santan444/MS-002P/03-设计开发输出阶段/02电子/05物料证书/12.交换机TEG1008M/TEG1008M.png

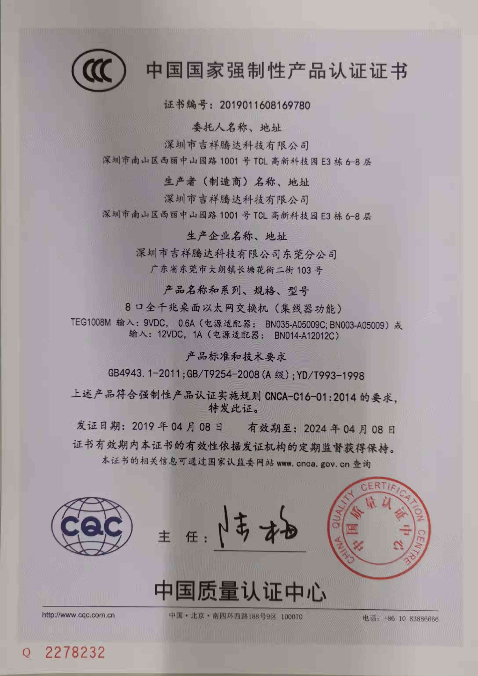
03-设计开发输出阶段/02电子/05物料证书/12.交换机TEG1008M/TEG1008M.png
