santan444/MS-002P/02-设计开发输入阶段/MS-002重要事项时间表.docx

文件号： | MS-002.10W012

重要事项时间表

骨科手术导航定位系统

MS-002

编制：

审核：

批准：

杭州三坛医疗科技有限公司

文档更改履历

版本号 | 发布/实施日期 | 更改内容概述 | 更改者
V1.0 | 2022.05.17 | 文件新编 | 洪洁

重要事项时间表

项目编号 MS-002

重要事项 | 状态 | 计划时间 | 调整后时间 | 实际时间
DCP0 | 已完成 | 2022.02 | / | 2022.02.08
TR1 | 已完成 | 2022.03 | / | 2022.03.29
DCP1 | 已完成 | 2022.03 | / | 2022.03.30
TR2 | 已完成 | 2022.04 | 2022.05 | 2022.05.17
DCP2 | 待完成 | 2022.04 | 2022.06 | /
TR3 | 待完成 | 2022.05 | 2022.06 | /
TR4 | 待完成 | 2022.08 | / | /
TR5 | 待完成 | 2022.11 | / | /
TR6 | 待完成 | 2023.01 | / | /
DCP3 | 待完成 | 2024.01~06 | / | /

MS-002 重要事项时间表 杭州三坛医疗科技有限公司
