santan444/MS-002P/02-设计开发输入阶段/评审类/MS-002TR2会议记录_20220517.docx

TR2评审纪要：@徐琦 @程焕 @严凌霄

系统方案设计，

1，部分器械，使用有效期50次，待确定；

2，加入反馈功能；

3，6.3，程序文件号+文件名，修改；

4，反光球，是否为一次性使用？以及何种无菌方式提供；

技术需求规格书，

1，6.2.4 爬电距离，绝缘路径，需要确定，是否修改？

2，6.9网络安全，进行补充；

3，非功能需求，6.1章节，加入UDI需求；

其他，

1，可用性任务分析，有更新H，请相应更新RAC；

记录编号：ST-ZD-52FM1 版本号：A/0 页码： 1 / 20
