santan444/MS-002P/03-设计开发输出阶段/04结构/03结构测试验证/MS-002台车外力失衡验证报告.docx

| 文件号： | | | | | MS-002.40W011

MS-002

台车外力失衡验证报告
编制人： | | | | 日期：
审核人： | | | | 日期：
批准人： | | | | 日期：

文档修订履历

版本号 | 发布日期 | 更改内容概述 | 更改者
V1.0 | 2022.xx.xx | 文件新编 | 钱华芳

保密条款

文档仅限产品（项目）组内流转，违者负相应法律责任。

目录

# 第1章 概述

## 1.1 验证目的

验证MS-002三台车在正常使用中，不应由于推拉、倚靠、搭放等外力原因造成失衡。

## 1.2 验证范围

验证范围为MS-002的三个台车：导航台车、操作台车和执行台车。

## 1.3 术语

无

## 1.4 法规标准

GB 9706.1-2020 《医用电气设备 第1部分：基本安全和基本性能的通用要求》

《MS-002技术需求规格书》

# 第2章 验证条件

## 2.1 验证对象

设备编号 | 设备名称 | 型号规格 | 备注
报告里写型检机编号 | MS-002导航台车 | MS-002-A
| MS-002执行台车 | MS-002-B
| MS-002操作台车 | MS-002-C

## 2.2 验证设备/工装/工具

设备编号 | 设备名称 | 型号规格 | 备注
/ | 推拉力计 | / | 量程200N以上
/ | 障碍物 | / | 最高不超过20mm
/ | 卷尺 | / | /
/ | 秒表 | / | /

## 2.3 验证地点

验证地点：车间。

## 2.4 验证时间

验证时间：2023年4月

## 2.5 验证环境

环境温度：10℃～30℃；

相对湿度：≤70%

## 2.6 验证小组

序号 | 岗位 | 验证人员 | 职责
1 | 机械工程师 | | 验证中的设备操作，进行相关过程数据记录，数据统计，编制报告
2 | 机械组主管 | | 审核报告

# 第3章 验证可接受准则

验证结果应符合GB/T 9706.1-2020 9.4.2.3章节指标要求，具体如下：

1) 在验证过程中，三台车均不发生失衡或者非预期的运动；

# 第4章 验证方法与步骤

## 4.1 验证方法

将三个台车放置在水平地面，并从除向上以外的任意方向对其施加等于其重量15%的外力，最大不超过150N。外力施加在台车的任意位置，但不超过距地面1.5m。使用一个水平方向的障碍物防止台车在地面上滑动，障碍物高度不超过20mm且紧固在地面上。施加外力包括前后左右周向力和向下的压力。

## 4.2 验证步骤

具体验证过程如下：

1. 将导航台车、执行台车和操作台车推到试验场地；
2. 将导航台车、执行台车和操作台车的脚轮刹车踩下；
3. 按照验证方案要求在台车不同位置施加周向力和向下的力，持续5s以上；施加周向力时，障碍物放置在脚轮前方并始终保持与周向力相对方向，防止台车受力过程中侧向移动；
4. 记录验证过程中台车的状况；

照片

# 第5章 验证结果与结论

验证结果记录如下表所示：

MS-002台车外力失衡验证记录表

结果记录
No. | 台车名称 | 施力方向 | 施力位置 | 施力大小 | 持续时间 | 结果
1 | 导航台车 | 前 | 外壳距离地面约1m四周 | 150N | 5s
| | 后 | | 150N | 5s
| | 左 | | 150N | 5s
| | 右 | | 150N | 5s
| | 上 | 把手上方 | 150N | 5s
2 | 执行台车 | 前 | 外壳距离地面约1m四周 | 150N | 5s
| | 后 | | 150N | 5s
| | 左 | | 150N | 5s
| | 右 | | 150N | 5s
| | 上 | 把手上方 | 150N | 5s
3 | 操作台车 | 前 | 工作台四周 | 130N | 5s
| | 后 | | 130N | 5s
| | 左 | | 130N | 5s
| | 右 | | 130N | 5s
| | 上 | 工作台上方 | 130N | 5s
4
5

根据以上结果可以得出结论：MS-002三台车设计满足法规要求，即在台车正常使用过程中，不会由于推拉、倚靠、搭放等外力原因造成失衡。

# 第6章 附件

N/A
