santan444/MS-002P/03-设计开发输出阶段/04结构/03结构测试验证/MS-002台车外壳推力验证报告.docx

| 文件号： | | | | | MS-002.40W017

MS-002

台车外壳推力验证报告
编制人： | | | | 日期：
审核人： | | | | 日期：
批准人： | | | | 日期：

文档修订履历

版本号 | 发布日期 | 更改内容概述 | 更改者
V1.0 | 2022.xx.xx | 文件新编

保密条款

文档仅限产品（项目）组内流转，违者负相应法律责任。

目录

# 第1章 概述

## 1.1 验证目的

验证MS-002三台车外壳是否有足够的刚度以避免不可接受的风险。

## 1.2 验证范围

MS-002的三台车（执行台车、导航台车、操作台车）外壳。

## 1.3 术语

无

## 1.4 法规标准

GB 9706.1-2020 《医用电气设备 第1部分：基本安全和基本性能的通用要求》

《MS-002技术需求规格书》

# 第2章 验证条件

## 2.1 验证对象

设备编号 | 设备名称 | 型号规格 | 备注
| MS-002导航台车 | MS-002-A
| MS-002执行台车 | MS-002-B
| MS-002操作台车 | MS-002-C

## 2.2 验证设备/工装/工具

设备编号 | 设备名称 | 型号规格 | 备注
/ | 推拉力计
| 秒表

## 2.3 验证地点

验证地点：公司实验室。

## 2.4 验证时间

验证时间：

## 2.5 验证环境

环境温度：10℃～30℃；

相对湿度：≤70%

；

## 2.6 验证小组

序号 | 岗位 | 验证人员 | 职责
1 | 机械工程师 | | 验证中的设备操作，进行相关过程数据记录，数据统计，编制报告
2 | 机械组主管 | | 审核报告

# 第3章 验证可接受准则

验证结果应符合GB/T 9706.1-2020 15.3.2章节指标要求，具体如下：

经过验证试验，外壳完好无损。

# 第4章 验证方法与步骤

## 4.1 验证方法

用直径为30mm的圆形平面试验工具，在外壳外部施加250N±10N的恒定作用力持续5s。

## 4.2 验证步骤

三台车的外壳上分别进行推力试验：

1) 将三台车推到开阔合适区域，脚轮刹住；
2) 在导航台车两侧面中间各选取一处相对薄弱区域，通过推拉力计施加250N±10N的恒定作用力持续5s，观察外壳变化；
3) 在执行台车两侧面中间各选取一处相对薄弱区域，通过推拉力计施加250N±10N的恒定作用力持续5s，观察外壳变化；
4) 在操作台车两侧面中间各选取一处相对薄弱区域，通过推拉力计施加250N±10N的恒定作用力持续5s，观察外壳变化；

# 第5章 验证结果与结论

经过上述推力测试后，台车外壳完好无损，表明外壳有足够的刚度以避免不可接受的风险。

补充照片
