santan444/MS-002P/03-设计开发输出阶段/04结构/03结构测试验证/MS-002台车越过门槛验证报告.docx

| 文件号： | | | | | MS-002.40W016

MS-002

台车越过门槛验证报告
编制人： | | | | 日期：
审核人： | | | | 日期：
批准人： | | | | 日期：

文档修订履历

版本号 | 发布日期 | 更改内容概述 | 更改者
V1.0 | 2023.xx.xx | 文件新编 | 陈侠

保密条款

文档仅限产品（项目）组内流转，违者负相应法律责任。

目录

# 第1章 概述

## 1.1 验证目的

验证MS-002三台车（超过45kg）是否可以越过10mm门槛且不导致失衡。

## 1.2 验证范围

MS-002的三个台车：导航台车、操作台车和执行台车。

## 1.3 术语

无

## 1.4 法规标准

GB 9706.1-2020 《医用电气设备 第1部分：基本安全和基本性能的通用要求》

《MS-002技术需求规格书》

# 第2章 验证条件

## 2.1 验证对象

设备编号 | 设备名称 | 型号规格 | 备注
| MS-002导航台车 | MS-002-A
| MS-002执行台车 | MS-002-B
| MS-002操作台车 | MS-002-C

## 2.2 验证设备/工装/工具

设备编号 | 设备名称 | 型号规格 | 备注
/ | 10x80x1000mm木板

## 2.3 验证地点

公司实验室。

## 2.4 验证时间

2022.xx~2023.xx

## 2.5 验证环境

环境温度：10℃～30℃；

相对湿度：≤70%

；

## 2.6 验证小组

序号 | 岗位 | 验证人员 | 职责
1 | 机械工程师 | | 验证中的设备操作，进行相关过程数据记录，数据统计，编制报告
2 | 机械组主管 | | 审核报告

# 第3章 验证可接受准则

验证结果应符合GB/T 9706.1-2020 9.4.2.4章节指标要求，具体如下：

正常推行MS-002三台车可以平稳越过10mm门槛且不发生失衡现象。

# 第4章 验证方法与步骤

## 4.1 验证方法

MS-002三台车重量都超过45kg，因此都需要进行过门槛试验。

MS-002三台车以正常使用的速度推行，向前越过一个紧固与地面的垂直固定障碍物10次（上去和下来），确认台车是否可以平稳通过并不发生失衡现象。障碍物横断面应是高10mm±0.5mm、宽至少80mm的矩形，且棱边倒圆角2mm±0.1mm；

## 4.2 验证步骤

MS-002三台车推到试验场地分别进行过门槛试验：

1) 将障碍物放置在试样场地开阔区域，两人分别踩住障碍物两端，确保试验过程中障碍物不轻易发生移动；
2) 将导航台车推到障碍物前一段距离静止，向前推动导航台车到一定速度越过障碍物；
3) 台车越过障碍物后停止并向后移动退出障碍物；
4) 重复上述步骤10次，目视台车是否可以完整越过障碍物以及过程中是否出现失衡现象；
5) 将执行台车、操作台车推到障碍物前，重复上述步骤并目视确认台车是否可以完整越过障碍物以及过程中是否出现失衡现象；

# 第5章 验证结果与结论

三台车分别都可以完整平稳越过障碍物，且过程中没有出现失衡等现象。

补充照片
