santan444/MS-002P/03-设计开发输出阶段/04结构/03结构测试验证/MS-002操作台车热仿真分析报告.docx

| 文件号： | | | | | MS-002.43W002

MS-002

操作台车热仿真分析报告
编制人： | | | | 日期：
审核人： | | | | 日期：
批准人： | | | | 日期：

文档修订履历

版本号 | 发布日期 | 更改内容概述 | 更改者
V1.0 | 2022.00.00 | 文件新编 | 陈侠

保密条款

文档仅限产品（项目）组内流转，违者负相应法律责任。

目录

# 1. 概述

操作台车主要电气件包括显示器、电源适配器、键盘、鼠标等，其中电源适配器对台车内温度影响较大。显示器、键盘、鼠标都是标准件且外露，不存在散热风险。

本次热仿真分析对实际模型进行一定程度的简化，忽略对空气流动、散热影响较小的结构，方便计算。

# 2. 模型优化

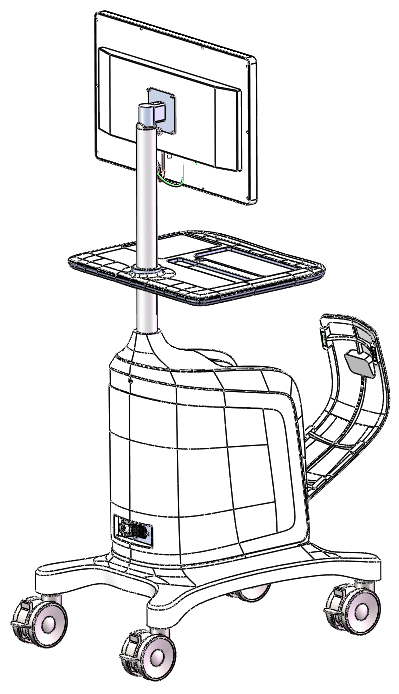
[picture p151: figure]
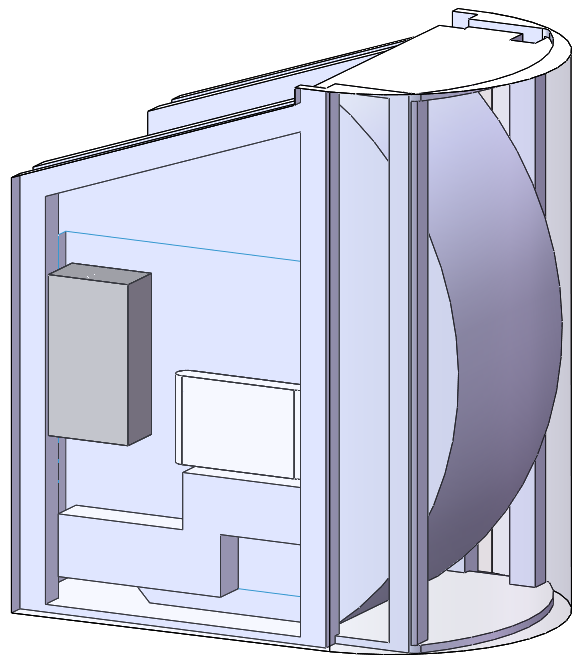
[picture p152: figure]

原始模型 简化模型

# 3. 边界条件

环境温度：操作台车通常在手术室内工作，环境温度一般恒温，本次分析定义为26℃。

热源：电源适配器对台车内温度影响较大，电气件的工作效率一般在80%~95%之间，本次分析定义其散热功率为其正常工作功率的10%，具体数值如下：

序号 | 名称 | 工作功率（W） | 发热率（W/m3）
1 | 显示器适配器 | 36 | 22857.1

整机电气件发热量少，通过自然热交换散热即可满足要求。

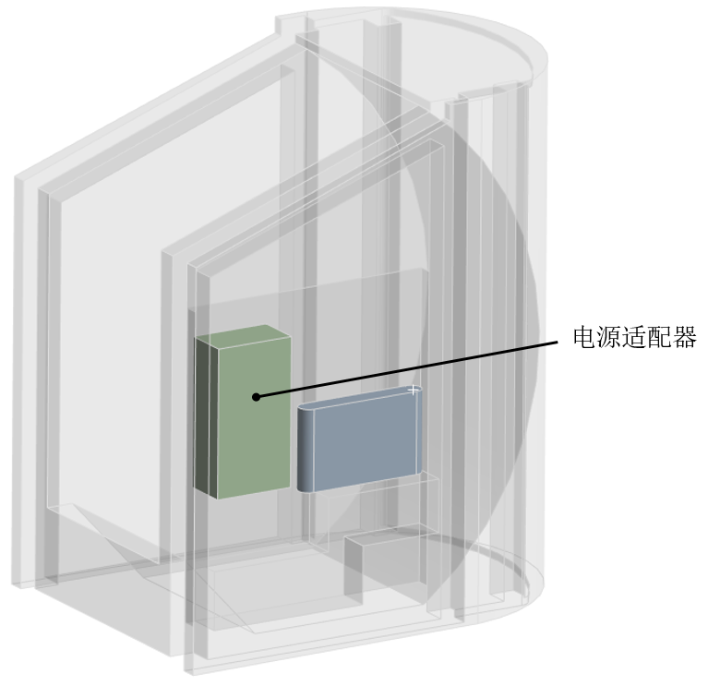
[picture p153: figure]

# 4. 仿真分析结果

台车内部最高温为30℃，位于电源适配器表面，同时腔内大部分温度为26.5℃左右。

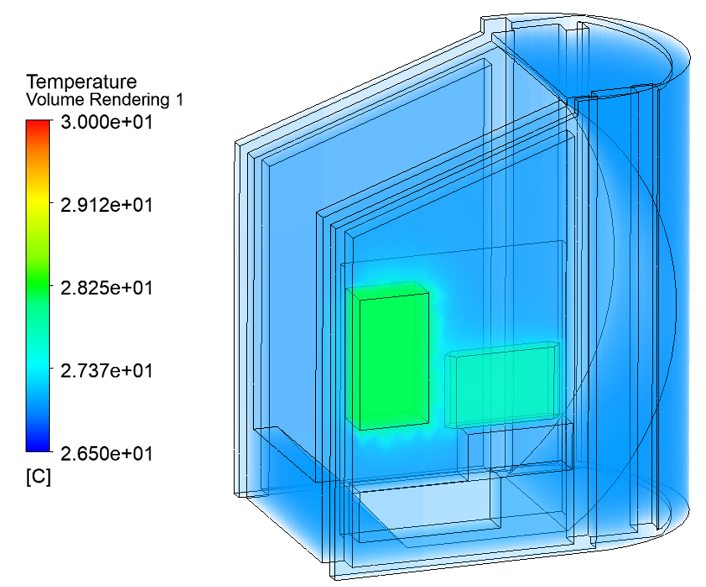
[picture p154: figure]

温度体积云图

# 5. 结论

操作台车内部空气温度仅上升0.5℃，基本可以忽略不计，符合工作温度要求。

MS-002.43W002 操作台车热仿真分析报告 杭州三坛医疗科技有限公司
