santan444/MS-002P/03-设计开发输出阶段/04结构/02包装及标签/MS-002 标签、标识粘贴说明.docx

| 文件号： | | | | | MS-002.40W007

MS-002

标签、标识粘贴说明
编制人： | | | | 日期：
审核人： | | | | 日期：
批准人： | | | | 日期：

文档修订履历

版本号 | 发布日期 | 更改内容概述 | 更改者
V1.0 | 2022.xx.xx | 文件新编 | 陈侠

保密条款

文档仅限产品（项目）组内流转，违者负相应法律责任。

目录

# 1. 标签粘贴位置

## 1.1. 导航台车

### 1.1.1. 标签粘贴位置

序号 | 标签 | 位置

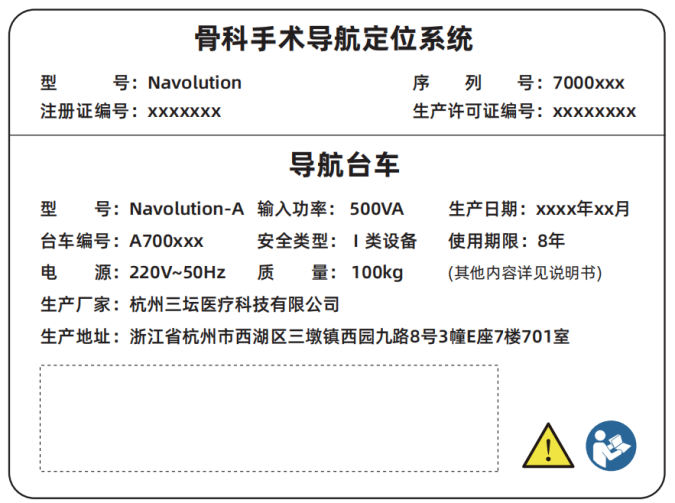
[picture p176: figure]

1

### 1.1.2. 标识粘贴位置

序号 | 标识 | 说明 | 位置
1 | | 显示器左右旋30°
3 | | 双目相机左右旋
4 | | 保护接地
5 | | 火线
6 | | 零线

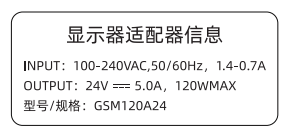
[picture p177: figure]

7 | | 显示器适配器信息 | 显示器适配器安装支架上
8 | | 导航台车-显示器 | 备注：标签需盖住所有按键（不能盖住指示灯）

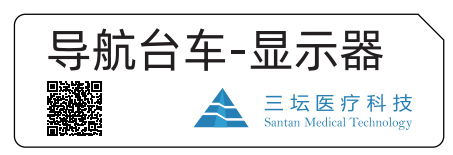
[picture p178: figure]

9 | | 导航台车-显示器 | 备注：贴标签时，需将原有全部标签撕下，并对撕下处进行处理，保证粘贴新标签时完好无损。
10 | | 鼠标收纳壳最大悬挂重量440g
11 | | 显示器支架最大悬挂重量29.2kg

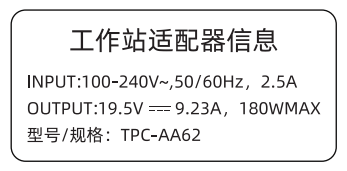
[picture p179: figure]

| | 工作站适配器信息

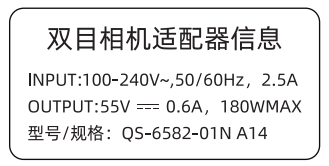
[picture p180: figure]

| | 双目相机适配器信息
| | 双目相机

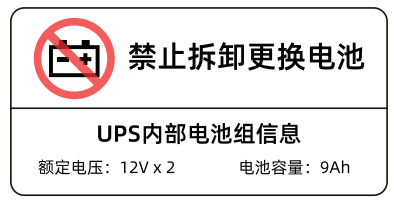
[picture p181: figure]

| | UPS

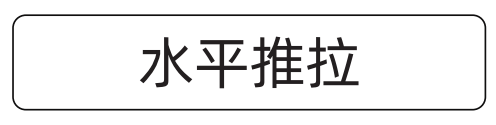
[picture p182: figure]

## 1.2. 执行台车

### 1.2.1. 标签粘贴位置

序号 | 标签 | 位置

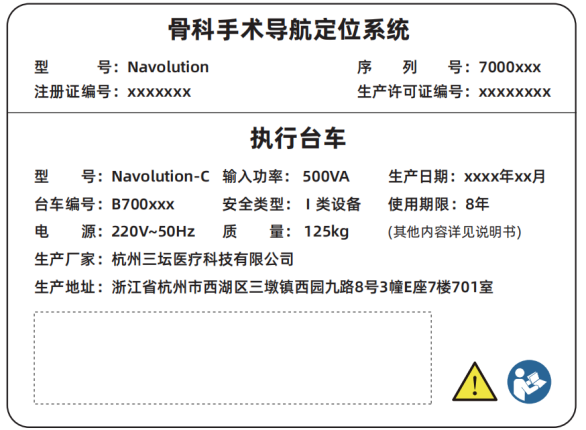
[picture p183: figure]

1

### 1.2.2. 标识粘贴位置

序号 | 标识信息 | 说明 | 位置
3 | | 保护接地
4 | | 功能接地
5 | | 火线
6 | | 零线
7 | | 机械臂最大负荷5kg

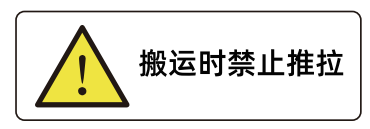
[picture p184: figure]

8 | | 移动台车时禁止推拉机械臂

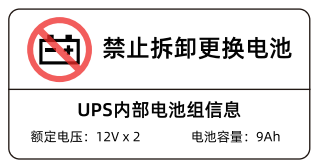
[picture p185: figure]

9 | | 禁止用户拆卸电池

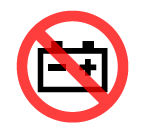
[picture p186: figure]

10 | | 注意电池极性，查看维护手册 | 备注：UPS改装时直接粘贴
11

## 1.3. 操作台车

### 1.3.1. 标签粘贴位置

序号 | 标签 | 位置

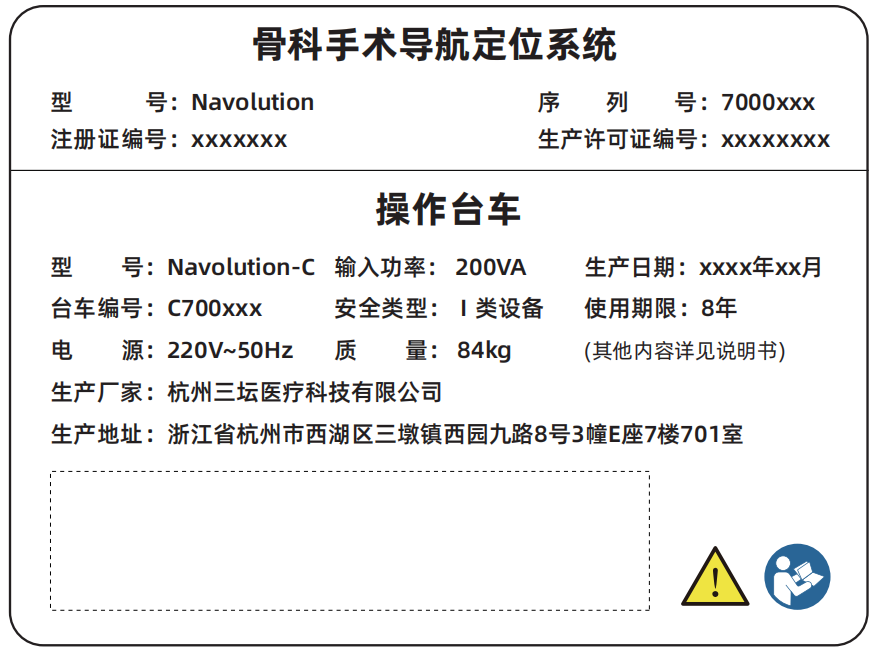
[picture p187: figure]

1

### 1.3.2. 标识粘贴位置

序号 | 标识信息 | 说明 | 位置
1
| | 保护接地
| | 功能接地
| | 火线
| | 零线
| | 显示器适配器信息 | 显示器适配器安装支架上

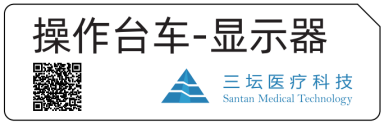
[picture p188: figure]

# 2. 标签、标识粘贴要求

1) 各标签粘贴在其相应位置；
2) 粘贴应平整、不歪斜、不翘起、标贴表面无损伤、无污染；
3) 不得多贴或少贴；

# 3. 标签、标识材质要求

1) 肖银龙不干胶
2) 背景哑银
3) 表面哑膜
