santan444/MS-002P/03-设计开发输出阶段/01系统/MS-002物理拓扑图.png

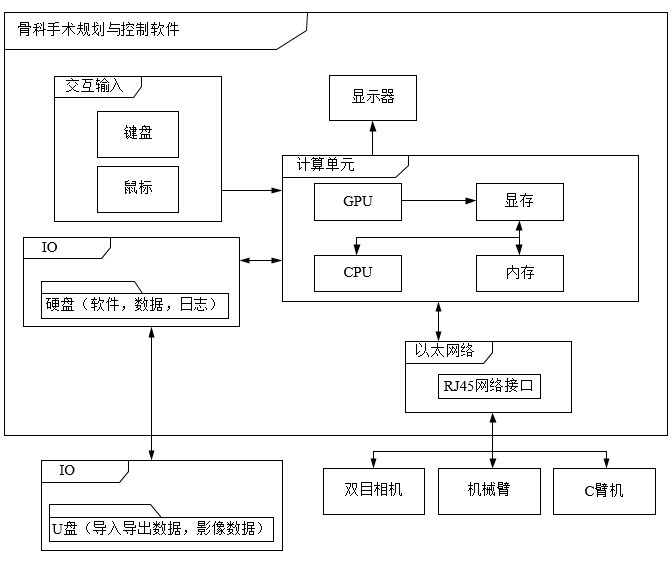
03-设计开发输出阶段/01系统/MS-002物理拓扑图.png
