santan444/MS-002P/03-设计开发输出阶段/02电子/05物料证书/7.脚踏/无线脚踏/TRE18090108  IEC60601-1-2 SUNS WIRELESS FOOT SWITCH.pdf

## TES

## ST REPO

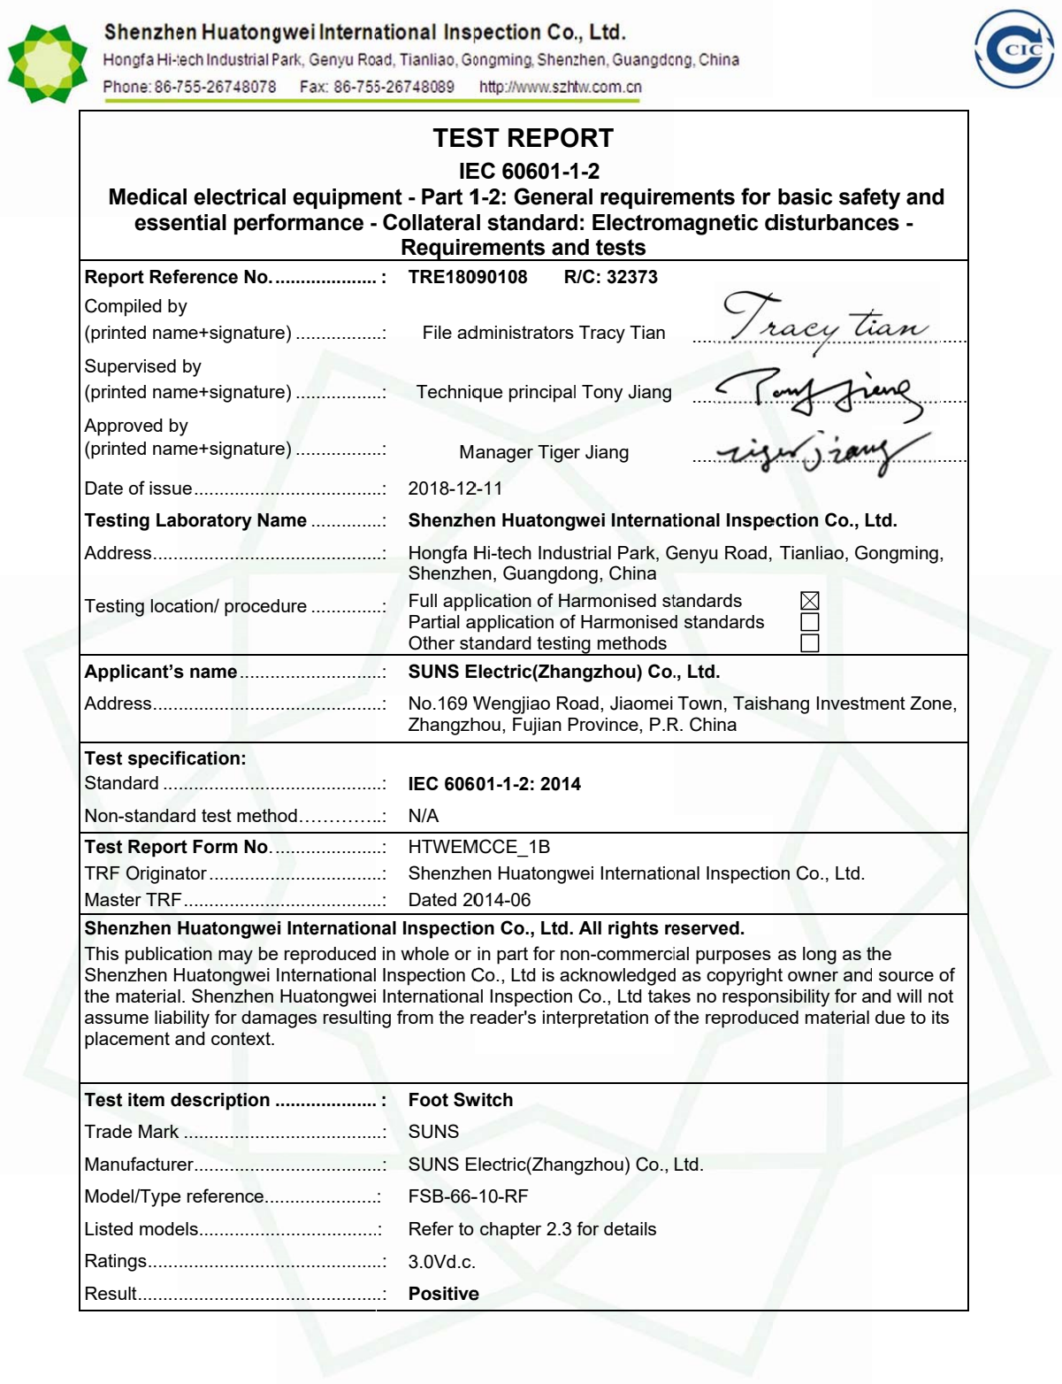
[picture p304: page 1]

### Medica esse

Report Ref
Compiled b
(printed nam
Supervised
(printed nam
Approved b
(printed nam

Date of issu
Testing La
Address .....

Testing loca

Applicant’s
Address .....

Test specif
Standard ...
Non-standa
Test Repor
TRF Origina
Master TRF
Shenzhen
This publica
Shenzhen H
the materia
assume liab
placement a

Test item d
Trade Mark
Manufacture
Model/Type
Listed mode
Ratings ......
Result ........

### al electrica ential perfo

ference No. .
y
me+signature
by
me+signature
y
me+signature
ue |
boratory Na

ation/ proced

s name ........

fication:
ard test meth
rt Form No. .
ator |
Huatongwe
ation may be
Huatongwei
l. Shenzhen
bility for dam
and context.

description .
er |
e reference...
els |

### al equipme ormance -

e) |
e) |
e) |
ame |
dure |
od |
i Internation
e reproduced
International
Huatongwei
ages resultin

IE

### ent - Part 1 Collatera Require

: TRE180

. : | File ad
. : | Techniq
. : | Ma

. : 2018-12
. : Shenzhe
. : Hongfa H
| Shenzhe
. : Full appl
| Partial a Other sta

. : SUNS E
. : No.169 W
| Zhangzh

. : IEC 606
.: N/A
. : HTWEM
. : Shenzhe
. : Dated 20
nal Inspectio
in whole or
Inspection C
Internationa
ng from the r

: Foot Sw
. : SUNS
. : SUNS E
: | FSB-66-
: | Refer to
. : 3.0Vd.c.
. : Positive

EC 60601-1

### -2: Gener l standard ements an

090108 R

dministrators

que principal

anager Tige

-11
en Huatong
Hi-tech Indus
en, Guangdo
lication of Ha
application of
andard testin
Electric(Zhan
Wengjiao Ro
hou, Fujian P

01-1-2: 2014

MCCE_1B
en Huatongw
014-06
on Co., Ltd.
in part for no
Co., Ltd is ac
al Inspection
reader's inter

witch

Electric(Zhang
10-RF
chapter 2.3

## ORT

-2

### ral require d: Electrom nd tests

R/C: 32373

Tracy Tian

l Tony Jiang

r Jiang

gwei Internat
strial Park, G
ong, China
armonised st
f Harmonised
ng methods
ngzhou) Co.
oad, Jiaomei
Province, P.R

wei Internatio

All rights re
on-commerci
cknowledged
Co., Ltd take
rpretation of

gzhou) Co.,

for details

### ments for magnetic d

tional Inspe
Genyu Road,

tandards
d standards

., Ltd.
Town, Taish
. China

onal Inspectio

eserved.
ial purposes
d as copyrigh
es no respon
the reproduc

Ltd.

### basic safe disturbanc

ection Co., L
Tianliao, Go

hang Investm

on Co., Ltd.

as long as t
ht owner and
nsibility for a
ced material

### ety and ces -

Ltd.
ongming,

ment Zone,

he
source of
nd will not
due to its

Report No.: TRE18090108 | Page 2 of 30 | Issued: 2018-12-11

## EMC -- T E S T R E P O R T

Test Report No. : | TRE18090108 | 2018-12-11 ______________________________________________________________________________________________ Date of issue
Equipment under Test | : | Foot Switch
Model /Type | : | FSB-66-10-RF
Listed Models | : | Refer to chapter 2.3 for details
Applicant | : | SUNS Electric(Zhangzhou) Co., Ltd.
Address | : | No.169 Wengjiao Road, Jiaomei Town, Taishang Investment Zone, Zhangzhou, Fujian Province, P.R. China
Manufacturer | : | SUNS Electric(Zhangzhou) Co., Ltd.
Address | : | No.169 Wengjiao Road, Jiaomei Town, Taishang Investment Zone, Zhangzhou, Fujian Province, P.R. China

Test Result according to the
standards on page 4: | Positive

The test report merely corresponds to the test sample.
It is not permitted to copy extracts of these test result without the written permission of the test laboratory.

Report No.: TRE18090108 | Page 3 of 30 | Issued: 2018-12-11

## Contents

1. ! T E S T S T A N D A R D S | 4 !
2. ! SUMMARY | 5 !
2.1.! | General Remarks | 5!
2.2.! | Equipment Under Test | 5!
2.3.! | Short description of the Equipment under Test (EUT) | 5!
2.4.! | EUT operation mode | 5!
2.5.! | EUT configuration | 6!
2.6.! | IMMUNITY pass/fail criteria: | 6!
3. ! T E S T E N V I R O N M E N T | 7 !
3.1.! | Address of the test laboratory | 7!
3.2.! | Test Facility | 7!
3.3.! | Environmental conditions | 8!
3.4.! | Test Description | 8!
3.5.! | Statement of the measurement uncertainty | 12!
3.6.! | Equipments used during the Test | 13!
4. ! TEST CONDITION S AND RESU L T S | 1 5 !
4.1.! | Radiated Emission | 15!
4.2.! | Conducted disturbance | 19!
4.3.! | Harmonic current | 19!
4.4.! | Voltage Fluctuation and Flicker | 19!
4.5.! | Electrostatic discharge | 20!
4.6.! | Radiated, radio-frequency, electromagnetic field | 22!
4.7.! | Electrical fast transients / Burst | 24!
4.8.! | Surge | 24!
4.9.! | Conducted disturbances induced by radio-frequency fields | 24!
4.10.! Magnetic Field Immunity | 25!
4.11.! Voltage Dips and Interruptions | 26!
5. ! EXTERNAL AND INTERNAL PH O T O S O F T H E E U T | 2 7 !
5.1.! | External Photos of the EUT | 27!
5.2.! | Internal photos of the EUT | 29!

Report No.: TRE18090108 | Page 4 of 30 | Issued: 2018-12-11

## 1 . T E S T S T A N D A R D S

The tests were performed according to following standards:

IEC 60601-1-2: 2014 Medical electrical equipment - Part 1-2: General requirements for basic safety and essential performance - Collateral standard: Electromagnetic disturbances - Requirements and tests

Remark: This EUT is ranged to the Group 1 Class B apparatus according to the standard of CISPR 11: 2015+A1: 2016 clause 5.2.

Report No.: TRE18090108 | Page 5 of 30 | Issued: 2018-12-11

## 2 . S U M M A R Y

### 2.1. General Remarks

Date of receipt of test sample | : | 2018-12-04
Testing commenced on | : | 2018-12-04
Testing concluded on | : | 2018-12-11

### 2.2. Equipment Under Test

### Power supply system utilised

Power supply voltage | : o 230V / 50 Hz | o 120V / 60Hz
o 12 V DC | o 24 V DC
■ Other (specified in blank below)

3.0Vd.c.(internal battery)

### 2.3. Short description of the Equipment under Test (EUT)

The EUT is a foot switch.

It’s applicable for use with medical equipment.

Tests were carried out on model FSB-66-10-RF to represent all other foot switches series: FS-2, FS-6, FS-7, FS-8, FS-9, FCP, FSB, FSR, FWC series. All these foot switch models use exactly the same PCB circuit and RF receiver.

LOT No.: 2018-10-22

### 2.4. EUT operation mode

The equipment under test was operated during the measurement under the following conditions:

Test with frequency wireless supplied by 12V battery.

The EUT is measuring during the test.

Test program (customer specific)

Emissions tests | : According to IEC 60601-1-2 searching for the highest disturbance.
Immunity tests | : According to IEC 60601-1-2 searching for the highest susceptivity.
Harmonics current | : Not performed according to IEC 61000-3-2.
Voltage fluctuation………: Not performed according to IEC 61000-3-3.

Report No.: TRE18090108 | Page 6 of 30 | Issued: 2018-12-11

### 2.5. EUT configuration

The following peripheral devices and interface cables were connected during the measurement:

■ - supplied by the manufacturer

o - supplied by the lab

### 2.6. IMMUNITY pass/fail criteria:

Examples of test failures:
– malfunction;
– non-operation when operation is required;
– unwanted operation when no operation is required;
– deviation from normal operation that poses an unacceptable RISK to the PATIENT or OPERATOR; – component failures;
– change in programmable parameters;
– reset to factory defaults (MANUFACTURER’s presets);
– change of operating mode;
– a FALSE POSITIVE ALARM CONDITION;
– a FALSE NEGATIVE ALARM CONDITION (failure to alarm);
– cessation or interruption of any intended operation, even if accompanied by an ALARM SIGNAL; – initiation of any unintended operation, including unintended or uncontrolled motion, even if accompanied by an ALARM SIGNAL;
– error of a displayed numerical value sufficiently large to affect diagnosis or treatment;
– noise on a waveform in which the noise would interfere with diagnosis, treatment or monitoring; – artefact or distortion in an image in which the artefact would interfere with diagnosis, treatment or monitoring;
– failure of automatic diagnosis or treatment ME EQUIPMENT or ME SYSTEM to diagnose or treat, even if accompanied by an ALARM SIGNAL.

During the test, frequency wireless is abnormal response.

■ Frequency wireless | Manufacture : SUNS Electric(Zhangzhou) Co., Ltd. M/N : RCV-RF-10A-6

## 3 . T E S T E N V I R O N M E N T

### 3.1. Address of the test laboratory

Shenzhen Huatongwei International Inspection Co., Ltd.
Hongfa Hi-tech Industrial Park, Genyu Road, Tianliao, Gongming, Shenzhen, Guangdong, China Tel: 86-755-26748019 Fax: 86-755-26748089

### 3.2. Test Facility

The test facility is recognized, certified, or accredited by the following organizations:

### CNAS-Lab Code: L1225

Shenzhen Huatongwei International Inspection Co., Ltd. has been assessed and proved to be in compliance with CNAS-CL01 Accreditation Criteria for Testing and Calibration Laboratories (identical to ISO/IEC 17025: 2005 General Requirements) for the Competence of Testing and Calibration Laboratories,

### A2LA-Lab Cert. No. 3902.01

Shenzhen Huatongwei International Inspection Co., Ltd. EMC Laboratory has been accredited by A2LA for technical competence in the field of electrical testing, and proved to be in compliance with ISO/IEC 17025: 2005 General Requirements for the Competence of Testing and Calibration Laboratories and any additional program requirements in the identified field of testing.

### FCC-Registration No.: 762235

Shenzhen Huatongwei International Inspection Co., Ltd. EMC Laboratory has been registered and fully described in a report filed with the FCC (Federal Communications Commission). The acceptance letter from the FCC is maintained in our files. Registration No: 762235.

### IC-Registration No.: 5377B-1, 5377B-2

Two 3m Alternate Test Site of Shenzhen Huatongwei International Inspection Co., Ltd. has been registered by Certification and Engineering Bureau of Industry Canada for the performance of radiated measurements with Registration No. 5377B.

### ACA

Shenzhen Huatongwei International Inspection Co., Ltd. EMC Laboratory can also perform testing for the Australian C-Tick mark as a result of our A2LA accreditation.

### VCCI

Radiated disturbance above 1GHz measurement of Shenzhen Huatongwei International Inspection Co., Ltd. has been registered in accordance with the Regulations for Voluntary Control Measures with Registration No.: G-20007.

Main Ports Conducted Interference Measurement of Shenzhen Huatongwei International Inspection Co., Ltd. Has been registered in accordance with the Regulations for Voluntary Control Measures with Registration No.: C-20001.

Telecommunication Ports Conducted Interference Measurement of Shenzhen Huatongwei International Inspection Co., Ltd. has been registered in accordance with the Regulations for Voluntary Control Measures with Registration No.: T-20001.

The 3m Semi-anechoic chamber (9.1m×6.4m×6.0m) of Shenzhen Huatongwei International Inspection Co., Ltd. has been registered in accordance with the Regulations for Voluntary Control Measures with Registration No.:R-4398.

Report No.: TRE18090108 | Page 8 of 30 | Issued: 2018-12-11

### 3.3. Environmental conditions

During the measurement the environmental conditions were within the listed ranges:

Temperature: | 22-25°C
Humidity: | 40-58 %
Atmospheric pressure: | 950-1050mbar

### 3.4. Test Description

Emission Measurement
Radiated Emission | IEC 60601-1-2: 2014 CISPR 11: 2015+A1: 2016 | PASS
Conducted Disturbance (0.15-30MHz) | IEC 60601-1-2: 2014 CISPR 11: 2015+A1: 2016 | N/A
Harmonic Current | IEC 60601-1-2: 2014 IEC 61000-3-2: 2014 | N/A
Voltage Fluctuation and Flicker | IEC 60601-1-2: 2014 IEC 61000-3-3: 2013 | N/A

Immunity Measurement
Electrostatic Discharge | IEC 60601-1-2: 2014 IEC 61000-4-2: 2008 | PASS
RF Field Strength Susceptibility (80~2700MHz) | IEC 60601-1-2: 2014 IEC61000-4-3: 2006+A1: 2007+A2: 2010 | PASS
Electrical Fast Transient/Burst Test | IEC 60601-1-2: 2014 IEC 61000-4-4: 2012 | N/A
Surge Test | IEC 60601-1-2: 2014 IEC 61000-4-5: 2014 | N/A
Conducted Susceptibility Test | IEC 60601-1-2: 2014 IEC 61000-4-6: 2013 | N/A
Power Frequency Magnetic Field Susceptibility Test | IEC 60601-1-2: 2014 IEC 61000-4-8: 2009 | PASS
Voltage Dips and Interruptions Test | IEC 60601-1-2: 2014 IEC 61000-4-11: 2004 | N/A

Note: “N/A” means “not applicable”.
The measurement uncertainty is not included in the test result.

Report No.: TRE18090108 | Page 9 of 30 | Issued: 2018-12-11
| IEC 60601-1-2: 2014
Clause | Requirement + Test | Result - Remark | Verdict
5 ME EQUIPMENT and ME SYSTEMS identification, marking and | documents | | PASS
5.1 Additional requirements for marking on the outside of ME EQUIPMENT | and ME SYSTEMS that are specified for use only in a shielded location SPECIAL ENVIRONMENT | | N/A
| In addition to the requirements of 7.2 of the general standard, ME EQUIPMENT and ME SYSTEMS specified for use only in a shielded location SPECIAL ENVIRONMENT shall be labelled with a CLEARLY LEGIBLE warning that they should be used only in the specified type of shielded location. | | N/A
5.2 | ACCOMPANYING DOCUMENTS | | PASS
5.2.1 | Instructions for use | | PASS
5.2.1.1 | General | | PASS
a) a statement of the environments for which the | ME EQUIPMENT or ME SYSTEM is suitable. Relevant exclusions, as determined by RISK ANALYSIS, shall also be listed, e.g. hospitals except for near active HF SURGICAL EQUIPMENT and the RF shielded room of an ME SYSTEM for magnetic resonance imaging, where the intensity of EM DISTURBANCES is high. | Please refer to User manual | PASS
b) the performance of the ME EQUIPMENT or | ME SYSTEM that was determined to be ESSENTIAL PERFORMANCE and a description of what the OPERATOR can expect if the ESSENTIAL PERFORMANCE is lost or degraded due to EM DISTURBANCES (the defined term “ESSENTIAL PERFORMANCE” need not be used). | Please refer to User manual | PASS
c) a warning statement to the effect that | “WARNING: Use of this equipment adjacent to or stacked with other equipment should be avoided because it could result in improper operation. If such use is necessary, this equipment and the other equipment should be observed to verify that they are operating normally.” The MANUFACTURER of the ME EQUIPMENT or ME SYSTEM may provide a description or list of equipment with which the ME EQUIPMENT or ME SYSTEM has been tested in a stacked or adjacent configuration and with which stacked or adjacent use resulted in normal operation. | Please refer to User manual | PASS

Report No.: TRE18090108 | Page 10 of 30 | Issued: 2018-12-11
d) a list of all cables and maximum lengths of | cables (if applicable), transducers and other ACCESSORIES that are replaceable by the RESPONSIBLE ORGANIZATION and that are likely to affect compliance of the ME EQUIPMENT or ME SYSTEM with the requirements of Clause 7 (EMISSIONS) and Clause 8 (IMMUNITY). ACCESSORIES may be specified either generically (e.g. shielded cable, load impedance) or specifically (e.g. by MANUFACTURER and MODEL OR TYPE REFERENCE). Transducers and cables specified by the MANUFACTURER of the ME EQUIPMENT or ME SYSTEM as replacement parts for internal components need not be listed. | Please refer to User manual | PASS
e) a warning statement to the effect that | “WARNING: Use of accessories, transducers and cables other than those specified or provided by the manufacturer of this equipment could result in increased electromagnetic emissions or decreased electromagnetic immunity of this equipment and result in improper operation.” | Please refer to User manual | PASS
f) a warning statement to the effect that: | “WARNING: Portable RF communications equipment (including peripherals such as antenna cables and external antennas) should be used no closer than 30 cm (12 inches) to any part of the [ME EQUIPMENT or ME SYSTEM], including cables specified by the manufacturer. Otherwise, degradation of the performance of this equipment could result.” In the above warning, “[ME EQUIPMENT or ME SYSTEM]” shall be replaced with the MODEL OR TYPE REFERENCE of the ME EQUIPMENT or ME SYSTEM. | Please refer to User manual | PASS
| If higher IMMUNITY TEST LEVELS than those specified in Table 9 are used, the minimum separation distance may be lowered. Lower minimum separation distances shall be calculated using the equation specified in 8.10. | | N/A
5.2.1.2 | Requirements applicable to ME EQUIPMENT and ME SYSTEMS classified class A according to CISPR 11 | | N/A

In addition to the requirements of 7.9.2 of the general standard, for ME EQUIPMENT and ME SYSTEMS that are classified class A according to CISPR 11, the instructions for use shall include the following note:
The EMISSIONS characteristics of this equipment make it suitable for use in industrial areas and hospitals (CISPR 11 class A). If it is used in a residential environment (for which CISPR 11 class B is normally required) this equipment might not offer adequate protection to radio-frequency communication services. The user might need to take mitigation measures, such as relocating or re-orienting the equipment.

N/A

5.2.2 | Technical description | PASS
5.2.2.1 | Requirements applicable to all ME EQUIPMENT and ME SYSTEMS | PASS

Report No.: TRE18090108 | Page 11 of 30 | Issued: 2018-12-11
| In addition to the requirements of 7.9.3 of the general standard, the technical description shall describe precautions to be taken to prevent adverse events to the PATIENT and OPERATOR due to ELECTROMAGNETIC DISTURBANCES. For all ME EQUIPMENT and ME SYSTEMS, the technical description shall include the following information:
a) the compliance for each EMISSIONS and | IMMUNITY standard or test specified by this collateral standard, e.g. EMISSIONS class and group and IMMUNITY TEST LEVEL. | Please refer to User manual | PASS
b) any deviations from this collateral standard | and allowances used. | | N/A
c) all necessary instructions for maintaining | BASIC SAFETY and ESSENTIAL PERFORMANCE with regard to ELECTROMAGNETIC DISTURBANCES for the EXPECTED SERVICE LIFE. | Please refer to User manual | PASS
5.2.2.2 | Requirements applicable to ME EQUIPMENT and ME SYSTEMS specified for use only in a shielded location SPECIAL ENVIRONMENT | | N/A
| In addition to the requirements of 7.9.3 of the general standard, for ME EQUIPMENT and ME SYSTEMS specified for use only in a shielded location (see 7.1.5), the technical description shall include the following information: | | N/A
a) a warning to the effect that: “WARNING: | Failure to use this equipment in the specified type of shielded location could result in degradation of the performance of this equipment, interference with other equipment or interference with radio services”; | | N/A
b) specifications for the shielded location, | including: – minimum RF shielding effectiveness; – for each cable that enters or exits the shielded location, the minimum RF filter attenuation; and – the frequency range(s) over which the specifications apply; | | N/A
c) recommended test methods for measurement | of RF shielding effectiveness and RF filter attenuation; | | N/A
d) one or more of the following and a | recommendation that a notice containing this information be posted at the entrance(s) to the shielded location: – a specification of the EMISSIONS characteristics of other equipment allowed inside the shielded location with the ME EQUIPMENT or ME SYSTEM; – a list of specific equipment allowed; – a list of types of equipment prohibited. | | N/A
5.2.2.3 | Requirements applicable to ME EQUIPMENT that intentionally receives RF electromagnetic energy for the purpose of its operation | | N/A
| In addition to the requirements of 7.9.3 of the general standard, for ME EQUIPMENT that intentionally receives RF electromagnetic energy for the purpose of its operation (RF receivers), the technical description shall include the following information: | | N/A

Report No.: TRE18090108 | Page 12 of 30 | Issued: 2018-12-11
| – each frequency or frequency band of reception; – the preferred frequency or frequency band, if applicable; – the bandwidth of the receiving section of the ME EQUIPMENT in those bands.
5.2.2.4 | Requirements applicable to ME EQUIPMENT that includes RF transmitters | N/A
| In addition to the requirements of 7.9.3 of the general standard, for ME EQUIPMENT that includes RF transmitters, the technical description shall include each frequency or frequency band of transmission, the type and frequency characteristics of the modulation and the EFFECTIVE RADIATED POWER | N/A
5.2.2.5 | Requirements applicable to PERMANENTLY INSTALLED LARGE ME EQUIPMENT and LARGE ME SYSTEMS | N/A
| In addition to the requirements of 7.9.3 of the general standard, for PERMANENTLY INSTALLED LARGE ME EQUIPMENT and LARGE ME SYSTEMS for which the exemption specified in 8.6 from the testing requirements of IEC 61000-4-3 is used, the technical description shall include the following information: | N/A
a) a statement that an exemption has been used | and that the equipment has not been tested for radiated RF IMMUNITY over the entire frequency range 80 MHz to 6 000 MHz; | N/A
b) a warning to the effect that “WARNING: This | equipment has been tested for radiated RF immunity only at selected frequencies, and use nearby of emitters at other frequencies could result in improper operation”; | N/A
c) a list of the frequencies and modulations used | to test the IMMUNITY of the ME EQUIPMENT or ME SYSTEM. | N/A
5.2.2.6 | Requirements applicable to ME EQUIPMENT and ME SYSTEMS that claim compatibility with HF SURGICAL EQUIPMENT | N/A
| In addition to the requirements of 7.9.3 of the general standard, for ME EQUIPMENT and ME SYSTEMS that claim compatibility with HF SURGICAL EQUIPMENT, the technical description shall include a statement of HF SURGICAL EQUIPMENT compatibility and the conditions of INTENDED USE during HF surgery. | N/A

### 3.5. Statement of the measurement uncertainty

The data and results referenced in this document are true and accurate. The reader is cautioned that there may be errors within the calibration limits of the equipment and facilities. The measurement uncertainty was calculated for all measurements listed in this test report acc. to CISPR 16 - 4 „Specification for radio disturbance and immunity measuring apparatus and methods – Part 4: Uncertainty in EMC Measurements“ and is documented in the Shenzhen Huatongwei International Inspection Co., Ltd quality system acc. to DIN EN ISO/IEC 17025. Furthermore, component and process variability of devices similar to that tested may result in additional deviation. The manufacturer has the sole responsibility of continued compliance of the device.

Hereafter the best measurement capability for Shenzhen Huatongwei laboratory is reported:

Test | Range | Measurement Uncertainty | Notes
Radiated Emission | 30~1000MHz | 4.28 dB | (1)

Report No.: TRE18090108 | Page 13 of 30 | Issued: 2018-12-11
(1) This uncertainty represents an expanded uncertainty expressed at approximately the 95% confidence level using a coverage factor of k=2.

### 3.6. Equipments used during the Test

Radiated Emission/ Radiated power
Item | Test Equipment | Manufacturer | Model No. | Serial No. | Last Cal. | Next Cal.
1 | Ultra-Broadband Antenna | SCHWARZB ECK | VULB9163 | 538 | 4/5/2017 | 4/4/2020
2 | Emi Test Receiver | R&S | ESCI | 100900 | 2018/10/28 | 2019/10/28
3 | Pre-amplifer | SCHWARZB ECK | BBV 9742 | N/A | 11/14/2018 | 11/14/2019
4 | Turntable | Maturo Germany | TT2.0-1T | / | N/A | N/A
5 | Antenna Mast | Maturo Germany | CAM-4.0-P-12 | / | N/A | N/A
6 | Test Software | R&S | ES-K1 | / | N/A | N/A

Electrostatic Discharge
Item | Test Equipment | Manufacturer | Model No. | Serial No. | Last Cal. | Next Cal.
1 | ESD Simulator | DITO | 0301-04 | P1251107888 | 2018/8/17 | 2019/8/17

Report No.: TRE18090108 | Page 14 of 30 | Issued: 2018-12-11

RF Field Strength Susceptibility
Item | Test Equipment | Manufacturer | Model No. | Serial No. | Last Cal. | Next Cal.
1 | Signal Generator | R&S | SMB100A | 114360 | 8/21/2018 | 8/21/2019
2 | Amplifier | R&S | BBA150-BC500 | 102664 | 8/21/2018 | 8/21/2019
3 | Amplifier | R&S | BBA150 D200 | 102728 | 1/31/2018 | 1/31/2019
4 | Amplifier | R&S | BBA150 E200 | 102729 | 1/31/2018 | 1/31/2019
5 | Power Head | R&S | NRP18A | 101010 | 8/21/2018 | 8/21/2019
6 | Power Head | R&S | NRP18A | 101011 | 8/21/2018 | 8/21/2019
7 | Transmit Antenna | Schwarzbeck | STLP9129 | 00044 | 7/12/2017 | 7/12/2020
8 | Field Probe | ETS-LINDGREN | HI-6153 | 00130812 | 2018/1/17 | 2019/1/16
9 | Test Software | R&S | EMC32 | 100916 | NA | NA

Power Frequency Magnetic Field Susceptibility
Item | Test Equipment | Manufacturer | Model No. | Serial No. | Last Cal. | NextCal.
1 | Ultra Compact Simulator | EM TEST | UCS500M6 | 202304/060 | 2018/10/27 | 2019/10/27
2 | Motor Driven Voltage Transformer | EM TEST | MV2616 | 302205 | 2018/10/27 | 2019/10/27
3 | Current Transformer | EM TEST | MC2630 | D5101 | 2018/11/2 | 2019/11/2
4 | Magnetic Coil | EM TEST | MS100 | 0010230A | 2018/11/2 | 2019/11/2
5 | Test Software | EM TEST | ISM IEC | N/A | N/A | N/A

Report
4 . T E

### 4.1. Ra

For test in

### 4.1.1. D

Test locat

### 4.1.2. Li

No

### 4.1.3. D

4.1.3.1.

The EU
recorde

4.1.3.2.
EUT is t
turntabl
level. EU
down fro
polariza
4.1.3.3.

No.: TRE18

## ST C O

### adiated Em

nstruments a
Description o

tion: Shield

imits of dist

Frequency (MHz) | Distance ( (Meters) | Field Stre engths Limi its (dBµV/m )
30 ~ 23 30 | 3 | 40
230 ~ 10 000 | 3 | 47

te: (1) The t
(2) Distan
closest p
Description o
Operating C

UT is turned
ed.

Test Configu
tested in Sem
e. The turnta
UT is set 3 m
om 1 to 4 me
ations of the a
Photos of th

090108

## O NDIT I

### mission

and accessor
of the test lo

ded room No

turbance (C

tighter limit s
nce refers to
point of any p
of the test se
Condition

on and meas

uration and P
mi-Anechoic
able can rota
meters away
eter to find o
antenna are
e test set-up

## I ONS A

ries used see
ocation

. 6

lass B)

hall apply at
o the distance
part of the E.U
et-up

suring during

Procedure
Chamber. E
ate 360 degre
from the cen
ut the maxim
set on the te

Page 1

## A ND R

e section 3.6

t the edge be
e in meters b
U.T.

g the test and

EUT is placed
ees to determ
nter of receiv
mum emissio
est.

### 5 of 30

## ESUL T

etween two fr
between the

d the maxim

d on a nonm
mine the azim
ving antenna
on level. Both

T S

requency ba
test instrume

um emanatin

etal table ab
muth of the m
. The antenn
h horizontal a

Issued: 2

nds.
ent antenna

ng results are

bove a groun
maximum em
na can move
and vertical

018-12-11

and the

e

ded
mission
e up and

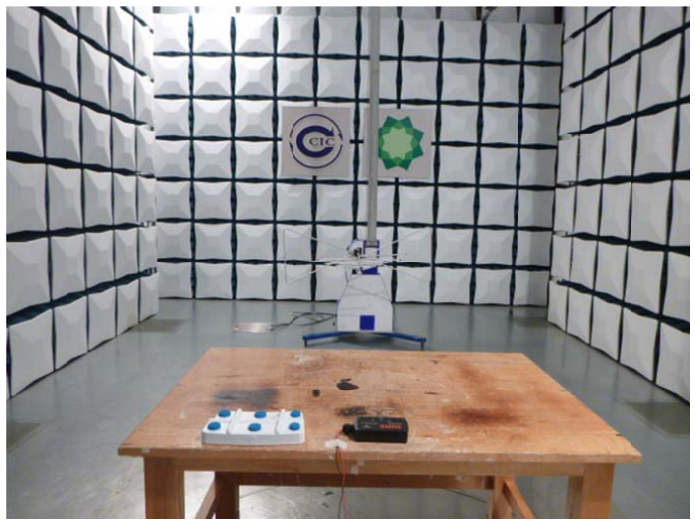
[picture p305: figure]

Report No.: TRE18090108 | Page 16 of 30 | Issued: 2018-12-11

### 4.1.4. Test result

The requirements are Fulfilled

Band Width: 120kHz

Frequency Range: 30MHz to 1000MHz

Remarks: The limits are kept. For detailed results, please see the following page(s).

Margin=limit-level

Level=read values+transducer

Transducer=antenna factor+pre-amplifier factor+cable loss

Report No.: TRE18090108 | Page 17 of 30 | Issued: 2018-12-11

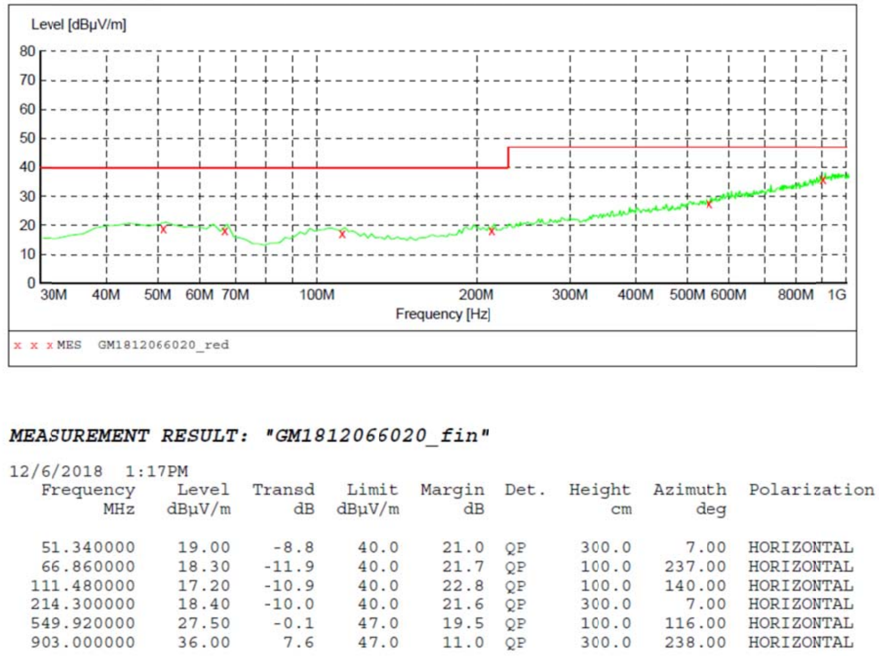
[picture p306: figure]

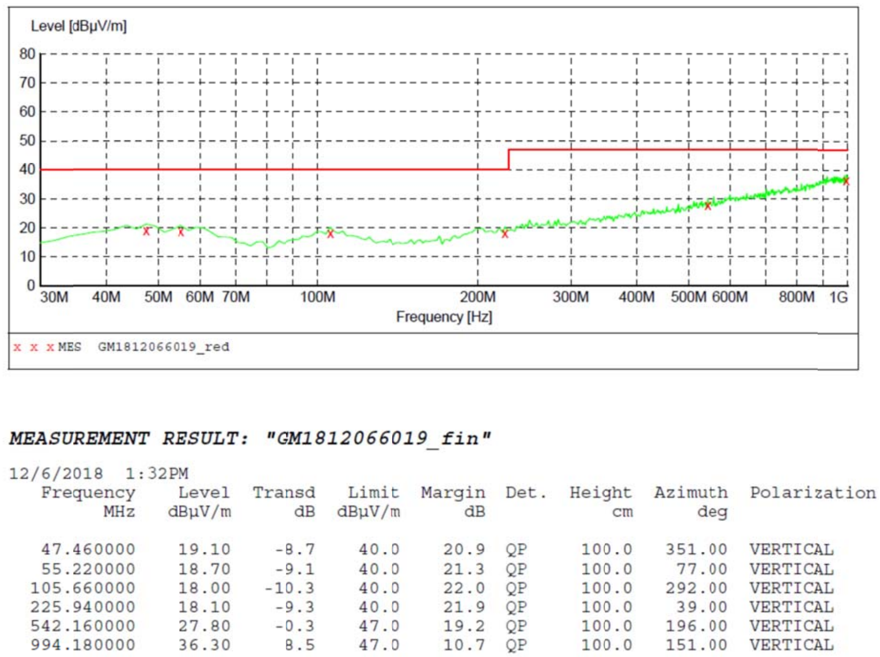
[picture p307: figure]

Report No.: TRE18090108 | Page 19 of 30 | Issued: 2018-12-11

### 4.2. Conducted disturbance

The test is not applicable to the EUT.

### 4.3. Harmonic current

The test is not applicable to the EUT.

### 4.4. Voltage Fluctuation and Flicker

The test is not applicable to the EUT.

Report No.: TRE18090108 | Page 20 of 30 | Issued: 2018-12-11

### 4.5. Electrostatic discharge

For test instruments and accessories used see section 3.6.

### 4.5.1. Description of the test location and date

Test location: Shielded room No. 4

Date of test: | 2018-12-07
Operator: | QUANHAOI DENG

### 4.5.2. Severity levels of electrostatic discharge

Level | Test Voltage Contact Discharge (kV) | Test Voltage Air Discharge (kV)
1 | 2 | 2
2 | 4 | 4
3 | 6 | 8
4 | 8 | 15
X | Special | Special
Note: equipment and systems shall comply with the requirements of 8.9 of IEC 60601-1-2: 2014 at immunity test levels of ± 2kV, ± 4kV, ±8kV and ±15kV for air discharge and ± 8kV for contact discharge.

### 4.5.3. Description of the test set-up

4.5.3.1. Operating Condition

The EUT is turned on and measuring during the test and the results of the maximum susceptive results are recorded.

4.5.3.2. Test Configuration and Procedure:

Air Discharge:
－This test is done on a non-conductive surfaces. The round discharge tip of the Electrostatic Discharge simulator shall be approached as fast as possible then to touch the EUT. After each discharge, the simulator shall be removed from the EUT. The simulator is then re-triggered for a new single discharge and repeated 10 times for each pre-selected test point. This procedure shall be repeated until all the air discharge completed.
Contact Discharge:
－All the procedure shall be same as air discharge, except using the acute discharge tip. The top end of the Electrostatic Discharge simulator is touch the EUT all the time when the simulator is re-triggered for a new single discharge and repeated 10 times for each pre-selected test point. Indirect Discharge:
－The vertical coupling plane(VCP) is placed 0.1m away from EUT. The top end of Electrostatic Discharge simulator should aim at the center of one border of the VCP for at least 10 times discharge.
－The top end of Electrostatic Discharge simulator should place at the point 0.1m away from EUT on the horizontal coupling plane(HCP). At least 10 times discharge should be done for every pre-selected point around EUT.
Record any performance degradation of the EUT during the test and judge the test result according to performance criterion.

Report

4.5.3.3.

### 4.5.4. Te

Contact d

Number o

Air discha

Number o

Type of d

Polarity:

Discharge

### 4.5.5. Te

No chang
function. C

No.: TRE18

Photo of the

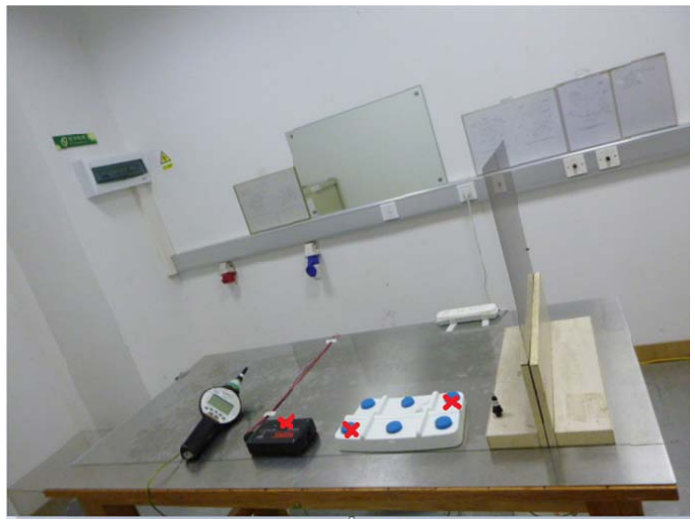
[picture p308: figure]

est specific

ischarge vol

of discharges

arge voltage:

of discharges

ischarge:

e location:

est result

e of the mod
Comply with

090108

e test set-up

ation:

tage:

:

:

de. The temp
IEC 60601-1

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
perature mea
1-2: 2014.

Page 2

■ 8 kV

■ 10

■ 2 kV

■ 10

Direct discha

Indirect disch
■ Positive

■ see photo

■ all extern

■ horizonta

■ vertical co

asurement is

### 1 of 30

□ 25

■ 4 kV

□ 25

arge

harge

o documenta

al locations a

l coupling pla

oupling plane

in of the acc

■ 8 k

■ Air disch
■ Contact
■ Contact
■ Negative

ation of the te

accessible by

ane (HCP)

e (VCP)

curacy range

Issued: 2

kV | ■

harge
discharge
discharge

est set-up

y hand

. No degrad

018-12-11

■ 15 kV

ation of

Report

### 4.6. Ra

For test in

### 4.6.1. D

Test locat

Date of te

Operator:

### 4.6.2. S

Note: equ
immunity

### 4.6.3. D

4.6.3.1.

The EU
results

4.6.3.2.

EUT an
mounte
sides of
polariza
In order
Record
perform
4.6.3.3.

No.: TRE18

### adiated, ra

nstruments a
Description o

tion: Shield

est: | 2018-
| BAOJI
everity leve
Level | Fiel d Strength ( (V/m)
1 | 1
2 | 3
3 | 10
X | Special
uipment and
test levels of
Description o
Operating C

UT is turned
are recorded

Test Proced

d its auxiliary
d on an ante
f EUT will fac
ation of the a
r to judge the
any perform
mance criterio
Photo of the

090108

### adio-freque

and accessor
of the test lo

ded room No

12-06

N LING
els of radiate

systems sha
f 10V/m.
of the test se
Condition

on and meas
d.

ure

y instrument
enna mast is
ce the transm
ntenna are s
e performanc
mance degrad
on.
e test set-up

### ency, elec

ries used see
ocation and
o. 7

ed, radio-fre

all comply wit

et-up

suring during

are placed o
set 3 meter
mitting anten
set on test an
ce of the EUT
dation of the

Page 22

### ctromagne

e section 3.6
date

equency, ele

th the require

g the test and

on a turntabl
away from th
na with the t
nd measured
T, a set of m
EUT during

### 2 of 30

### etic field

ectromagnet

ements of 8.

d the results

e above gro
he EUT. Dur
urntable cyc
d individually
monitor system
the test and

tic field

9 of IEC 606

of the maxim

und. Transm
ring the test,
led. Both hor
m is used.
judge the te

Issued: 2

601-1-2: 2014

mum suscep

mitting antenn
each of the
rizontal and

est result acc

018-12-11

4 at

ptive

na
four
vertical

cording to

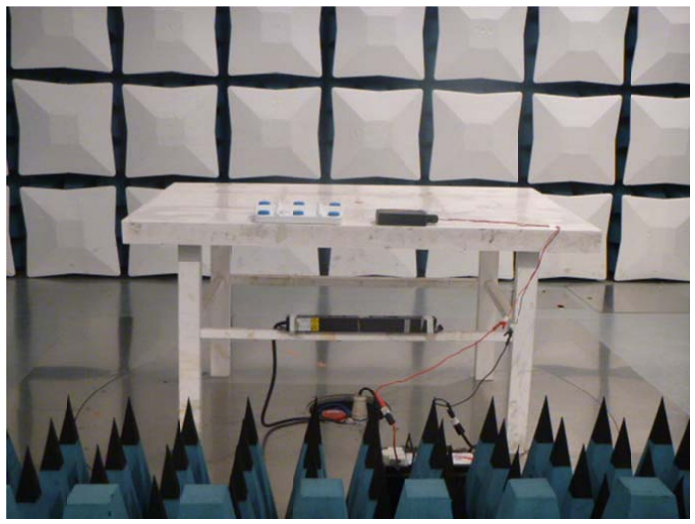
[picture p309: figure]

Report No.: TRE18090108 | Page 23 of 30 | Issued: 2018-12-11

### 4.6.4. Test specification:

Frequency range: | ■ 80 MHz to 2700 MHz
Field strength: | ■ 10 V/m
EUT - antenna separation: | ■ 3 m
Modulation: | ■ AM: 80 % ■ sinusoidal 1KHz
Frequency step: | ■ 1 % with 3s dwell time
Antenna polarisation: | ■ horizontal | ■ vertical

Test specifications for ENCLOSURE PORT IMMUNITY to RF wireless communications
equipment:
Test frequency (MHz) | Band (MHz) | Service | Modulation | Maximum power (W) | Distance (m) | IMMUNITY TEST LEVEL (V/m)
385 | 380 –390 | TETRA 400 | Pulse modulation 18 Hz | 1.8 | 0.3 | 27
450 | 430 – 470 | GMRS 460, FRS 460 | FM ± 5 kHz deviation 1 kHz sine | 2 | 0.3 | 28

710
704 – 787 LTE Band 13, 17

Pulse
modulation
217 Hz
745 | 0.2 | 0.3 | 9
780
810

800 – 960

GSM
800/900,
TETRA 800,
iDEN 820,
CDMA 850,
LTE Band 5

Pulse
modulation
18 Hz
| 2 | 0.3 | 28

870

930

1720

1 700 –
1 990

GSM 1800;
CDMA 1900;
GSM 1900;
DECT; LTE
Band 1, 3, 4,
25; UMTS

Pulse
modulation
217 Hz
2 | 0.3 | 28

1845

1970

2450 | 2 400 –
2 570

Bluetooth,
WLAN,
802.11 b/g/n,
RFID 2450,
LTE Band 7

Pulse
modulation
217 Hz
2 | 0.3 | 28
5240 | 5 100 –
5 800

WLAN
802.11 a/n

Pulse
modulation
217 Hz
5500 | 0.2 | 0.3 | 9
5785

### 4.6.5. Test result

No change of the mode. The temperature measurement is in of the accuracy range. No degradation of function. Comply with IEC 60601-1-2: 2014.

Report No.: TRE18090108 | Page 24 of 30 | Issued: 2018-12-11

### 4.7. Electrical fast transients / Burst

The test is not applicable to the EUT.

### 4.8. Surge

The test is not applicable to the EUT.

### 4.9. Conducted disturbances induced by radio-frequency fields

The test is not applicable to the EUT.

Report No.: TRE18090108 | Page 25 of 30 | Issued: 2018-12-11

### 4.10. Magnetic Field Immunity

For test instruments and accessories used see section 3.6.

### 4.10.1. Description of the test location and date

Test location: Shielded room No. 8

Date of test: | 2018-12-06
Operator: | QUANHAOI DENG

### 4.10.2. Severity levels of magnetic field immunity

Level | Magnetic Field Strength (A/m)
1 | 1
2 | 3
3 | 10
4 | 30
5 | 100
X | Special
Note: equipment and systems shall comply with the requirements of 8.9 of IEC 60601-1-2: 2014 at immunity test levels of 30A /m.

### 4.10.3. Description of the test set-up

4.10.3.1. Operating Condition

The EUT is turned on and measuring during the test and the results of the maximum susceptive results are recorded.

4.10.3.2. Test Configuration and Procedure:
EUT is placed on an insulating support of 0.1m high above a table of 0.8m high. There is a minimum 1m*1m ground metallic plane put on this table. EUT is put in the center of the magnetic coil then three orientations of the magnetic coil, X, Y and Z, shall be rotated in order to expose the EUT to the difference polarization magnetic field.
Record any performance degradation of the EUT during the test and judge the test result according to performance criterion.

Report

4.10.3.3.

### 4.10.4. Te

Test frequ

Continuou

Test dura

Antenna f

Axis:

### 4.10.5. Te

No chang
function. C

### 4.11. Vo

The test is

No.: TRE18

Photo of the

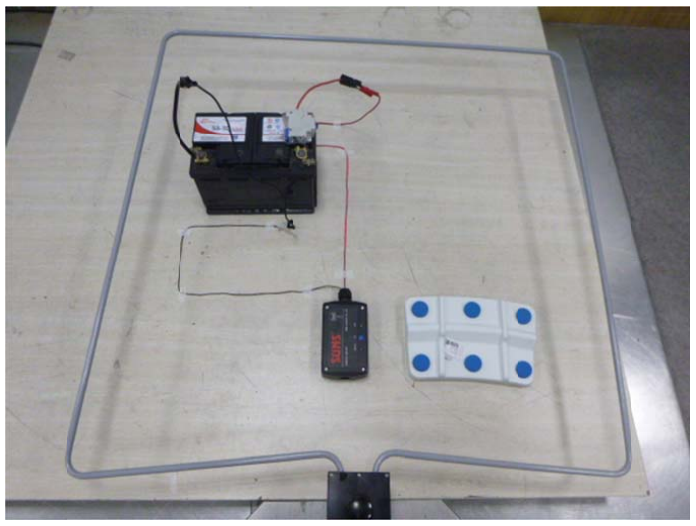
[picture p310: figure]

est specific

uency:

us field:

tion:

factor:

est result

e of the mod
Comply with

### oltage Dips

s not applica

090108

e test set-up

ation:

de. The temp
IEC 60601-1

### s and Inte

able to the EU

■

■

■

0

■

perature mea
1-2: 2014.

### rruptions

UT.

Page 2

■ 50 Hz

■ 30 A/m

■ 5 mins

0.917 A/m

■ x-axis

asurement is

### 6 of 30

■ 60

■

in of the acc

Hz

y-axis

curacy range

Issued: 2

■

. No degrad

018-12-11

z-axis

ation of

5 . E x

## 5.1. Ex

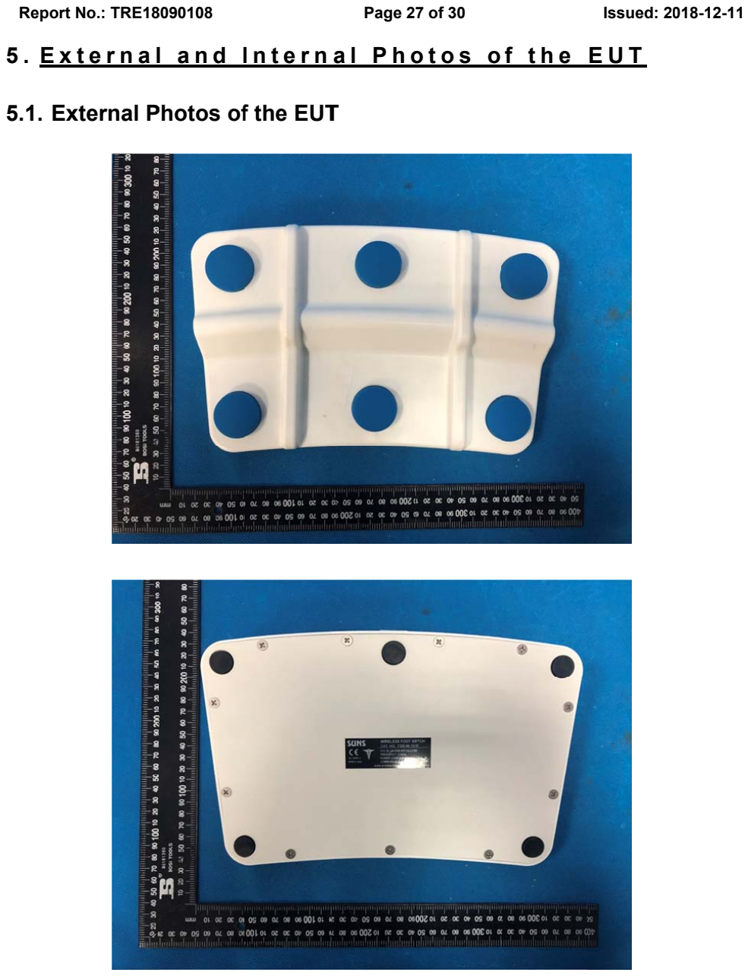
[picture p311: page 27]

Report

No.: TRE18

## terna l

## xternal P

090108

## l and I

## Photos of

## ntern

## the EUT

Page 2

## al Ph o

### 7 of 30

## o tos o

## f the

Issued: 2

## EUT

018-12-11

Report No.: TRE18090108 | Page 28 of 30 | Issued: 2018-12-11

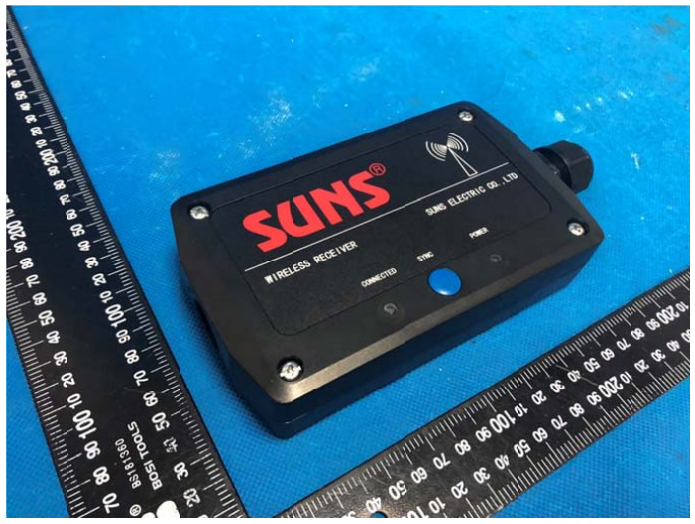
[picture p312: figure]

## 5.2. Int

## ernal ph

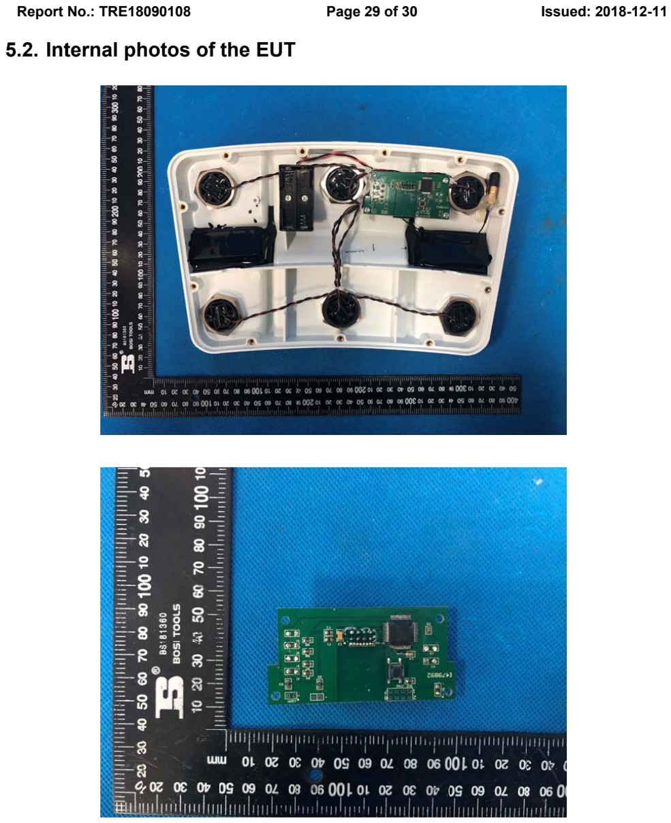
[picture p313: page 29]

Report

No.: TRE18

090108

## otos of

## the EUT

Page 29 of 30 | Issued: 2018-12-11

Report No.: TRE18

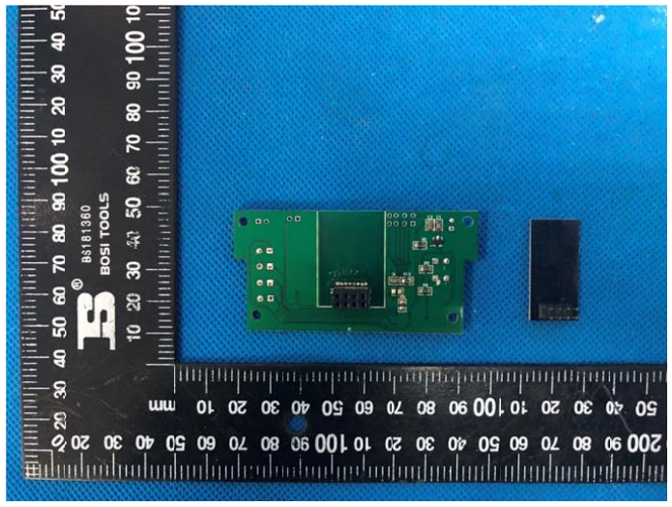
[picture p314: figure]

090108

| E

Page 3

## nd of Re

### 0 of 30

port.....

Issued: 2

018-12-11
