santan444/MS-002P/03-设计开发输出阶段/02电子/MS-002.21T001-台车控制板/07_PCB加工要求/MS-002.21W008 PCB加工工艺 V1.0.xls

 |  |  | 杭州三坛医疗科技有限公司
PCB加工工艺要求
PCB板信息：
PCB文件名 | MS-002.21T005 台车控制板Gerber文件.rar | 版本 | V1.0
拼板数量 | 1 | 尺寸 | 200.0mm x 100.0mm
工艺要求：
项目 |  | 要求
层数 |  | 2层
成品板厚 |  | 1.6mm
材 料 |  | FR-4 介电常数4.6
成品铜铂厚度 |  | 1oz
表面涂层 |  | 无铅喷锡
阻焊 |  | 绿色
字符丝印 |  | 白色
过孔处理 |  | 覆油
其它 |  | IC引脚焊盘间需要增加阻焊接桥
