santan444/MS-002P/03-设计开发输出阶段/02电子/05物料证书/9.主机/产品证书/双防雷证书+检测报告/HP Elite Mini 600 G9 Desktop PC双防雷证书.pdf

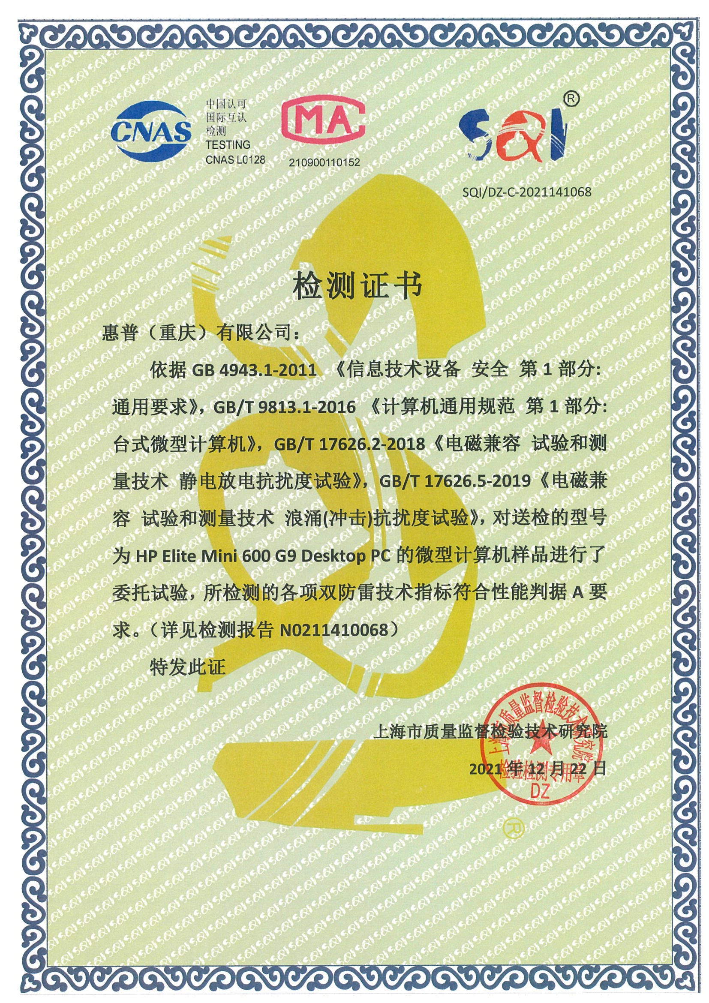
[picture p315: page 1]
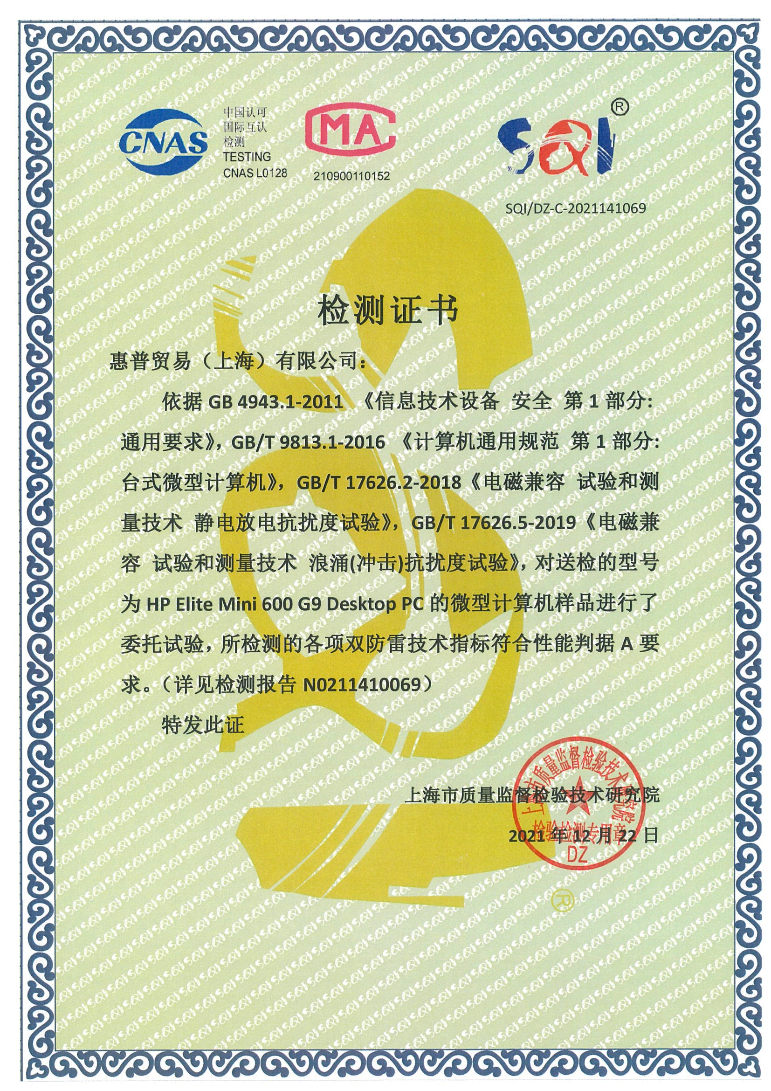
[picture p316: page 2]
