santan444/MS-002P/03-设计开发输出阶段/02电子/MS-002.21T001-台车控制板/03_物料清单/MS-002.21W004 台车控制板物料清单 V1.0.xlsx

三坛医疗 |  |  | 组件名称 | 台车控制板 |  | 电路板组件 物料明细表 | 编制/日期 |  | 审核/日期 | 批准/日期
产品型号 |  | MS-002 | 文件号 | MS-002.21W004 V1.0 |  |  | 2022.11.17
电路板组件
组件编码 |  | 610130026 | 台车控制板
物料明细
序号 | 物料类型 | 物料编码 | 名称/规格 | 厂家 | 封装 | 位号 | 数量 | 替代编码 | 替代名称/规格 | 替代厂家
1 | 贴片电容 | 610026001 | CC0603JRNPO9BN220 | 国巨 | C0603 | C21, C30 | 2 | 610027001 | GRM1885C1H220JA01D | 村田
2 | 贴片电容 | 610026008 | CC0603KRX7R9BB102 | 国巨 | C0603 | C36, C37, C38, C39 | 4 | 610027008 | GRM1885C1H102JA01D | 村田
3 | 贴片电容 | 610026014 | CC0603KRX7R9BB104 | 国巨 | C0603 | C1, C4, C7, C8, C9, C10, C11, C12, C13, C15, C17, C19, C20, C23 | 14 | 610027014 | GRM188R71H104KA93D | 村田
4 | 贴片电容 | 610026017 | CL10A105KA8NNNC | 三星 | C0603 | C24, C25, C26, C27, C28, C29 | 6 | 610027017 | GRM188R71E105KA12D | 村田
5 | 贴片钽电容 | 610027034 | TAJA106K016RNJ | Kyocera AVX | CASE-A_3216 | C3, C6, C14, C16, C18, C22 | 6
6 | 贴片电解电容 | 610026049 | VES101M1VTR-0607 | lelon(台湾立隆) | SMD-6.3*7.7mm | C2 | 1
7 | 贴片LED | 610040060 | 19-217/G7C-AN1P2/3T | EVERLIGHT(台湾亿光) | 0603 | D3, D4, D5 | 3
8 | TVS管 | 610120014 | SMBJ26CA | Brightking(君耀电子) | SMB(DO-214AA) | D1 | 1
9 | 贴片电感 | 610030020 | SWPA4030S100MT | Sunlord(深圳顺络) | SMD-4.0*4.0*4.0mm | L1, L2 | 2
10 | 贴片磁珠 | 610030009 | BLM18KG121TN1D | muRuata(村田) | R0603 | L4, L5, L6, L7 | 4
11 | 连接器 | 610060057 | PJ-3210-4A | 韩国韩荣 | AUDIO_TH_PJ-3210-4A | P11, P12, P13 | 3
12 | 插拔式接线端子 | 610060058 | HT396R-3.96-04P-15 | KEFA(科发电子) | 2EDG4P-3R96-TH-W-L | P4, P5 | 2
13 | 插拔式接线端子 | 610060059 | HT396R-3.96-02P-15 | KEFA(科发电子) | 2EDG2P-3R96-TH-W-L | P1, P6, P7, P8, P10 | 5
14 | 连接器 | 610060012 | U-USBAR04P-F002 | Ckmtw(灿科盟) | USB-A | P9, P14 | 2
15 | 贴片三极管 | 610040003 | S8050 | CJ（江苏长电） | SOT-23-3 | Q2, Q3, Q4, Q5 | 4
16 | 贴片MOS管 | 610040015 | CJ2301 | CJ（江苏长电） | SOT-23-3 | Q1 | 1
17 | 贴片电阻 | 610016070 | RC0603JR-071KL | 国巨 | R0603 | R13, R16, R17, R28, R31, R32, R33, R38, R39, R40, R41, R43 | 12 | 610017070 | 0603WAJ0102T5E | 厚声
18 | 贴片电阻 | 610016093 | RC0603JR-0710KL | 国巨 | R0603 | R5, R9, R11, R12, R14, R18, R19, R23, R25, R26, R42 | 11 | 610017093 | 0603WAJ0103T5E | 厚声
19 | 贴片电阻 | 610016116 | RC0603JR-07100KL | 国巨 | R0603 | R15 | 1 | 610017116 | 0603WAJ0104T5E | 厚声
20 | 贴片电阻 | 610016024 | RC0603JR-0710RL | 国巨 | R0603 | R10, R44 | 2 | 610017024 | 0603WAJ0100T5E | 厚声
21 | 贴片电阻 | 610016109 | RC0603JR-0751KL | 国巨 | R0603 | R1, R2, R3, R4 | 4 | 610017109 | 0603WAJ0513T5E | 厚声
22 | 贴片电阻 | 610016101 | RC0603JR-0724KL | 国巨 | R0603 | R29, R30 | 2 | 610017101 | 0603WAJ0243T5E | 厚声
23 | 贴片电阻 | 610016089 | RC0603JR-076K8L | 国巨 | R0603 | R6 | 1 | 610017089 | 0603WAJ0682T5E | 厚声
24 | 贴片电阻 | 610016077 | RC0603JR-072KL | 国巨 | R0603 | R20, R22 | 2 | 610017077 | 0603WAJ0202T5E | 厚声
25 | 可调电阻/电位器 | 610017155 | RK10J12R0A0B | ALPSALPINE(阿尔卑斯阿尔派) | RES-SMD_RK10J11R0A0H | R27 | 1
26 | MCU芯片 | 610050029 | STM32F103RCT6 | ST(意法半导体) | LQFP-64 | U4 | 1
27 | 电源芯片 | 610050066 | ME6211A33M3G-N | MICRONE(南京微盟) | SOT-23-3 | U3 | 1
28 | 集成电路 | 610050032 | TPS54202DDCR | TI(德州仪器) | SOT-23-6 | U1 | 1
29 | 集成电路 | 610050067 | LTK5206 | LTKCHIP(联辉科) | SOP-16 | U10 | 1
30 | 集成电路 | 610050065 | CH375B | WCH(南京沁恒) | SOIC-28 | U5 | 1
31 | 集成电路 | 610050035 | USBLC6-2SC6 | ST(意法半导体) | SOT-23-6 | U11 | 1
32 | 贴片光耦 | 610040065 | EL817 | EVERLIGHT(台湾亿光) | SMD-4 | U6, U7, U8, U9 | 4
33 | 贴片晶振 | 610100006 | X503212MSB2GI | YXC(扬兴科技) | SMD-5032_2P | Y1 | 1
34 | 贴片电阻 | 610016000 | RC0603JR-070RL | 国巨 | R0603 | R21, R24 | 2 | 610017000 | 0603WAJ0000T5E | 厚声
35
36 | PCB板 |  | MS-002.21T003.1.0 | 睿索科技
37
38
39
40
41
42 |  |  |  |  |  |  | 1
43
44
