santan444/MS-002P/03-设计开发输出阶段/02电子/MS-002.22T001-末端控制板/03_物料清单/MS-002.22W004 末端控制板物料清单 V1.0.xlsx

三坛医疗 |  |  | 组件名称 | 末端控制板 |  | 电路板组件 物料明细表 | 编制/日期 |  | 审核/日期 | 批准/日期
产品型号 |  | MS-002 | 文件号 | MS-002.22W004 V1.0
电路板组件
组件编码 |  | 610130027 | 末端控制板
物料明细
序号 | 物料类型 | 物料编码 | 名称/规格 | 厂家 | 封装 | 位号 | 数量 | 替代编码 | 替代名称/规格 | 替代厂家
1 | 贴片电容 | 610027035 | CC0805MKY5V9BB105 | YAGEO(国巨) | C0805 | C1 | 1
2 | 贴片电容 | 610027036 | CC0805KRX5R8BB225 | YAGEO(国巨) | C0805 | C2 | 1
3 | 贴片电容 | 610026035 | CC1206KKX5R9BB106 | YAGEO(国巨) | C1206 | C3 | 1
4 | 贴片电容 | 610026014 | CC0603KRX7R9BB104 | YAGEO(国巨) | C0603 | C4, C5, C6 | 3
5 | 接插件 | 610060061 | 2.0MM间距 H=4.3 1*4P | 清锋电子 | CONN-SMD_2243-104 | J3 | 1
6 | 接插件 | 610060062 | 1.25T-5P-WT | 韩国韩荣 | 1.25T-5P-WT | J2 | 1
7 | 贴片三极管 | 610040003 | S8050 | CJ（江苏长电） | SOT-23_3 | Q1, Q2, Q3, Q4, Q5, Q6, Q7 | 7
8 | 贴片电阻 | 610016054 | RC0603JR-07200RL | YAGEO(国巨) | R0603 | R9 | 1
9 | 贴片电阻 | 610016058 | RC0603JR-07330RL | YAGEO(国巨) | R0603 | R10 | 1
10 | 贴片电阻 | 610016063 | RC0603JR-07510RL | YAGEO(国巨) | R0603 | R11 | 1
11 | 贴片电阻 | 610016070 | RC0603JR-071KL | YAGEO(国巨) | R0603 | R13 | 1
12 | 贴片电阻 | 610016074 | RC0603JR-071K5L | YAGEO(国巨) | R0603 | R12 | 1
13 | 贴片电阻 | 610016077 | RC0603JR-072KL | YAGEO(国巨) | R0603 | R14, R15, R16, R17, R22, R23, R24 | 7
14 | 贴片电阻 | 610016093 | RC0603JR-0710KL | YAGEO(国巨) | R0603 | R1, R2, R3, R4, R18, R19, R20, R21 | 8
15 | 贴片电阻 | 610016116 | RC0603JR-07100KL | YAGEO(国巨) | R0603 | R5, R6, R7, R8 | 4
16 | 贴片电阻 | 610016145 | RC1206JR-070RL | YAGEO(国巨) | R1206 | R26 | 1
17 | 贴片电阻 | 610017156 | RC1206FR-07200RL | YAGEO(国巨) | R1206 | R25, R27 | 2
18 | 开关 | 610110013 | TC-1102N-C-D-B | XKB Connectivity(中国星坤) | TC-1102N-C-D-B | SW1, SW2, SW3, SW4 | 4
19 | MCU芯片 | 610050037 | STM8L101F3P6 | ST(意法半导体) | TSSOP-20 | U1 | 1
20 | 电源芯片 | 610050072 | TPS70933DBVR | TI(德州仪器) | SOT-23_5 | U2 | 1
21 | 二极管 | 610040067 | B5819W | CJ（江苏长电） | SOD-123 | D1, D2 | 2
22 | PCB板 |  | MS-002.22T003.1.0 | 睿索科技
