santan444/MS-002P/03-设计开发输出阶段/02电子/MS-002.23T001-升降控制板/03_物料清单/MS-002.23W004 升降控制板物料清单 V1.0.xlsx

三坛医疗 |  |  | 组件名称 | 升降控制板 |  | 电路板组件 物料明细表 | 编制/日期 |  | 审核/日期 | 批准/日期
产品型号 |  | MS-002 | 文件号 | MS-002.23W004 V1.0
电路板组件
组件编码 |  | 610130028 | 升降控制板
物料明细
序号 | 物料类型 | 物料编码 | 名称/规格 | 厂家 | 封装 | 位号 | 数量 | 替代编码 | 替代名称/规格 | 替代厂家
1 | 贴片电容 | 610026001 | CC0603JRNPO9BN220 | 国巨 | C0603 | C50, C51 | 2 | 610027001 | GRM1885C1H220JA01D | 村田
2 | 贴片电容 | 610027004 | GRM1885C1H101JA01D | 国巨 | C0603 | C27, C28, C37, C38 | 4
3 | 贴片电容 | 610026014 | CC0603KRX7R9BB104 | 国巨 | C0603 | C1, C2, C3, C4, C5, C6, C8, C9, C10, C11, C12, C13, C14, C18, C20, C21, C23, C24, C25, C26, C29, C30, C31, C32, C35, C36, C39, C40, C42, C45, C46, C48, C49, C56, C57, C63, C64 | 37 | 610027014 | GRM188R71H104KA93D | 村田
4 | 贴片电容 | 610026047 | CC1206KRX7R9BB104 | 国巨 | C1206 | C52, C53, C54, C55 | 4
5 | 贴片钽电容 | 610027034 | TAJA106K016RNJ | Kyocera AVX | CASE-A_3216 | C7, C17, C19, C41, C47 | 5 |  | TAJA106K016RNJ | AVX
6 | 贴片电解电容 | 610026049 | VES101M1VTR-0607 | lelon(台湾立隆) | SMD-6.3*7.7mm | C15, C16, C22, C33, C34 | 5
7 | 贴片LED | 610040060 | 19-217/G7C-AN1P2/3T | EVERLIGHT(台湾亿光) | 0603 | D2, D3 | 2
8 | 插拔式接线端子 | 610060058 | HT396R-3.96-04P-15 | KEFA(科发电子) | 2EDG4P-3R96-TH-W-L | P1, P6 | 2
9 | 插拔式接线端子 | 610060059 | HT396R-3.96-02P-15 | KEFA(科发电子) | 2EDG2P-3R96-TH-W-L | P2, P7, P8 | 3
10 | 插拔式接线端子 | 610060060 | HT396R-3.96-06P-15 | KEFA(科发电子) | 2EDG6P-3R96-TH-W-L | P3, P5, P9, P10 | 4
11 | 连接器 | 610060012 | U-USBAR04P-F002 | Ckmtw(灿科盟) | USB-A | P12 | 1
12 | 贴片电感 | 610030020 | SWPA4030S100MT | Sunlord(深圳顺络) | SMD-4.0*4.0*4.0mm | L1, L11 | 2
13 | 贴片电感 | 610030010 | SLF7055T-100M2R5-3PF | TDK | SMD-7*7*5.5mm | L2, L3, L4, L5, L6, L7, L8, L9 | 8
14 | 贴片三极管 | 610040003 | S8050 | CJ（江苏长电） | SOT-23-3 | Q1, Q4 | 2
15 | 贴片MOS管 | 610040064 | AOD413A | AOS | TO-252-2 | Q2 | 1
16 | 贴片电阻 | 610016070 | RC0603JR-071KL | 国巨 | R0603 | R3, R8, R15, R17, R18, R34 | 6 | 610017070 | 0603WAJ0102T5E | 厚声
17 | 贴片电阻 | 610016093 | RC0603JR-0710KL | 国巨 | R0603 | R1, R2, R4, R6, R9, R10, R11, R12, R13, R14, R19, R25, R31, R32, R33, R35, R41, R42, R52 | 19 | 610017093 | 0603WAJ0103T5E | 厚声
18 | 贴片电阻 | 610016116 | RC0603JR-07100KL | 国巨 | R0603 | R5, R16 | 2 | 610017116 | 0603WAJ0104T5E | 厚声
19 | 贴片电阻 | 610016024 | RC0603JR-0710RL | 国巨 | R0603 | R7, R40 | 2 | 610017024 | 0603WAJ0100T5E | 厚声
20 | 贴片电阻 | 610016109 | RC0603JR-0751KL | 国巨 | R0603 | R20, R21, R22, R28 | 4 | 610017109 | 0603WAJ0513T5E | 厚声
21 | 贴片电阻 | 610016089 | RC0603JR-076K8L | 国巨 | R0603 | R26 | 1 | 610017089 | 0603WAJ0682T5E | 厚声
22 | 贴片电阻 | 610016024 | RC0603JR-07100RL | 国巨 | R0603 | R29, R30, R38, R39 | 4 | 610017047 | 0603WAJ0101T5E | 厚声
23 | MCU芯片 | 610050029 | STM32F103RCT6 | ST(意法半导体) | LQFP-64 | U1 | 1
24 | 电机驱动 | 610050054 | RZ7899 | RZ 睿智微 | SOP-8 | U2, U3, U4, U5, U10, U11, U12, U13 | 8
25 | 电源芯片 | 610050066 | ME6211A33M3G-N | MICRONE(南京微盟) | SOT-23-3 | U6 | 1
26 | 集成电路 | 610050032 | TPS54202DDCR | TI(德州仪器) | SOT-23-6 | U7 | 1
27 | 集成电路 | 610050064 | NSI8121N1 | 纳芯微(NOVOSENSE) | SOIC-8 | U17 | 1
28 | 集成电路 | 610050034 | CH340G | WCH(南京沁恒) | SOP-16 | U18 | 1
29 | 集成电路 | 610050035 | USBLC6-2SC6 | ST(意法半导体) | SOT-23-6 | U19 | 1
30 | 集成电路 | 610050073 | RS0108YQ20 | RUNIC(润石) | TSSOP-20 | U21 | 1
31 | 贴片光耦 | 610040065 | EL817 | EVERLIGHT(台湾亿光) | SMD-4 | U22, U23 | 2
32 | 贴片晶振 | 610100006 | X503212MSB2GI | YXC(扬兴科技) | SMD-5032_2P | Y2 | 1
33 | 电流传感器 | 610050068 | CC6920BSO-10A | CrossChip(成都芯进) | SOP-8 | U8, U9, U14, U15 | 4
34 | 加速度传感器 | 610050069 | ADXL345BCCZ-RL7 | ADI(亚德诺)/LINEAR | LGA-14_L5.0-W3.0-P0.80-BL | U16 | 1
35 | TVS管 | 610120014 | SMBJ26CA | Brightking(君耀电子) | SMB(DO-214AA) | D1 | 1
36 | PCB板 | 617010041 | MS-002.23T003.1.0 | 睿索科技
37
38
39
40
41
42
