santan444/MS-002P/03-设计开发输出阶段/02电子/MS-002.24T001-末端灯板/03_物料清单/MS-002.24W004 末端灯板物料清单 V1.0.xlsx

三坛医疗 |  |  | 组件名称 | 末端灯板 |  | 电路板组件 物料明细表 | 编制/日期 |  | 审核/日期 | 批准/日期
产品型号 |  | MS-002 | 文件号 | MS-002.24W004 V1.0
电路板组件
组件编码 |  | 610130029 | 末端灯板
物料明细
序号 | 物料类型 | 物料编码 | 名称/规格 | 厂家 | 封装 | 位号 | 数量 | 替代编码 | 替代名称/规格 | 替代厂家
1 | 贴片LED | 610040086 | 19-237A/BHR6GHC-A01/2T | EVERLIGHT(亿光) | 0606 | D1, D2, D3, D4, D5, D6, D7, D8, D9, D10, D11, D12, D13, D14, D15 | 15
2 | 直插排针 | 610060063 | 2.0MM间距 L=8.5mm 1*4P | 清锋电子 | SIP4_2.0 | J1 | 1
3 | 贴片电阻 | 610016070 | RC0603JR-071KL | 国巨 | R0603 | R1, R2, R3, R4, R5, R6, R7, R8, R9, R10, R11, R12, R13, R14, R15, R16, R17, R18, R19, R20, R21, R22, R23, R24, R25, R26, R27, R28, R29, R30, R31, R32, R33, R34, R35, R36, R37, R38, R39, R40, R41, R42, R43, R44, R45 | 45 | 610017070 | 0603WAJ0102T5E | 厚声
4 | PCB板 | 617010042 | MS-002.24T003 | 睿索科技
5
6
7
8
9
10
11
12
13
14
15
16
17
18
19
20
21
22
23
24
25
26
27
28
29
30
31
32
33
34
35
36
