santan444/MS-002P/03-设计开发输出阶段/02电子/MS-002.25T001-末端连接板/03_物料清单/MS-002.25T004 末端连接板物料清单 V1.0.xlsx

三坛医疗 |  |  | 组件名称 | 末端连接板 |  | 电路板组件 物料明细表 | 编制/日期 |  | 审核/日期 | 批准/日期
产品型号 |  | MS-002 | 文件号 | MS-002.25W004 V1.0
电路板组件
组件编码 |  | 610130030 | 末端连接板
物料明细
序号 | 物料类型 | 物料编码 | 名称/规格 | 厂家 | 封装 | 位号 | 数量 | 替代编码 | 替代名称/规格 | 替代厂家
1 | 接插件 | 610060064 | EB-400-1233 | 深圳市仁昊伟业科技有限公司 | M8_8-coreRP | J1 | 1
2 | 接插件 | 610060062 | 1.25T-5P-WT | 韩国韩荣 | 1.25T-5P-WT | J2 | 1
3 | PCB板 | 617010043 | MS-002.25T003 | 睿索科技
4
5
6
7
8
9
10
11
12
13
14
15
16
17
18
19
20
21
22
23
24
25
26
27
28
29
30
31
32
33
34
35
36
