santan444/MS-002P/03-设计开发输出阶段/02电子/MS-002.27T001-导航台车LED灯环/03_物料清单/MS-002.27W004 导航台车LED灯环物料清单 V1.0.xlsx

三坛医疗 |  |  | 组件名称 | 导航台车LED灯环 |  | 电路板组件 物料明细表 | 编制/日期 |  | 审核/日期 | 批准/日期
产品型号 |  | MS-002 | 文件号 | MS-002.27W004 V1.0
电路板组件
组件编码 |  | 610130032 | 导航台车LED灯环
物料明细
序号 | 物料类型 | 物料编码 | 名称/规格 | 厂家 | 封装 | 位号 | 数量 | 替代编码 | 替代名称/规格 | 替代厂家
1 | 贴片电阻 | 610017154 | RC0805JR-07470RL | YAGEO(国巨) | R0805 | R1, R2, R3, R4, R5, R6, R7, R8, R9, R10, R11, R12, R13, R14, R15, R16 | 16
2 | 贴片LED （黄色） | 610040083 | HL-A-3528S31YC-S1-13HL | HONGLITRONIC(鸿利光电) | 3528 | D1, D2, D3, D4, D5, D6, D7, D8 | 8
3 | 贴片LED （蓝色） | 610040084 | HL-A-3528H203BC-S1-13HL | HONGLITRONIC(鸿利光电) | 3528 | D9, D10, D11, D12, D13, D14, D15, D16 | 8
4 | 连接器 | 610060039 | PHB-4AWB | LHE（浙江联合） | PHB-4AWB | P1 | 1
5 | PCB板 |  | MS-002.27T003.1.0 | 睿索科技 |  |  | 1
6
7
8
9
10
11
12
