santan444/MS-002P/03-设计开发输出阶段/02电子/MS-002.28T001-条形灯板/03_物料清单/MS-002.28W004 条形灯板物料清单 V1.0.xlsx

三坛医疗 |  |  | 组件名称 | 执行台车条形灯板 |  | 电路板组件 物料明细表 | 编制/日期 |  | 审核/日期 | 批准/日期
产品型号 |  | MS-002 | 文件号 | MS-002.28W004 V1.0
电路板组件
组件编码 |  | 610130033 | 执行台车条形灯板
物料明细
序号 | 物料类型 | 物料编码 | 名称/规格 | 厂家 | 封装 | 位号 | 数量 | 替代编码 | 替代名称/规格 | 替代厂家
1 | 贴片电阻 | 610017154 | RC0805JR-07470RL | YAGEO(国巨) | R0805 | R1, R2, R3, R4, R5, R6, R7, R8, R9, R10, R11, R12, R13, R14, R15, R16, R17, R18, R19, R20, R21, R22, R23, R24, R25, R26, R27, R28, R29, R30 | 30
2 | 贴片LED | 610040083 | HL-A-3528S31YC-S1-13HL | HONGLITRONIC(鸿利光电) | 3528 | D1, D2, D3, D4, D5, D6, D7, D8, D9, D10, D11, D12, D13, D14, D15 | 15
3 | 贴片LED | 610040084 | HL-A-3528H203BC-S1-13HL | HONGLITRONIC(鸿利光电) | 3528 | D16, D17, D18, D19, D20, D21, D22, D23, D24, D25, D26, D27, D28, D29, D30 | 15
4 | 连接器 | 610060039 | PHB-4AWB | LHE（浙江联合） | PHB-4AWB | P1，P2 | 2
5 | PCB板 |  | MS-002.28T003.1.0 | 睿索科技 |  |  | 1
6
7
8
9
10
11
12
