santan444/MS-002P/02-设计开发输入阶段/配置管理/MS-002配置管理计划及配置项列表（内部）.xls

Sheet: 封面
 |  | MS-002.10W014
MS-002
配置管理计划及配置项列表 |  |  | 内部实际使用
 | 编制/日期：
 | 审核/日期：
 | 批准/日期：
杭州三坛医疗科技有限公司

Sheet: 文档修订页
文档更改履历
日期 | 版本号 | 修订章节 | 描述 | 作者
2022-04-11 | V0.1 | 全文 | 根据模板制定本项目配置计划 | 吴辉
2022-05-09 |  | 3.配置库说明 | 公盘迁移，IP修改 | 吴辉
2022-06-20 |  | 封面页 | 右上角添加了文件号； | 吴辉
 |  | 4.基线计划 | 需求基线建立时间；
 |  | 5.配置项计划 | 识别了新的配置项。
2023-02-21 |  | 1.组织和职责 | 产品经理由严凌霄变更为方华磊 | 吴辉

Sheet: 1.组织和职责
组织和职责
角色 | 承担者 | 职责 | 工作频度
配置管理员 | 吴辉 | 1.根据项目特点制定项目配置管理计划； 2.配合项目经理识别项目生命周期过程各个阶段的配置项； 3.根据项目生命周期确定项目基线计划； 4.配置服务器日常管理； 5.创建配置基线,跟踪和管理变更过程； 6.向项目经理报告当前配置状态； 7.程序发布执行； 8.跟踪并解决相关的配置问题。 | 每阶段/事件触发
产品经理 | 方华磊 | 1.批准配置项的标志，以及软件基线的建立； 2.制定访问控制策略； 3.建立、更改基线的设置，审核变更申请； 4.根据配置管理员的报告决定相应的对策； 5.审核项目配置管理计划； 6.审核配置项的发布； 7.接受配置状态报告； 8.跟踪并解决相关的配置问题。 | 每阶段/事件触发 | 一二阶严凌霄，三阶方华磊
项目经理 | 洪洁 | 1.审批项目配置管理计划,发布配置计划； 2.审批配置项的发布； 3.接受配置状态报告； 4.解决配置管理问题； 5.批准产品版本发布。 | 每阶段/事件触发

Sheet: 2.配置项标识规定
配置项标识规定
技术文档
标识规定 | 项目名称(简称) + 文档类型名称
说明 | 项目名称：项目启动阶段，依据项目计划书定义
 | 技术类文档包括：技术需求说明书/设计文档/测试类文档
举例 | MS-002技术需求说明书
技术讨论记录
标识规定 | 项目名称(简称) +记录日期
说明 | 项目名称：项目启动阶段，依据项目计划书定义
 | 技术讨论记录:表示管理文档的类别为技术讨论记录
 | 讨论日期:为讨论的时间(格式为4位的年2位的月2为的日如20050718)
举例 | MS-002技术讨论记录_20050914
项目管理文档
项目计划
标识规定 | 项目名称(简称) + 项目计划+（版本号）
说明 | 文档类型名称：如概要设计说明书,详细设计说明书
 | 项目名称：项目启动阶段，依据项目计划书定义
 | 括号内版本号为可选项 如：进度计划选用（无法添加历史修改页）
举例 | MS-002开发计划书.doc，MS-002开发计划V1.0.mpp
会议纪要
标识规定 | 项目名称(简称) + 会议纪要 +开会日期
说明 | 项目名称：项目启动阶段，依据项目计划书定义
 | 文档类型名称：会议纪要
举例 | MS-002会议记要_20051010
软件发布标识
文档版本号命名规则(适用修改历史页版本命名)
标识规定 | VX.Y.
说明 | 内部版本号：
 | X – 与发布版本对应
 | Y – 与增量、修正对应
 | 说明: 文档初始版本号为0.1，发布初始版本为1.0 ，
 | 若这次版本与上一个版本相比，发布新的版本，则X为2；
 | 若这次版本与上一个版本相比，存在增量、修正，则Y增1；
 | 那么，这次内部版本号为2.1.
举例 | V1.1
代码版本命名规则
标识规定 | 版本号=vX.Y.Z.B
说明
举例 | v1.0.1.1

Sheet: 3.配置库说明
SVN配置库说明
文档工程-配置库目录结构 |  |  |  |  | 备注说明 | 责任人
root | 一级目录 | 二级目录 | 三级目录 | 文件举例 |  |  | 是否纳入基线(体系)
（项目编号，如MS-002） | 01-设计开发策划阶段 | / | / | / | 该目录存放一阶策划阶文档，不可更改。
 |  | / | / | 开发提议书 |  | 产品经理
 |  | / | / | 任命书 | (产品经理、项目经理、系统工程师) | 人力资源经理
 |  | / | / | 设计与开发策划计划 |  | 项目经理
 |  | / | / | 市场可行性分析报告 |  | 产品经理
 |  | / | / | 技术可行性分析报告 |  | 系统工程师
 |  | / | / | demo验证报告 |  | 系统工程师
 |  | / | / | 市场竞品情况 |  | 质量经理
 |  | / | / | 可注册性评估报告 |  | 注册经理
 |  | / | / | 学术调研分析报告 |  | 学术专员
 |  | / | / | 专利分析报告 |  | 知识产权专员
 |  | / | / | 用户需求规格说明书 |  | 产品经理
 |  | / | / | 立项报告 |  | 项目经理
 |  | 评审类 | / | DCP0评审报告 |  | 项目经理
 |  |  | / | DCP1评审报告 |  | 项目经理
 |  |  | / | TR1技术评审报告 |  | 项目经理
 |  |  | / | 第一阶段(DCP1+TR1)设计评审批准表.docx |  | DQA
 |  |  | / | 第一阶段(DCP1+TR1)开发文件.docx |  | DQA
 |  |  | / | （各种评审记录、会议记录等，如用户需求评审记录）
 | 02-设计开发输入阶段 | / | / | / | 该目录存放二阶输入阶段文档。不可更改
 |  | / | / | 产品系统设计方案 |  | 系统工程师
 |  | / | / | 产品技术需求规格书 | 1、含系统、软件、硬件、结构。 2、假如，研发过程中三、四阶需求文档都更新升版V1.1、V1.2，仍全都保存在二阶目录下。 2、假如五阶注册后发生需求变更，走正式变更流程(CRXXX质量部控制)，需求文档存在五阶目录下。 | 系统工程师
 |  | / | / | 包装、标签设计需求说明书 |  | 系统工程师
 |  | / | / | 初始关键物料采购建议 |  | 采购经理
 |  | / | / | 质量控制计划 |  | DQA
 |  | / | / | 产品开发试验和验证清单 | 类似总体测试计划 | DQA | 否
 |  | / | / | 产品设计开发计划书 |  | 项目经理
 |  | / | / | 里程碑事件进展表 |  | 项目经理
 |  | / | / | 《可追溯性跟踪表.xlsx》 |  | 项目经理
 |  | 风险管理 |  | 风险管理计划 |  | DQA
 |  |  |  | 风险评估和控制记录V1.0 |  | DQA
 |  |  |  | 风险管理报告V1.0 |  | DQA
 |  | 可用性工程 |  | 可用性需求评估 |  | 产品经理
 |  |  |  | 可用性任务分析 |  | 产品经理
 |  |  |  | 可用性分析报告V1.0 |  | 产品经理
 |  | 配置管理 |  | 《配置管理计划及配置项列表》V1.0 |  | 配置管理员
 |  |  |  | 配置审计报告（二阶） |  | 配置管理员
 |  |  |  | 配置项状态报告（二阶） |  | 配置管理员
 |  | 评审类 |  | DCP2评审报告 |  | DQA
 |  |  |  | TR2技术评审报告 |  | DQA
 |  |  |  | （各种评审记录、会议记录等，如技术需求评审记录） |  | DQA
 | 03-设计开发输出阶段 | / | / | / | 该目录存放三阶输出阶段文档。不可更改
 |  | / | / | 里程碑事件进展表V1.1 |  | 项目经理
 |  | / | / | 里程碑事件进展表V1.2 |  | 项目经理
 |  | / | / | 《可追溯性跟踪表V1.1.xlsx》
 |  | 01系统 | / | / | 该目录存放三阶输出阶段系统级文档。不可更改
 |  |  | / | 系统整机测试方案.doc |  | 系统工程师
 |  |  | / | 产品开发试验和验证清单（更新） | 类似总体测试计划 | DQA | 否
 |  |  | / | 产品开发试验和验证清单（更新） | 类似总体测试计划 | DQA | 否
 |  |  | / | 关键物料规格书 |  | 研发经理
 |  | 02电子 | / | / | 该目录存放三阶输出阶段电子专业组文档。不可更改
 |  |  | 01设计规范说明书 | 硬件概要设计说明书.doc |  | 电子/嵌软工程师
 |  |  |  | 嵌软概要设计说明书.doc |  | 电子/嵌软工程师
 |  |  |  | 硬件详细设计说明书 |  | 硬件工程师
 |  |  |  | 嵌软详细设计说明书 |  | 电子/嵌软工程师
 |  |  | 02接线图 | 接线图.vsd（可编辑源稿） | 统一约定“接线图”。其他名称均不符合，如“布线图” | 硬件工程师
 |  |  |  | 接线图.pdf |  | 硬件工程师
 |  |  | 03线缆图 | 线缆图.vsd（可编辑源稿） |  | 硬件工程师
 |  |  |  | 线缆图.dwg |  | 硬件工程师
 |  |  |  | 线缆图.pdf |  | 硬件工程师
 |  |  |  | 线缆统计表.xls |  | 硬件工程师
 |  |  |  | 电气绝缘图
 |  |  |  | 网电源电路图
 |  |  |  | 系统框图.vsd | 硬件框图（模块间布局及连接图）
 |  |  | 04电子测试验证 | / | 电子验证测试
 |  |  |  | 零部件测试验证方案（含设计样表） | 同一方案和报告 文件名称前部保持一致，放在同一目录下（不要再细分方案、报告子目录）。这样按文件名排序时 挨着一起便于直观的查看是否齐全 | 电子/嵌软工程师
 |  |  |  | 零部件测试验证方案_附件记录表样表
 |  |  |  | 零部件测试验证报告（含原始数据记录） |  | 电子/嵌软工程师
 |  |  |  | 零部件测试验证报告_附件记录表
 |  |  |  | 硬件测试方案(含设计样表) |  | 硬件工程师
 |  |  |  | 硬件测试报告（含原始数据记录） |  | 硬件工程师
 |  |  | 05物料证书 | 元器件证书、报告等 | 元器件证书、报告等。如3C证书、材料阻燃等级证书、IPX防浸液等级、UL认证证书,..等等。 | 研发经理
 |  |  | XX板/01_原理图 | XX板原理图 V1.0.pdf
 |  |  |  | XX板原理图检查表 V1.0.xls
 |  |  |  | 文件名.PrjPcb、.SchDoc、.PcbDoc | 原理图源文件
 |  |  | XX板/02_PCB | XX板PCB图.PcbDoc
 |  |  |  | XX板PCB图检查表.xls
 |  |  | XX板/03_物料清单 | XX板物料清单 V1.0.xlsx
 |  |  | XX板/04_Gerber文件 | XX板Gerber文件 V1.0.zip
 |  |  | XX板/05_坐标文件 | XX板坐标文件 V1.0.csv
 |  |  | XX板/06_装配图 | XX板装配图.ai（可编辑源文件）
 |  |  |  | XX板装配图.pdf
 |  |  |  | XX板装配图.docx
 |  |  | XX板/07_PCB加工要求 | PCB加工工艺.xls
 |  |  | XX板/08_目标代码 | XX板目标代码.s19
 |  |  | XX板/09_调试说明 | XX板调试说明 V1.0.doc
 |  |  | XX板/10_源代码 | 源代码（只要可编辑源码。中间编译过程文件都不要） | 只要可编辑源码。中间编译过程文件都不要。 更建议把源代码传Git，而非SVN
 |  |  |  | 嵌软代码评审记录
 |  |  |  | 嵌软单元测试方案
 |  |  |  | 嵌软单元测试用例
 |  |  |  | 嵌软单元测试报告
 |  | 03软件 | / | / | 该目录存放三阶输出阶段电子专业组文档。不可更改。 因软件的文档不多，建议不再扩展子目录。直接存放在二级目录下，一览无余。
 |  |  |  | 软件需求规格说明书.doc |  | 软件工程师 | 可裁剪
 |  |  |  | (软件开发计划)软件生存周期计划.doc |  | 软件工程师
 |  |  |  | 软件维护计划摘要
 |  |  |  | 网络安全维护计划
 |  |  |  | 软件概要设计说明书（含网络拓扑图） |  | 软件工程师
 |  |  |  | 网络拓扑图.vsd(可编辑源稿)
 |  |  |  | UI设计 |  | UI工程师
 |  |  |  | 软件详细设计说明书 |  | 软件工程师
 |  |  |  | 网络安全描述文档
 |  |  |  | 软件安全等级分析报告
 |  |  |  | 软件单元测试方案 | （各级测试方案、用例、记录、报告、记录） | 软件工程师
 |  |  |  | 软件单元测试用例 |  | 软件工程师
 |  |  |  | 软件单元测试记录 |  | 软件工程师
 |  |  |  | 软件单元测试报告 |  | 软件工程师
 |  |  |  | 软件代码评审记录 |  | 软件工程师
 |  |  |  | 软件集成测试方案 |  | 软件测试工程师
 |  |  |  | 软件集成测试用例 |  | 软件测试工程师
 |  |  |  | 软件集成测试记录 |  | 软件测试工程师
 |  |  |  | 软件集成测试报告 |  | 软件测试工程师
 |  |  |  | 软件系统测试方案 | 软件系统测试方案和用例放三阶。 记录和报告请放四阶 | 软件测试工程师
 |  |  |  | 软件系统测试用例 | 软件系统测试方案和用例放三阶。 记录和报告请放四阶 | 软件测试工程师
 |  |  |  | 软件编译说明书 |  | 软件工程师 | 否
 |  |  |  | 软件烧录说明书 |  | 软件工程师 | 否
 |  |  |  | 软件安装说明书 |  | 软件工程师 | 否
 |  | 04结构 | / | / | 该目录存放三阶输出阶段结构机械专业组文档。不可更改
 |  |  | 01设计规范说明书 | 结构概要设计说明书.doc |  | 结构工程师
 |  |  |  | 结构详细设计说明书.doc |  | 结构工程师
 |  |  | 02包装及标签 | 包装及标签方案.docx
 |  |  |  | 标签.ai(可编辑源文件) | 1.源稿文件名不要加版本号，源稿的版本与当前pdf一致。 2.请务必上传源稿（以往很多存在个人电脑上的，离职交接断档，再要修改时却找不到源文件了。 | 结构工程师
 |  |  |  | 标签（转曲）.ai | （转曲避免字体丢失） | 结构工程师
 |  |  |  | 标签.pdf |  | 结构工程师
 |  |  |  | 《标签标识粘贴说明.doc》
 |  |  |  | 《包装印刷说明书.doc》 |  | 结构工程师
 |  |  |  | 《装箱清单.doc》放哪合适？？ | word源稿前请加上统一封面(签字页)+修改履历
 |  |  |  | 运输包装设计图纸（.ai源文件可编辑、.eps印刷格式,.pdf格式） |  | 结构工程师
 |  |  | 03结构测试验证 | / | 结构测试/验证/确认，方案、报告等。 | 结构工程师
 |  |  |  | XX部件选型验证报告 | 部件的选型验证报告（含供应商评估） | 结构工程师
 |  |  |  | 仿真分析报告（如热分析、应力分析）（适用时） |  | 结构工程师
 |  |  |  | 结构零部件测试方案 | 同一方案和报告 文件名称前部保持一致，放在同一目录下（不要再细分方案、报告子目录）。这样按文件名排序时 挨着一起便于直观的查看是否齐全 | 结构工程师
 |  |  |  | 结构零部件测试报告
 |  |  |  | 结构零部件验证方案
 |  |  |  | 结构零部件验证报告
 |  |  |  | ...... |  | 结构工程师
 |  |  | 04结构图 | / |  | 结构工程师
 |  |  |  | 结构ID外观效果图（配色方案图）
 |  |  |  | 结构设计图（源稿/2D工程图/3D模型图） .pdf(2D工程图) .step(3D模型图) | 备注：因SolidWorks工程源文件(扩展名如.sldprt、.sldasm、SLDDRW等)过大，建议存放公盘 | 结构工程师
 |  |  |  | 合格证（.ai、.pdf） |  | 结构工程师
 |  |  |  | ...... |  | 结构工程师
 |  |  | 05工艺装备 | 工装检具需求说明书.doc |  | 结构工程师
 |  |  |  | 工装检具方案.doc |  | 结构工程师
 |  |  |  | 工装验证报告.doc |  | 结构工程师
 |  |  |  | 工艺装备清单 |  | 结构工程师
 |  |  |  | 工装设计图纸（.pdf(2D工程图)、.step(3D模型图)） |  | 结构工程师
 |  | 05样机制作与调试 | / | 原理样机验证报告 |  | 研发经理
 |  |  | / | 工程样机制作记录 |  | 研发经理
 |  |  | / | 工程样机调试记录 |  | 研发经理
 |  |  | / | 结构组装报告？？ |  | 结构工程师
 |  | 06BOM | / | 整机明细表.xls |  | 结构/电子工程师
 |  |  | / | XX组件物料明细表.xls |  | 结构/电子工程师
 |  |  | / | 辅料明细表.xls |  | 结构/电子工程师
 |  | 07风险管理 | / | 风险评估和控制记录V1.1(含网络安全)
 |  |  |  | 《生产过程失效模式分析(P-FMEA)》 |  | DQA | 否
 |  |  |  | 《设计失效模式分析(D-FMEA)_电子.xlsx》
 |  |  |  | 《设计失效模式分析(D-FMEA)_结构.xlsx》
 |  |  |  | 《故障树分析法(FTA)_软件.xlsx》
 |  |  |  | 风险管理报告V1.1(含网络安全，也可分开写) | 风险管理报告（更新）三阶。 网络安全的风险，可以合并在本文档里，也可独立成文，内容需包涵22项能力分析评估。 | DQA
 |  | 08配置管理 | / | 《配置管理计划及配置项列表》V1.1 |  | 配置管理员
 |  |  |  | 配置审计报告（三阶） |  | 配置管理员
 |  |  |  | 配置项状态报告（三阶） |  | 配置管理员
 |  | 09评审类 | / | TR3技术评审报告
 |  |  | / | TR4技术评审报告
 |  |  | / | （各种评审记录、会议记录等，如关键器件选型专项评审、设计评审、测试用例评审等）
 | 04-设计开发验证与确认阶段 | / | / | / | 该目录存放四阶验证阶段文档。不可更改
 |  | / | / | 产品开发试验和验证清单（更新） | 类似总体测试计划 | DQA | 否
 |  | / | / | 系统整机验证报告.doc | 该报告为汇总报告（含性能、功能、国标要求、行标要求、包装、运输） | 系统工程师
 |  | / | / | 里程碑事件进展表（四阶更新） |  | 项目经理
 |  | 01样机制作与调试 | / | 培训考核记录表(转产培训) | 工程样机生产、检验人员转产培训记录 | NPI
 |  |  | / | 试产样机生产记录 |  | 生产经理
 |  |  | / | 试产样机检验记录 |  | 生产经理
 |  |  | / | 工程样机试产报告 |  | 生产经理
 |  | 02软件测试 | / | 软件系统测试记录 |  | 测试工程师
 |  |  | / | 软件系统测试报告 |  | 测试工程师
 |  |  |  | 漏洞扫描方案（适用时）
 |  |  |  | 漏洞扫描报告（适用时）
 |  |  |  | 漏洞扫描整改报告（适用时）
 |  |  | / | 网络安全系统测试记录
 |  |  | / | 网络安全系统测试报告
 |  |  | / | 缺陷评估报告
 |  | 03转产指导 | 01转产清单 | 转产归档资料清单_电子.xlsx | 1、全量。 2、加上sheet页修改履历。 | 电子/嵌软工程师
 |  |  |  | 转产归档资料清单_结构.xlsx |  | 结构工程师
 |  |  |  | 转产归档资料清单_软件.xlsx |  | 软件工程师
 |  |  | 02SOP | 工艺流程图 | (含质量/工艺控制点） | 系统工程师
 |  |  |  | 关键工序验证方案 |  | 系统工程师
 |  |  |  | 关键工序验证报告 |  | 系统工程师
 |  |  |  | 生产作业指导书 | 例如显示器改装说明、接线注意事项、软件安装指导书，等，跟生产过程相关的，也是SOP的一部分。应转化到作业指导书里去的，合并到总的作业指导书里；目前是单独成文也可以。 | 系统工程师
 |  |  |  | 组装作业指导书 |  | 系统工程师
 |  |  |  | 系统调试作业指导书 |  | 系统工程师
 |  |  |  | 关键工序验证报告（若有)
 |  |  |  | 特殊过程验证报告（若有)
 |  |  | 03质检 | 原材料检验说明书
 |  |  |  | 成品检验说明书
 |  |  | 04工艺文档 | / | 工艺文档：委外的、用于指导第三方作业安装使用。（委外加工一般都不放在作业指导书）
 |  |  |  | 喷漆说明书
 |  |  |  | 丝印说明书
 |  |  |  | 激光雕刻说明书
 |  |  |  | ......
 |  |  | 05转产培训 | 培训考核记录表(转产培训) | 工程样机生产/检验人员转产培训记录
 |  | 04用户手册类 | / | 产品说明书.doc | word源稿前请加上统一封面(签字页)+修改履历 | 产品经理
 |  |  | / | 产品说明书印刷版源文件.ai | 1.源稿文件名不要加版本号，源稿的版本与当前pdf一致。 2.请务必上传源稿（以往很多存在个人电脑上的，离职交接断档，再要修改时却找不到源文件了。) | 产品经理、企宣/UI工程师
 |  |  | / | 产品说明书印刷版.pdf |  | 产品经理、企宣/UI工程师
 |  |  | / | 产品技术要求 |  | 系统工程师
 |  |  | / | 安装说明书.doc | word源稿前请加上统一封面(签字页)+修改履历 | 产品经理
 |  |  | / | 安装说明书印刷版源文件.ai | 1.源稿文件名不要加版本号，源稿的版本与当前pdf一致。 2.请务必上传源稿（以往很多存在个人电脑上的，离职交接断档，再要修改时却找不到源文件了。) | 产品经理、企宣/UI工程师
 |  |  | / | 安装说明书印刷版.pdf |  | 产品经理、企宣/UI工程师
 |  |  | / | 消毒灭菌指南.doc | word源稿前请加上统一封面(签字页)+修改履历 | 产品经理
 |  |  | / | 消毒灭菌指南印刷版源文件.ai | 1.源稿文件名不要加版本号，源稿的版本与当前pdf一致。 2.请务必上传源稿（以往很多存在个人电脑上的，离职交接断档，再要修改时却找不到源文件了。) | 产品经理、企宣/UI工程师
 |  |  | / | 消毒灭菌指南印刷版 |  | 产品经理、企宣/UI工程师
 |  |  | / | 用户安装调试指导书 |  | 产品经理
 |  |  | / | 用户培训指导书 |  | 产品经理
 |  |  | / | 客户服务指导书 |  | 产品经理
 |  |  | / | 用户安装调试说明 |  | 客户服务工程师
 |  |  | / | 用户培训方案 |  | 客户服务工程师
 |  |  |  | 生产文（生产工艺、配置清单、工艺装备/测试装备，测试仪器等更新完善） | 生产文（生产工艺、配置清单、工艺装备/测试装备，测试仪器等更新完善） | 生产经理
 |  |  |  | 型式检验报告
 |  |  |  | 《产品有效期验证方案》 | 使用期限验证方案 | 系统工程师
 |  |  |  | 《有源医疗器械使用期限分析评价报告.docx》 | 使用期限验证报告。该报告为汇总报告。 | 系统工程师
 |  |  |  | 机械试验方案 |  | 系统工程师
 |  |  |  | 机械试验报告 |  | 系统工程师
 |  |  |  | 环境试验方案 |  | 系统工程师
 |  |  |  | 环境试验报告 |  | 系统工程师
 |  |  |  | 性能测试报告（EMC、安规） |  | 系统工程师
 |  |  |  | 包装模拟运输测试报告 |  | 系统工程师
 |  |  |  | 消毒灭菌验证报告 |  | 系统工程师
 |  |  |  | 生物相容性报告 |  | 系统工程师
 |  |  |  | 用户测试方案 |  | 临床工程师
 |  |  |  | 用户测试报告 |  | 临床工程师
 |  |  |  | 临床试验方案 |  | 注册经理
 |  |  |  | 临床试验报告 |  | 注册经理
 |  |  |  | 体模试验方案 |  | 临床工程师
 |  |  |  | 体模试验报告 |  | 临床工程师
 |  |  |  | 动物试验方案 |  | 临床工程师
 |  |  |  | 动物试验报告 |  | 临床工程师
 |  |  |  | 尸体试验方案 |  | 临床工程师
 |  |  |  | 尸体试验报告 |  | 临床工程师
 |  | 采购管理 | / | / | 采购管理相关文档，最后定稿都存到四阶下。 | 采购经理
 |  |  | / | 采购申请单 |  | 采购经理
 |  |  | / | 采购记录/合同 |  | 采购经理
 |  |  | / | 物料采购计划 |  | 采购经理
 |  |  | / | 供应商评估记录 |  | 采购经理
 |  |  | / | 合格供应商名单 |  | 采购经理
 |  | 可追溯性 | / | / | 四阶可追溯性分析，完整内容，及总报告。
 |  |  | / | 《可追溯性跟踪表V1.2.xlsx》 |  | 项目经理
 |  |  | / | 《可追溯分析报告V1.1.doc》 |  | 项目经理
 |  |  | / | 《网络安全可追溯性分析报告.xlsx》 |  | 项目经理
 |  | 风险管理 | / | / | 该目录存放四阶验证阶段风险管理文档。不可更改
 |  |  | / | 风险管理计划（更新） |  | DQA
 |  |  | / | 风险评估和控制记录（含网络安全） |  | DQA
 |  |  | / | 风险管理报告（更新）（含网络安全） | 风险管理报告（更新）四阶。 网络安全的风险，可以合并在本文档里，也可独立成文，内容需包涵22项能力分析评估。 | DQA
 |  | 可用性工程 | / | / | 该目录存放四阶验证阶段可用性文档。不可更改
 |  |  | / | 可用性验证方案 |  | 临床工程师
 |  |  | / | 可用性验证记录 |  | 临床工程师
 |  |  | / | 可用性验证报告 |  | 临床工程师
 |  |  | / | 可用性确认方案 |  | 临床工程师
 |  |  | / | 可用性确认记录 |  | 临床工程师
 |  |  | / | 可用性确认报告 |  | 临床工程师
 |  |  | / | 可用性分析报告V1.1 |  | 临床工程师
 |  | 配置管理 | / | / | 该目录存放四阶验证阶段-配置管理文档。不可更改
 |  |  | / | 配置管理计划 |  | 配置管理员
 |  |  | / | 配置审计报告（四阶） |  | 配置管理员
 |  |  | / | 配置项状态报告（四阶） |  | 配置管理员
 |  |  | 软件版本管理 | 软件打包记录表.xlsx |  | 配置管理员
 |  |  |  | 版本更新历史（Update.log） |  | 配置管理员
 |  |  |  | MS-001软件发布报告.xls |  | 配置管理员
 |  |  | 变更管理 | CRXXX变更申请单，等 | （转产前的不走CR变更流程。五阶及以后才走CR变更流程。） | 配置管理员 | 否
 |  |  | 现成软件管理 | 现成软件评估表 |  | 配置管理员
 |  |  |  | 现成软件验证报告 | （含研发、生产、检验） | 配置管理员
 |  |  |  | 现成软件列表 |  | 配置管理员
 |  | 研发设备、工具、测试环境管理 | / | /
 |  |  |  | （开发/测试）设备信息表
 |  |  |  | （开发/测试）环境维护记录
 |  |  |  | 工具清单
 |  | 评审类 | / | TR5技术评审报告 |  | DQA
 |  |  | / | TR6技术评审报告 |  | DQA
 |  |  | / | DCP3评审报告 |  | DQA
 |  |  |  | 设计评审批准表 |  | DQA
 |  |  |  | （各种评审记录、会议记录等，如版本发布评审）
 |  |  | / |  | DCP3结束后，配置库管理员将一至四阶目录权限封闭，冻结。后续所有修改走变更流程，存放在五阶
 | 05-设计开发注册阶段 | / | / | / | 该目录存放五阶注册阶段文档。不可更改
 |  | XX送检资料清单 例如，型检送检资料清单 |  |  | 按照送检要求的各种检查单、承诺书、自查表，等，+开发文件索引。 仅为索引！不直接存放文件。（文件来源于设计开发一到四阶中的资料）
 |  |  | / | GB 9706.1-2020风险管理文档检查表.docx
 |  |  | / | GB 9706.1-2020安全测试材料清单.docx
 |  |  | / | YY 9706.102-2021电磁兼容送检要求.docx
 |  |  | / | 三坛检测样品清单.xlsx
 |  |  | / | 关于保证符合电气安全检测和电磁兼容检测样品一致性的承诺.docx
 |  |  | / | MS-002型检送检资料索引.xlsx | 仅为索引list，不直接存放文件。（文件来源于设计开发一到四阶中的资料）
 |  | 风险管理 | / | / | 该目录存放五阶注册阶段风险管理文档。不可更改
 |  |  |  |  |  | DQA
 |  | 配置管理 | / | / | 该目录存放五阶注册阶段 配置管理文档。不可更改
 |  |  | / | 配置审计报告 |  | 配置管理员
 |  |  | / | 配置项状态报告 | 记录每一次CR变更的配置项状态，包括过程资料和目标文件；含变更统计。 | 配置管理员
 |  |  | 软件版本管理 | 软件打包记录表.xlsx |  | 配置管理员
 |  |  |  | 版本更新历史（Update.log） |  | 配置管理员
 |  | 变更管理 | CRXXXX | / | 该目录存放五阶注册阶段的变更资料。 每次变更建立一个三级目录，以变更申请号“CRXXX”命名 | 配置管理员、DQA
 |  |  | CRXXXX/变更记录单/ | CRXXXX变更申请单
 |  |  |  | CRXXXX更改需求单
 |  |  |  | CRXXXX变更方案
 |  |  |  | CRXXXX设计变更风险评估表.xlsx
 |  |  |  | CRXXXX设计失效模式分析(D-FMEA).xlsx | 针对本次CR变更 合并成一份总表。（不要区分专业组分成几份文档）
 |  |  |  | CRXXXX风险评估和控制记录.xlsx
 |  |  |  | CRXXXX变更实施记录表.xlsx
 |  |  |  | CRXXXX变更通知单
 |  |  | CRXXXX/变更文件/ | 设计开发过程资料，如产品技术需求规格书V1.x、XX测试报告、XX验证报告等 | 设计开发过程资料，源文件、测试验证报告等。
 |  |  |  | 转产文件及可编辑源稿，如XX标签.pdf、XX标签.ai、等 | 增、改的转产文件、图纸及源稿。
 |  |  |  | CRXXXX转产归档资料清单_电子.xlsx | 1、保持全量，本次变更增量部分（增、改的部分）着重标出。 2、加上sheet页修改履历。
 |  |  |  | CRXXXX转产归档资料清单_结构.xlsx
 |  |  |  | CRXXXX转产归档资料清单_软件.xlsx
 | 06-上市及上市后 | / | / | / | 该目录存放六阶上市及上市后阶段文档。不可更改
注: 1.一级二级目录均不可更改，三级及以上目录可再进行扩展（建议目录不要过深，不要超过四级目录）； 2.文档工程中不允许存放开发工具软件包等，请将开发工具软件包存放在“研发中心/09-工作软件”目录下。避免工具包占用配置库主机空间，备份时间周期过长；软件可执行文件不允许上传svn，请传到公盘。 3.同一个产品下，一份相同的文件只存在于一个位置。
工作环境及使用工具说明
类别 | 工具/环境/配置要求 |  | 地址 |  |  | 维护负责人
需求管理 | Excel/Word |  | /
缺陷跟踪 | 禅道 |  | http://192.168.2.250/pro |  |  | 吴辉
配置管理 | SVN |  | http://192.168.2.252:18080/svn/MS-002 |  |  | 吴辉
编码工具 | Microsoft Visual Studio |  | / |  |  | /
发布站点 | 公司公盘共享目录 |  | \\192.168.2.200\研发体系归档 |  |  | 吴辉、蒋雨枫
版本控制 | 文档工程：SVN |  | http://192.168.2.252:18080/svn/MS-002 |  |  | 吴辉
 | 代码工程：Gitlab |  | http://192.168.2.252:7080/MS-002/orthopedics_plan_and_control_system |  |  | jun
代码工程-配置库操作权限分配举例说明
Master分支 | Master | 用途 | 主分支,产品的功能全部实现后 , 最终在master分支对外发布。
 |  | 数据来源 | 初始创建；从其他分支(develop)合并。
 |  | 权限 | 该分支为开发负责人可以读写，其他开发人员只读； 另外所有在master分支的推送应该打标签做记录,方便追溯。
Develop分支 | Develop | 用途 | 开发分支,该分支为所有开发人员日常提交的分支。 按项目进展阶段性,进行提测。
 |  | 数据来源 | 基于master分支克隆
 |  | 权限 | 该分支为所有开发人员可读写。测试人员只读。
配置库操作权限分组举例说明
大域 | 仓库名称 | 权限分组名称 | 权限分组说明
文档域（SVN） | MS-002 | g_ms002 | 项目组成员。 权限：项目组成员可读写
代码域（Gitlab） | MS-002/orthopedics_plan_and_control_system | Guest | Gitlab用户在组中有五种权限：Guest、Reporter、Developer、Master、Owner Guest：可以创建issue、发表评论，不能读写版本库
 |  | Reporter | Reporter：可以克隆代码，不能提交，QA、PM可以赋予这个权限
 |  | Developer | Developer：可以克隆代码、开发、提交、push，RD可以赋予这个权限
 |  | Master | Master：可以创建项目、添加tag、保护分支、添加项目成员、编辑项目，核心RD负责人可以赋予这个权限
 |  | Owner | Owner：可以设置项目访问权限 - Visibility Level、删除项目、迁移项目、管理组成员，开发组leader可以赋予这个权限。
 |  |  | Gitlab中的组和项目有三种访问权限：Private、Internal、Public Private：只有组成员才能看到 Internal：只要登录的用户就能看到 Public：所有人都能看到
发布站点（公盘）服务器信息
地址 | \\192.168.2.200\研发体系归档
用户名 | lixiaokang |  | wuhui
用途 | 只能下载 | 只能下载和上传 | 能上传，下载，建目录，删除，改名

Sheet: 4.基线计划
基线计划
基线标识 | 基线名称 | 计划创建日期
MS-002_需求基线_V1.0 | 需求基线 | 2022-04-15 | 实际2022-6-20
MS-002_设计基线_V1.0 | 设计基线 | 2022-08-15 | 详设完成
MS-002_设计基线_V1.1 | 设计基线 | 2022-11-？？
 | 集成测试基线 |  | 集成测试完成
 | 系统测试基线 |  | 系统测试完成
 | 测试基线 | 2023-01-？？ | 系统测试完成
MS-002_发布基线_V1.0 | 发布基线 | 2023-01-15 | 转产

Sheet: 5.配置项计划
配置项计划
1.文档类配置项 |  |  |  |  |  | 按阶段进行配置
1.1技术类文档
# | 配置项名称 | 责任人 | 是否纳入基线 | 进入基线条件 | 计划入库日期 | 所属基线
1 | 开发提议书 | 产品经理 | 是 | 评审通过 | 2022-04-15 | 需求基线 | 一阶
2 | 任命书 | 产品经理 | 是 | 评审通过 | 2022-04-15 | 需求基线
3 | 设计与开发策划计划 | 项目经理 | 是 | 评审通过 | 2022-04-15 | 需求基线
4 | 市场可行性分析 | 产品经理 | 是 | 评审通过 | 2022-04-15 | 需求基线
5 | 技术可行性分析 | 系统工程师 | 是 | 评审通过 | 2022-04-15 | 需求基线
6 | 市场竞品情况 | 质量经理 | 是 | 评审通过 | 2022-04-15 | 需求基线
7 | 可注册性评估 | 注册经理 | 是 | 评审通过 | 2022-04-15 | 需求基线
8 | 学术调研分析 | 学术专员 | 是 | 评审通过 | 2022-04-15 | 需求基线
9 | 专利分析 | 知识产权专员 | 是 | 评审通过 | 2022-04-15 | 需求基线
10 | 用户需求规格说明书 | 产品经理 | 是 | 评审通过 | 2022-04-15 | 需求基线
11 | 立项报告 | 项目经理 | 是 | 评审通过 | 2022-04-15 | 需求基线
12 | 产品系统设计方案 | 系统工程师 | 是 | 评审通过 | 2022-04-15 | 需求基线 | 二阶
13 | 可用性需求评估 | 产品经理 | 是 | 评审通过 | 2022-04-15 | 需求基线
14 | 可用性任务分析 | 产品经理 | 是 | 评审通过 | 2022-04-15 | 需求基线
15 | 可用性分析报告 | 产品经理 | 是 | 评审通过 | 2022-04-15 | 需求基线
16 | 风险评估和控制记录 | DQA | 是 | 评审通过 | 2022-04-15 | 需求基线
17 | 风险管理报告 | DQA | 是 | 评审通过 | 2022-04-15 | 需求基线
18 | 产品开发试验和验证清单 | DQA | 是 | 评审通过 | 2022-04-15 | 需求基线
19 | 产品技术需求规格书（软件、硬件、结构） | 系统工程师 | 是 | 评审通过 | 2022-04-15 | 需求基线
20 | 初始关键物料采购建议 | 采购经理 | 是 | 评审通过 | 2022-04-15 | 需求基线
21 | 配置审计报告 | 配置管理员 | 是 | 评审通过 | 2022-04-15 | 需求基线
22 | 配置项状态报告 | 配置管理员 | 是 | 评审通过 | 2022-04-15 | 需求基线
 | 结构概要设计说明书 | 结构工程师 | 是 | 评审通过 | 2022-08-15 | 设计基线 |  | 概设
 | 软件概要设计说明书 | 软件工程师 | 是 | 评审通过 | 2022-08-15 | 设计基线
 | 嵌入式软件概要设计说明书 | 电子工程师 | 是 | 评审通过 | 2022-08-15 | 设计基线 | 三阶
 | 嵌入式硬件概要设计说明书 | 电子工程师 | 是 | 评审通过 | 2022-08-15 | 设计基线 | 三阶
 | 软件安全等级分析、及报告 | 软件工程师 | 是 | 评审通过 | 2022-08-15 | 设计基线 | 三阶
 | 结构详细设计说明书 |  |  |  |  |  |  | 详设
 | 软件详细设计说明书
 | 嵌入式软件详细设计说明书
 | 嵌入式硬件详细设计说明书
 | DFMEA设计失效模式分析
 | FTA软件故障树分析
 |  |  |  |  |  |  |  | 测试
包括:需求规格书/设计文档/测试文档/数据库脚本等,当然每个阶段这些的变量部分作为新配置项识别
1.2管理类文档
# | 配置项名称 | 责任人 | 是否纳入基线 | 进入基线条件 | 计划入库日期 | 所属基线
1 | 项目立项报告 | 项目经理 | 是 | 评审通过 | 2022-04-15 | 需求基线
2 | 设计开发计划 | 项目经理 | 是 | 评审通过 | 2022-04-15 | 需求基线
3 | 风险管理计划 | DQA | 是 | 评审通过 | 2022-04-15 | 需求基线
4 | 配置管理计划 | 配置管理员 | 是 | 评审通过 | 2022-04-15 | 需求基线
5 | 可追溯性分析 | 项目经理 | 是 | 评审通过 | 2022-04-15 | 需求基线
6 | 会议记录 | / | 是 | 项目经理确认 | / | 各阶段基线
7 | 技术评审报告 | DQA | 是 | 评审通过 | / | 各阶段基线
8 | 阶段评审报告 | DQA | 是 | 评审通过 | / | 各阶段基线
9 | 里程碑事件进展表 | 项目经理 | 是 | 评审通过 | / | 各阶段基线
10 | 更改申请单 | / | 是 | 评审通过 | / | 各阶段基线
11 | 更改通知单 | QA | 是 | 评审通过 | / | 各阶段基线
包括:项目计划,配置计划,会议纪要等
1.3第三方相关
# | 配置项名称 | 责任人 | 是否纳入基线 | 进入基线条件 | 计划入库日期 | 所属基线
1 | 第三方软件验证报告 | / | 是 | 项目经理确认 | 2022-04-15 | 需求基线
2 | 现成软件列表 | wuhui | 是 | 项目经理确认 | 2022-04-15 | 需求基线
3
4
包括:和相关小组交互的第三方文档、工具、平台、插件等等,这些输入或者输出直接对项目产生一定的影响,相关小组包括:本公司其他项目或者部门,用户,第三方厂家
1.4工程类文档
# | 配置项名称 | 责任人 | 是否纳入基线 | 进入基线条件 | 计划入库日期 | 所属基线
1
2
3
4
5
包括:项目的割接方案/上线计划/安装调试报告/上线报告等等工程文档
2代码类配置项
# | 配置项名称 | 责任人 | 是否纳入基线 | 进入基线条件 | 计划入库日期 | 所属基线
1 | 软件源代码 | jun | 是 | 测试通过 | / | 发布基线
2 | 电子源代码 | 雷俊勇
包括:产品的源代码/编译环境/ 要求:颗粒度保持在模块级别,不需要列出具体的配置项名称，只需要说明此子目录下存放的哪类配置项，如“子服务前台”
公共部分说明： 1.识别阶段和生命周期的各个阶段保持一致，如果在设计阶段识别的配置项，那么这个识别阶段就是设计阶段 2.进入基线条件：其实任何一个配置项纳入配置库必须经过评审/验证/或者确认才能纳入基线库，例如需求规格书必须经过评审，工程类文档只要项目经理确认，对于代码类配置项必须经常测试进行验证

Sheet: 6.配置变更流程
基本变更流程
按照《ST-QSP-39 更改控制程序》执行

Sheet: 7.源码管理流程
源码管理流程
 | 注：以下流程供项目组参考，配置管理与项目组定义源码管理流程
 | 主要工作流程 1 . 初始化项目为gitflow , 默认创建master分支 , 然后从master拉取第一个develop分支 2 . 从develop拉取feature分支进行编码开发(多个开发人员拉取多个feature同时进行并行开发 , 互不影响) 3 . feature分支完成后 , 合并到develop(不推送 , feature功能完成还未提测 , 推送后会影响其他功能分支的开发) 合并feature到develop , 可以选择删除当前feature , 也可以不删除 . 但当前feature就不可更改了 , 必须从release分支继续编码修改 4 . 从develop拉取release分支进行提测 , 提测过程中在release分支上修改BUG 5 . release分支上线后 , 合并release分支到develop/master并推送 合并之后 , 可选删除当前release分支 , 若不删除 , 则当前release不可修改 . 线上有问题也必须从master拉取hotfix分支进行修改 6 . 上线之后若发现线上BUG , 从master拉取hotfix进行BUG修改 7 . hotfix通过测试上线后 , 合并hotfix分支到develop/master并推送 合并之后 , 可选删除当前hostfix , 若不删除 , 则当前hotfix不可修改 , 若补丁未修复 , 需要从master拉取新的hotfix继续修改 8 . 当进行一个feature时 , 若develop分支有变动 , 如其他开发人员完成功能并上线 , 则需要将完成的功能合并到自己分支上 即合并develop到当前feature分支 9 . 当进行一个release分支时 , 若develop分支有变动 , 如其他开发人员完成功能并上线 , 则需要将完成的功能合并到自己分支上 即合并develop到当前release分支 (!!! 因为当前release分支通过测试后会发布到线上 , 如果不合并最新的develop分支 , 就会发生丢代码的情况)

Sheet: 8.日常工作计划
日常工作计划
配置审计计划
审计频率 | 1次/月 | 如果按1次/阶段 时间跨度太久 尤其三四阶，起不到及时报告项目状态的作用。改成每月，或每双周。
审计人 | 配置管理员
审计内容 | 1、项目组成员配置活动的规范性检查（检入、检出等） 2、配置项变更过程及记录 3、基线完整性及变更过程和记录
配置状态报告发布计划
发布频率 | 1次/月 | 如果按1次/阶段 时间跨度太久 尤其三四阶，起不到及时报告项目状态的作用。改成每月，或每双周。
发布人 | 配置管理员
发布对象 | 项目管理人员（PM，各小组组长）
发布方式 | 邮件
配置库维护计划
维护频率 | 巡检： 1次/月 备份：文档配置库每天自动备份，代码配置库每3天自动备份 | 如果按1次/阶段 时间跨度太久 尤其三四阶，起不到及时报告项目状态的作用。改成每月，或每双周。
维护人 | 信息管理员；配置管理员
维护内容 | 1、配置库巡检，确保配置库正常 2、配置库备份
注：表中蓝字部分为范例，项目组使用时依据实际情况填写。

Sheet: 9.配置库人员权限
配置库人员权限
文档工程（SVN）
姓名 | svn账号 | 邮箱地址 | 部门 | 角色职责 | 权限组
洪洁 | hongjie | jie-hong@santan-md.com | 产品中心-项目管理部 | 项目经理 | g_ms002
严凌霄 | yanlingxiao | lingxiao-yan@santan-md.com | 产品中心-产品部 | 产品经理 | g_ms002
徐琦 | xuqi | qi-xu@santan-md.com | 研发中心-综合部 | 系统工程师 | g_ms002
方华磊 | fanghualei | hualei-fang@santan-md.com | 市场管理中心-客户服务部-产品临床组 | 临床经理 | g_ms002
李明 | liming | ming-li@santan-md.com | 研发中心 | 开发经理 | g_ms002
黄春建 | huangchunjian | chunjian-huang@santan-md.com | 运营中心-生产部 | 生产经理/制造经理 | g_ms002
詹佳丹 | zhanjiadan | jiadan-zhan@santan-md.com | 运营中心-质量部 | 质量经理 | g_ms002
赵枫 | zhaofeng | feng-zhao@santan-md.com | 运营中心-注册部 | 注册经理 | g_ms002
吴辉 | wuhui | hui-wu@santan-md.com | 研发中心-综合部 | 配置管理员（CMO） | g_ms002
雷俊勇 | leijunyong | junyong-lei@santan-md.com | 研发中心-开发部-电子组 | 硬件工程师(含嵌入式软件工程师) | g_ms002
jun | jun | jun@santan-md.com | 研发中心-开发部-软件组 | 软件工程师 | g_ms002
钱华芳 | qianhuafang | huafang-qian@santan-md.com | 研发中心-开发部-机械组 | 结构工程师 | g_ms002
王江 | wangjiang | jiang-wang@santan-md.com | 研发中心-测试部 | 测试工程师（软件/硬件） | g_ms002
王沙沙 | wangshasha | shasha-wang@santan-md.com | 战略发展中心-学术部 | 学术经理 | g_ms002
林鹏 | linpeng | peng-lin@santan-md.com | 产品中心-知识产权部 | 知识产权经理 | g_ms002
黄凌寒 | huanglinghan | linghan-huang@santan-md.com | 综合管理中心-企宣部 | 企宣经理 | g_ms002
颜廷威 | yantingwei | tingwei-yan@santan-md.com | 运营中心-生产部-工程技术组-设备结构工程师 | 新产品导入工程师（NPI） | g_ms002
程焕 | chenghuan | huan-cheng@santan-md.com | 运营中心-质量部 | 研发质量保证主管/工程师（DQA） | g_ms002
钟国银 | zhongguoyin | guoyin-zhong@santan-md.com | 综合管理中心-人事行政部 | HR经理 | g_ms002
孙盼 | sunpan | pan-sun@santan-md.com | 市场管理中心-客户服务部-项目服务组 | 下游产品经理 | g_ms002
戚利华 | qilihua | lihua-qi@santan-md.com | 运营中心-采购部 |  | g_ms002
王冰倩 | wangbingqian | bingqian-wang@santan-md.com | 研发中心 | UI | g_ms002
俞忆琳 | yuyilin | yilin-yu@santan-md.com | 研发中心
戴维焕 | daiweihuan | weihuan-dai@santan-md.com | 研发中心-开发部-软件组
杨斌 | yangbin | bin-yang@santan-md.com | 研发中心-开发部-软件组
童睿 | tongrui | rui-tong@santan-md.com | 研发中心-综合部
张彦彦 | zhangyanyan | yanyan-zhang@santan-md.com | 研发中心-测试部-软件测试组
高广文 | gaoguangwen | guangwen-gao@santan-md.com | 研发中心-开发部-软件组
王金海 | wangjinhai | jinhai-wang@santan-md.com | 研发中心-开发部-软件组
沈军 | shenjun | jun-shen@santan-md.com | 研发中心-开发部-电子组
姜璞 | jiangpu | pu-jiang@santan-md.com | 研发中心-测试部-软件测试组
魏宏悻 | weihongxing | hongxing-wei@santan-md.com | 研发中心-开发部-软件组
牛乾 | niuqian | qian-niu@santan-md.com | 研发中心-开发部-软件组
童俊强 | tongjunqiang | junqiang-tong@santan-md.com | 研发中心-开发部-电子组
易臣云 | yichenyun | chenyun-yi@santan-md.com | 研发中心-开发部-电子组
李苗 | limiao | miao-li@santan-md.com | 研发中心-测试部-软件测试组
郭宏瑞 | guohongrui | hongrui-guo@santan-md.com | 产品中心-产品部
蒋浩杰 | jianghaojie | haojie-jiang@santan-md.com | 研发中心-开发部-机械组
冯亮 | fengliang | liang-feng@santan-md.com | 研发中心-开发部-机械组
陈侠 | chenxia | xia-chen@santan-md.com | 研发中心-开发部-机械组
张巍 | zhangwei | wei-zhang@santan-md.com | 研发中心
姚欣 | yaoxin | xin-yao@santan-md.com | 研发中心-开发部-软件组
黄闻晶 | huangwenjing | wenjing-huang@santan-md.com | 研发中心-开发部-机械组
黄莹莹 | huangyingying | yingying-huang@santan-md.com | 运营中心-质量部-DQA
代码工程（GIT）
姓名 | Git账号 | 邮箱地址 | 部门 | 角色职责 | 权限组
