santan444/MS-002P/03-设计开发输出阶段/03软件/软件测试/MS-002网络安全测试用例_V1.0.xlsx

Sheet: 封皮
 |  |  | 文件号： | MS-002.30W014
MS-002
网络安全测试用例
 | 编制/时间： |  |  |  | 张彦彦/2022.08.12
 | 审核/时间： |  |  |  | 王江/2022.08.12
 | 批准/时间： |  |  |  | 张巍/2022.08.12
 |  | 杭州三坛医疗科技有限公司

Sheet: 更新履历
文档更改履历
版本号 | 发布日期 | 更改内容概述 | 更改者
1.0 | 2022.08.12 | 文件新编 | 张彦彦

Sheet: 安全
MS-002安全测试用例
用例编号 | 22项安全能力 | 是否适用 | 需求描述 | 用例名称 | 前提条件 | 操作步骤 | 预期结果
MS002_SC_NS_001 | 自动注销（ALOF） | 适用 | 长时间无人操作，自动注销 | 设置1分钟-操作员已登录-等1分钟-自动锁屏 | / | 1、设置1分钟-操作员已登录-等1分钟-自动锁屏 | 1、自动注销，显示锁屏页面；
MS002_SC_NS_002 | 自动注销（ALOF） | 适用 | 长时间无人操作，自动注销 | 设置30分钟-操作员已登录-等30分钟-自动锁屏 | / | 1、设置30分钟-操作员已登录-等30分钟-自动锁屏 | 1、自动注销，显示锁屏页面；
MS002_SC_NS_003 | 自动注销（ALOF） | 适用 | 长时间无人操作，自动注销 | 设置10分钟-工程师已登录-等10分钟-自动锁屏 | / | 1、设置10分钟-工程师已登录-等10分钟-自动锁屏 | 1、自动注销，显示锁屏页面；
MS002_SC_NS_004 | 自动注销（ALOF） | 适用 | 长时间无人操作，自动注销 | 设置10分钟屏-管理员已登录-等10分钟-自动锁屏 | / | 1、设置10分钟屏-管理员已登录-等10分钟-自动锁屏 | 1、自动注销，显示锁屏页面；
MS002_SC_NS_005 | 自动注销（ALOF） | 适用 | 长时间无人操作，自动注销 | 设置10分钟-用户未登录-等10钟-不会锁屏 | / | 1、设置10分钟-用户未登录-等10钟-不会锁屏； | 1、未锁屏；
MS002_SC_NS_006 | 审核控制（AUDT） | 适用 | 日志记录关键操作，记录警告及异常 | 进行任意操作-查看日志记录 | / | 1、进行以下操作开机，连接相机，登录，新建病例，发送X光，注册，规划螺钉，仿真，定位，发送评估图片，点击完成手术，导出，导入患者数据，机械臂自由拖动，收纳展开，连接，断开连接，开机，重启，定位，关机； | 1、记录相关操作日志及错误信息；
MS002_SC_NS_007 | 审核控制（AUDT） | 适用 | 确认提示 | 关机-“关闭前，请确保机械臂已运动至收纳位！” | / | 1、定位完成； 2、点击关机； | 1、提示“关闭前，请确保机械臂已运动至收纳位！”；
MS002_SC_NS_008 | 审核控制（AUDT） | 适用 | 确认提示 | 重复导入病例-提示“当前患者已存在，是否覆盖” | / | 1、导入已存在病例； | 1、提示“当前患者已存在，是否覆盖？”；
MS002_SC_NS_009 | 审核控制（AUDT） | 适用 | 确认提示 | 选择未结束的手术-下一步-提示“当前手术未完成，是否结束手术？” | / | 1、选中未结束的手术； 2、点击下一步； | 1、提示“当前手术未完成，是否结束手术？”；
MS002_SC_NS_010 | 审核控制（AUDT） | 适用 | 确认提示 | 工具次数达到使用上限-提示“工具已达到最大使用次数，请更换！” | / | 1、工具使用次数达到上限； 2、再次选择工具； | 1、提示“工具已达到最大使用次数，请更换！”；
MS002_SC_NS_011 | 审核控制（AUDT） | 适用 | 确认提示 | 注册成功或失败-有相关提示 | / | 1、进入X光注册页面； 2、拍X光注册成功； 3、遮挡示踪器，注册X光片； | 1、注册成功，提示“注册成功，当前采用正位参数进行注册，注册精度为xxx，请确认”； 注册失败，提示“示踪器被遮挡，请移动相机位置或点击取消按钮”；
MS002_SC_NS_012 | 审核控制（AUDT） | 适用 | 确认提示 | 未仿真定位-提示“请先进行仿真，再进行定位操作。” | / | 1、已设置先仿真后定位； 2、未仿真定位导航页面，选中螺钉点击定位； | 1、提示“请先进行仿真，再进行定位操作。”；
MS002_SC_NS_013 | 授权（AUTH） | 适用 | 不同账户拥有不同权限 | 管理员登录-只能添加账户-查看所有患者数据 | / | 1、管理员登录； 2、点击设置，添加账户； 3、查看所有患者数据，新增病例； | 1、只能添加账户，其他设置项可见点击无效，可以查看所有患者病例，但不能新增病例；
MS002_SC_NS_014 | 授权（AUTH） | 适用 | 不同账户拥有不同权限 | 工程师登录-进行设置及其他操作 | / | 1、管理员登录； 2、点击设置，点击工具参数； 3、新增病例，查看所有患者数据； | 1、可以新增病例，可以查看所有患者病例，设置页面除新增账户外，可以查看工具和进行其他操作；
MS002_SC_NS_015 | 授权（AUTH） | 适用 | 不同账户拥有不同权限 | 操作员登录-点击设置-查看病例 | / | 1、操作员登录，点击设置； 2、查看病例，操作； | 1、设置无权访问，仅能查看自己账号下的病例，可操作；
MS002_SC_NS_016 | 节点鉴别（NAUT） | 适用 | AEtitle设置正确可发送图片 | AEtitle设置不正确-C臂机图片无法发送到控制软件 | / | 1、本地配置文件AEtitle修改为test，保存，重启软件，C臂机发送X光注册； | 1、未接收到X光片；
MS002_SC_NS_017 | 节点鉴别（NAUT） | 适用 | AEtitle设置正确可发送图片 | AEtitle正确-C臂机图片可以发送到控制软件 | / | 1、本地配置文件AEtitle为santan，保存，重启软件，C臂机发送X光注册； | 1、控制软件接收到X光片，与C臂机原图一致；
MS002_SC_NS_018 | 节点鉴别（NAUT） | 适用 | NDI设备号正确可连接 | NDI设备号不正确-相机断开连接-查看相机状态-无法导航 | / | 1、NDI设备号不正确； 2、重启软件，查看相机状态； | 1、相机未连接状态；
MS002_SC_NS_019 | 节点鉴别（NAUT） | 适用 | NDI设备号正确可连接 | NDI设备号正确--查看相机状态 | / | 1、NDI设备号正确； 2、重启软件，查看相机状态； | 1、相机显示连接状态；
MS002_SC_NS_020 | 人员鉴别（PAUT） | 适用 | 需要身份验证才能登陆 | 用户登录-输入正确密码 | / | 1、操作员、工程师、管理员输入正确密码登录； | 1、登录成功；
MS002_SC_NS_021 | 人员鉴别（PAUT） | 适用 | 需要身份验证才能登陆 | 用户登录-输入错误密码 | / | 1、操作员、工程师、管理员输入错误密码登录； | 1、提示密码不正确，请重新输入；
MS002_SC_NS_022 | 连通性（CONN） | 不适用 | / | / | / | / | /
MS002_SC_NS_023 | 物理防护（PLOK） | 适用 | 硬盘在主机内，主机在台车内，硬盘不会被轻松取出 | 查看硬盘在主机内的位置 | / | 1、查看硬盘在主机内的位置； | 1、硬盘在主机内部，主主机在台车内，硬盘不会被轻松取出；
MS002_SC_NS_024 | 系统加固（SAHD） | 不适用 | / | / | / | / | /
MS002_SC_NS_025 | 数据去标识化与匿名化（DIDT） | 适用 | 导入数据/新建病例-查看数据是否包含个人敏感信息 | 新建病例-导入历史病例-查看软件内是否包含患者敏感信息 | / | 1、新建病例二维模式，填写所有信息，查看软件是否包含敏感数据； 2、新建病例二配三模式，导入CT，导入完成，查看软件页面是否包含敏感数据； 3、导入手术完成的历史病例，查看是否包含敏感数据； | 1、患者信息内不包含敏感数据身份证号、住址；
MS002_SC_NS_026 | 数据去标识化与匿名化（DIDT） | 适用 | 导出数据-查看数据是否包含个人敏感信息 | 导出手术完成的患者病例-查看是否包含敏感信息 | / | 1、患者管理页面，选中定位完成的病例； 2、点击导出病例，查看导出的文件内是否包含敏感信息； | 1、仅有CT、X光、截图、病例信息不包含敏感数据身份证号、住址；
MS002_SC_NS_027 | 数据完整性与真实性（IGAU） | 适用 | 导出病例后-再导入病例，数据完整 | 定位完成-导出病例-导入病例-查看数据 | / | 1、定位完成，导出病例； 2、再次导入病例，查看数据是否完整真实； | 1、导出后数据包含CT数据（手术中选中的序列）、软件使用中的截图、发送的所有X光片、json文件（包含X光的矩阵数据、规划螺钉数据）、患者病例信息的json文件；导入 数据与导出前一致；
MS002_SC_NS_028 | 数据备份与灾难恢复（DTBK） | 适用 | 规划完成后-拔电源-重启 | 规划完成后-拔电源-重启-查看历史数据是否存在 | / | 1、规划螺钉后，点击下一步； 2、拔电源，重启； 3、查看X光及规划数据是否存在； | 1、病例信息、X光片及规划数据存在；
MS002_SC_NS_029 | 数据备份与灾难恢复（DTBK） | 适用 | 定位完成后-拔电源-重启 | 定位完成后-拔电源-重启-查看历史数据是否存在 | / | 1、定位完成后； 2、拔电源，重启，查看历史数据； | 1、导入的数据、规划数据、X光片数据、配准数据存在；
MS002_SC_NS_030 | 数据存储保密性与完整性（STCF） | 适用 | 禁用windows所有快捷键 | 按任意windows快捷键-不能进入windows桌面 | / | 1、按任意windows快捷键组合键； | 1、不能进入windows桌面；
MS002_SC_NS_031 | 数据存储保密性与完整性（STCF） | 适用 | 导出日志输入错误密码-不能查看日志 | 导出日志加密-输入错误密码 | / | 1、导出日志格式为log××.santan，输入错误密码123456； | 1、不能查看日志；
MS002_SC_NS_032 | 数据存储保密性与完整性（STCF） | 适用 | 导出病例输入错误密码-不能查看病例 | 导出病例加密-输入错误密码 | / | 1、导出病例格式为hz××.zip，输入错误密码123456； | 1、不能查看病例；
MS002_SC_NS_033 | 数据存储保密性与完整性（STCF） | 适用 | 导出日志输入正确密码-可以查看日志 | 导出日志加密-输入正确密码 | / | 1、导出日志log××.santan，输入正确密码santan； | 1、能查看日志；
MS002_SC_NS_034 | 数据存储保密性与完整性（STCF） | 适用 | 导出病例输入正确密码-可以查看病例 | 导出病例加密-输入正确密码 | / | 1、导出病例格式为hz××.zip，输入正确密码santan； | 1、能查看病例；
MS002_SC_NS_035 | 传输保密性（TXCF） | 适用 |  |  | /
MS002_SC_NS_036 | 传输完整性（TXIG） | 适用 | 网络通讯功能遵循内部加密协议，保证了软件网络安全的传输保密性和完整性能力 | 发送X光到控制软件，X光与C臂机图片一致 | / | 1、发送X光到控制软件； 2、查看控制软件收到的X光与C臂机拍的X光是否一致； | 1、控制软件收到的X光与C臂机拍的X光一致；
MS002_SC_NS_037 | 网络安全补丁升级（CSUP） | 不适用 | / | / | / | / | /
MS002_SC_NS_038 | 现成软件清单（SBOM） | 不适用 | / | / | / | / | /
MS002_SC_NS_039 | 现成软件维护（RDMP） | 不适用 | / | / | / | / | /
MS002_SC_NS_040 | 网络安全使用指导（SGUD） | 适用 | 加强人员培训，不需要测试 | / | / | / | /
MS002_SC_NS_041 | 网络安全特征配置（CNFS） | 不适用 | / | / | / | / | /
MS002_SC_NS_042 | 紧急访问（EMRG） | 不适用 | / | / | / | / | /
MS002_SC_NS_043 | 远程访问与控制（RMOT） | 不适用 | / | / | / | / | /
MS002_SC_NS_044 | 恶意软件探测与防护（MLDP） | 适用 | windows Defender | windows Defender实时开启防护-防止恶意软件探测 | / | 1、windows Defender实时开启防护； | 1、windows Defender实时开启；
