santan444/MS-002P/03-设计开发输出阶段/02电子/03线缆图/MS-002执行台车线缆统计表.xls

编号 | 线缆名称 | 原线长(mm) | 制作线长(mm) | 预留线长(mm) | 说明
W1 | 220V网电源输入线缆 | 火线：470 零线：740 | 火线：490 零线：760 | 火线：20 零线：20 | 零线使用隔离变压器自带线缆
W2-1 | 电源指示灯线 | 67 | 80 | 13
W2-2 | 电源指示灯线 | 67 | 80 | 13
W3 | 隔离变压器火线初级 | 270 | 280 | 10
W4 | UPS输入线 | 890 | 900 | 10 | UPS自带线缆
W5 | UPS输出线 | 530 | 500 | -30
W6 | 机械臂电源线 | 180 | 200 | 20
W7 | 24V开关电源输入线 | 450 | 470 | 20
W8 | 后面板接地线 | 170 | 190 | 20
W9 | UPS接地线 | 185 | 200 | 15
W10 | 分线器接地线 | 120 | 140 | 20
W11 | 升降控制板电源线 | 450 | 470 | 20
W12 | 台车控制板电源线 | 375 | 390 | 15
W13-1 | 充电指示灯线 | 67 | 80 | 13
W13-2 | 机械臂带灯按钮线 | 525 | 550 | 25
W14 | 前面板指示灯线 | 660 | 680
W15 | 机械臂启停线 | 725 | 740 | 15
W16 | USB | 1125 | 1500 | 375 | 采购1.5m USB线
W17 | 升降立柱1自带线 | 1178 | 1200 | 22 | 升降立柱自带线缆改装
W18 | 升降立柱2自带线 | 1178 | 1200 | 22
W19 | 升降立柱3自带线 | 1140 | 1160 | 20
W20 | 升降立柱4自带线 | 962 | 980 | 18
W21 | 台车升降线 | 420 | 440 | 20
W22 | 台车状态线 | 680 | 700 | 20
W23 | UR检测线 | 665 | 680 | 15
W24 | 急停开关线 | 810 | 830 | 20
W25 | 网线 | 100 | 500 | 400 | 采购0.5m八类网线
W26 | 网线 | 100 | 500 | 400
W27 | 网线 | 600 | 500 | -100
W28 | USB线 | 200 | 350 | 150
W29 | 机械臂线缆 | 500 | 500 | 0 | 机械臂自带线，不作处理
W30 | 条形灯板到圆形灯板连接线 | 330 | 340 | 10
W31-1 | 脚踏线 | 850 | 870 | 20
W31-2 | 无线脚踏电源线 | 1000 | 1000 | 0
W32 | 隔离变压器接地线 | 150 | 170 | 20
W33 | 灯板连接线 | 50 | 60 | 10
W34 | UR上电反馈线 | 1000 | 950 | -50
W35 | 末端控制板连接线 | 100 | 100 | 0 | 采购1.25双头端子线
