santan444/MS-002P/03-设计开发输出阶段/02电子/MS-002.21T001-台车控制板/06_装配图/MS-002.21W007 台车控制板装配图 V1.0.docx

台车控制板

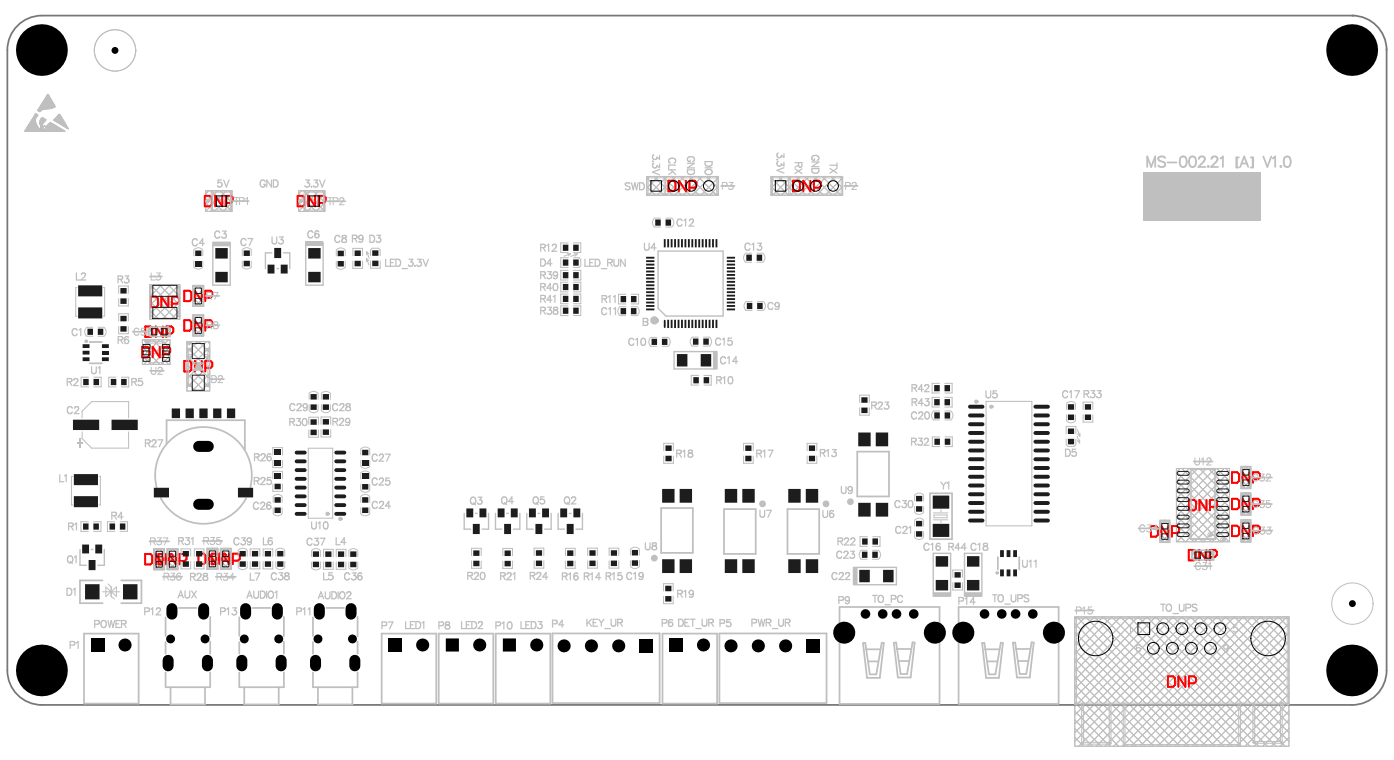
[picture p321: figure]

C5,C31,C32,C33,C34,C35,D2,L3,P2,P3,P15,R7,R8,R34,R35,R36,

R37,TP1,TP2,U2,U12不焊接

MS-002.21T007 V1.0
