santan444/MS-002P/03-设计开发输出阶段/02电子/MS-002.22T001-末端控制板/06_装配图/MS-002.22W007末端控制板装配图 V1.0.docx

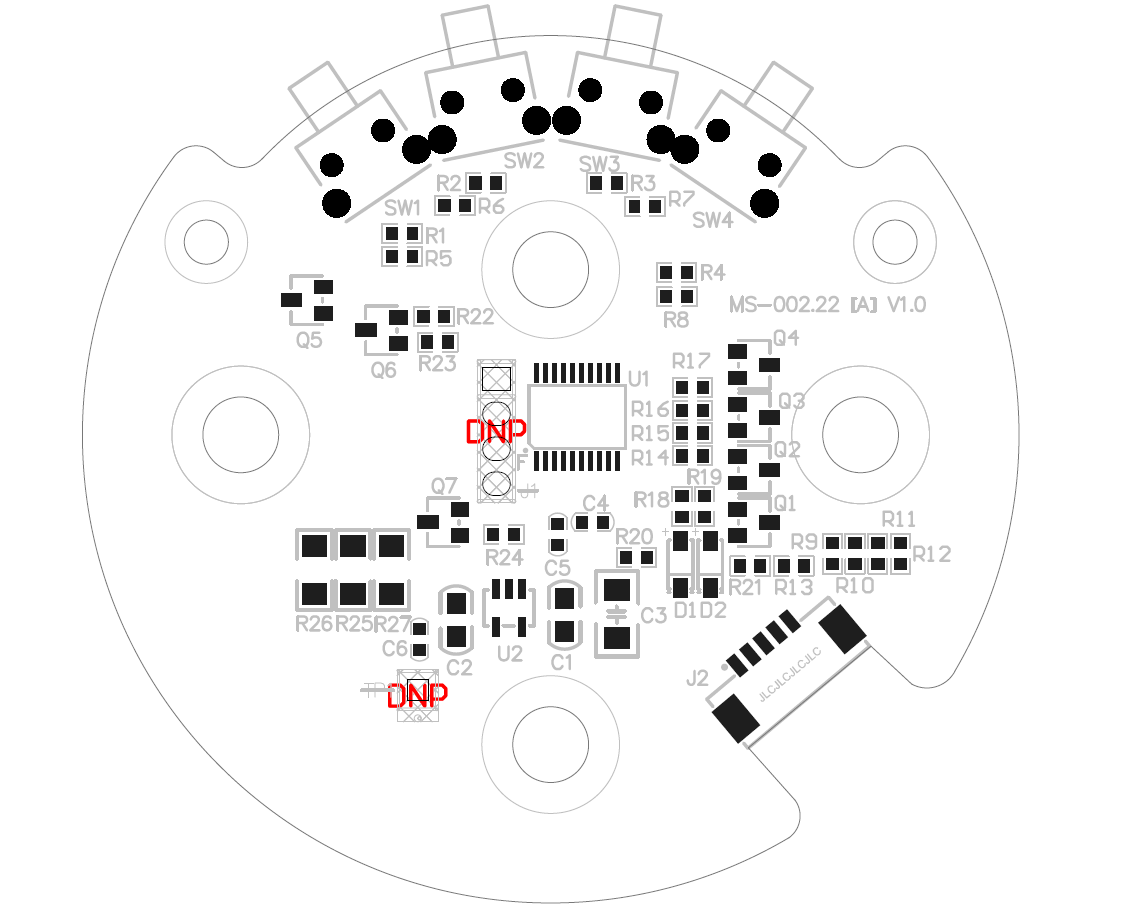
[picture p322: figure]

末端控制板

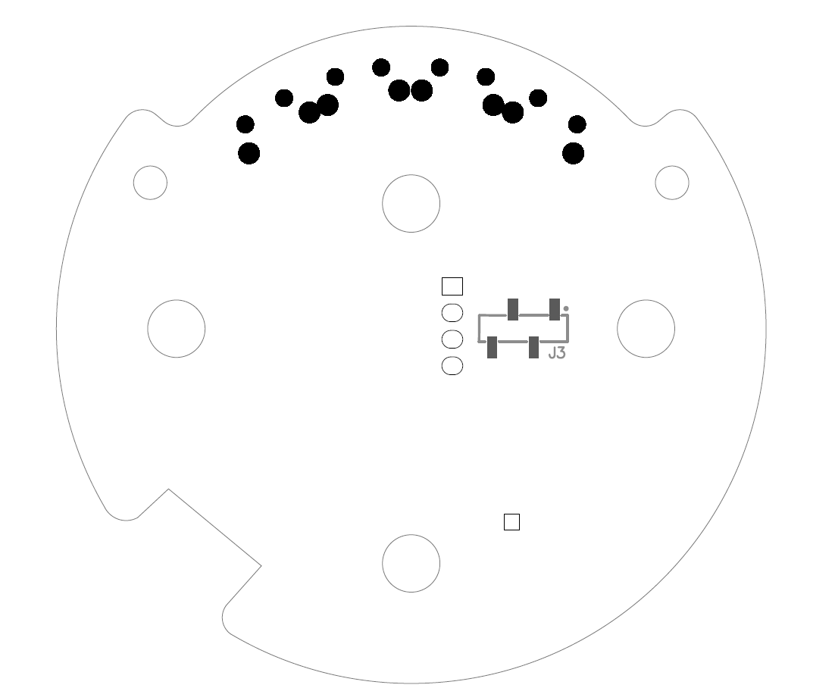
[picture p323: figure]

MS-002.22T007 V1.0

J1，TP1 不焊接
