santan444/MS-002P/03-设计开发输出阶段/02电子/MS-002.24T001-末端灯板/06_装配图/MS-002.24W007 末端灯板装配图 V1.0.docx

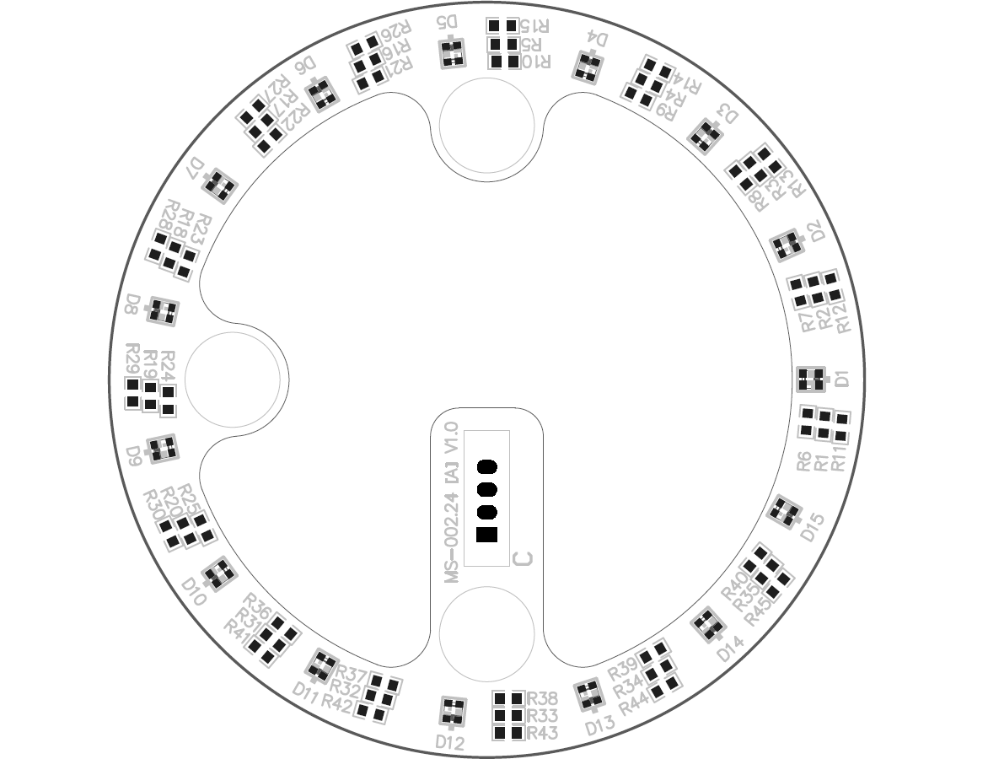
[picture p324: figure]

末端灯板

MS-002.24W007 V1.0
