santan444/MS-002P/03-设计开发输出阶段/02电子/MS-002.25T001-末端连接板/06_装配图/MS-002.25W007 末端连接板装配图 V1.0.docx

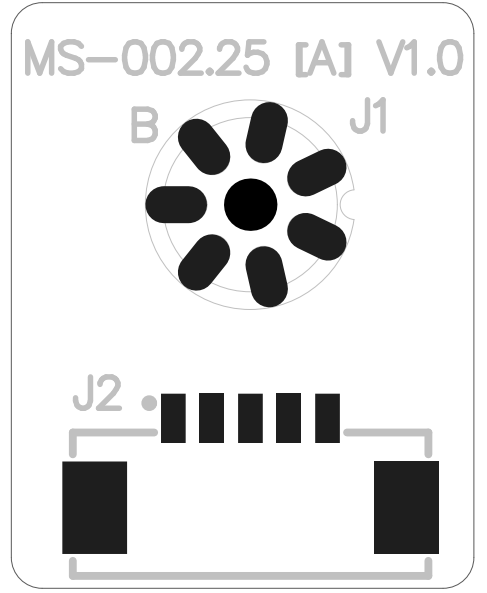
[picture p325: figure]

末端连接板

MS-002.25W007 V1.0
