santan444/MS-002P/03-设计开发输出阶段/02电子/MS-002.27T001-导航台车LED灯环/06_装配图/MS-002.27W007 导航台车LED灯环装配图 V1.0.docx

导航台车LED灯环

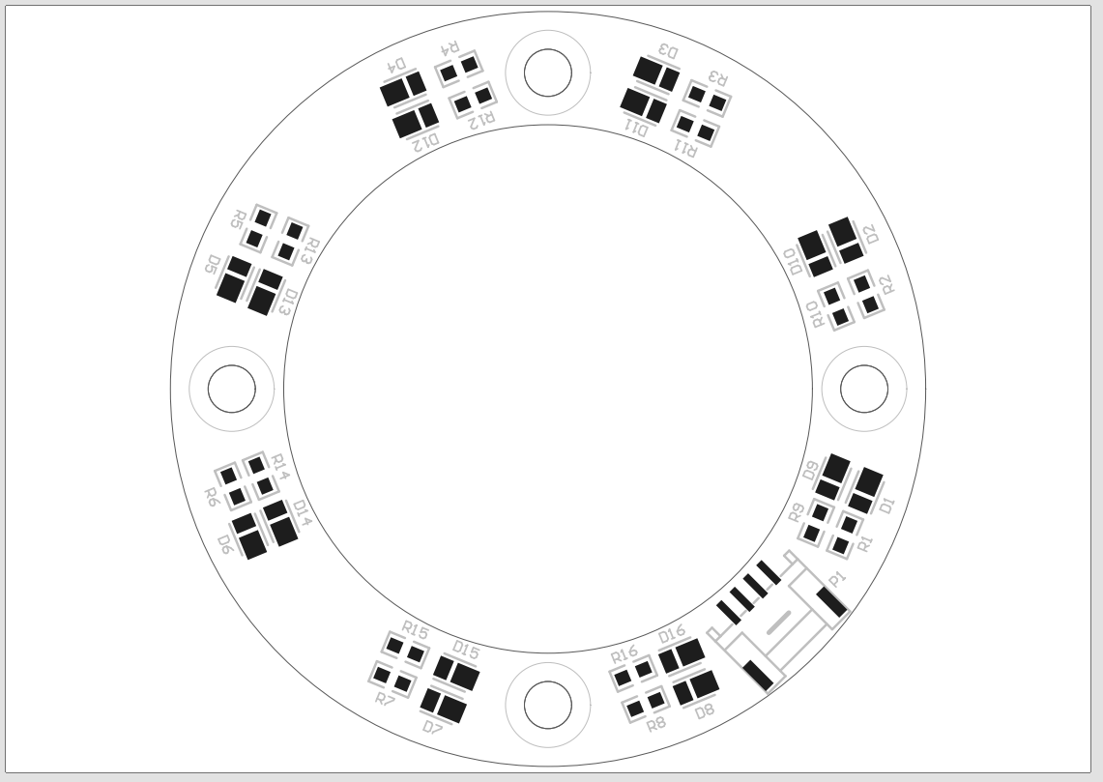
[picture p326: figure]
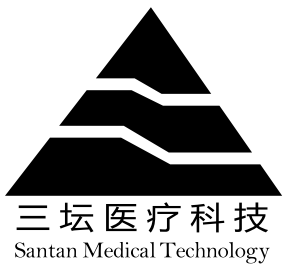
[picture p327: figure]

MS-002.27W007 V1.0
