santan444/MS-002P/03-设计开发输出阶段/02电子/MS-002.28T001-条形灯板/06_装配图/MS-002.28W007 执行台车LED灯板装配图 V1.0.docx

MS-002.28W007 V1.0

顶层

执行台车LED灯板

执行台车LED灯板

MS-002.28W007 V1.0

底层
