santan444/MS-002P/03-设计开发输出阶段/02电子/MS-002.29T001-执行台车LED灯环/06_装配图/MS-002.29W007 执行台车LED灯环装配图 V1.0.docx

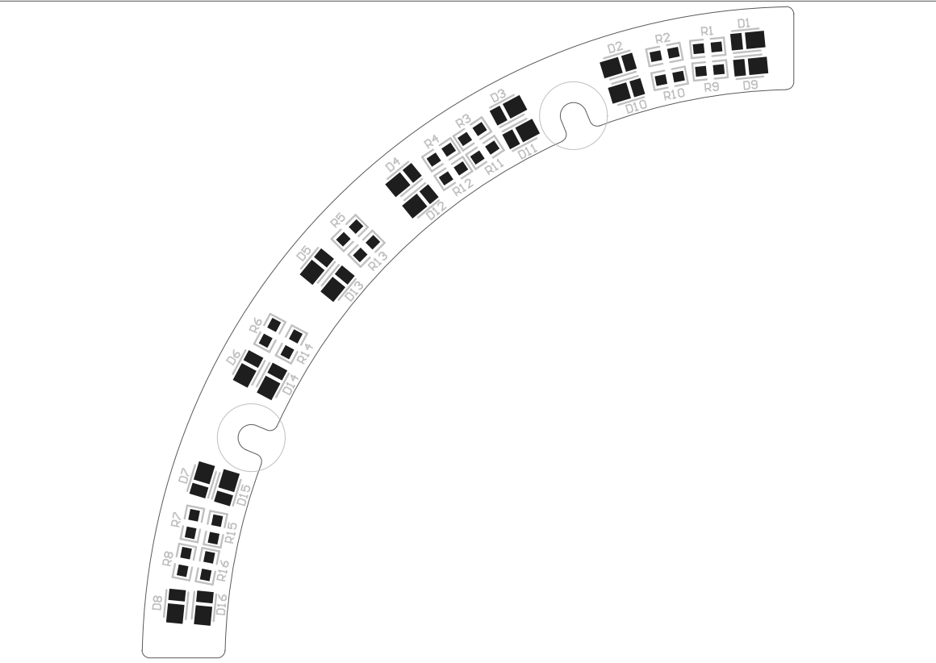
[picture p328: figure]

MS-002.29W007 V1.0


执行台车LED灯环

顶层

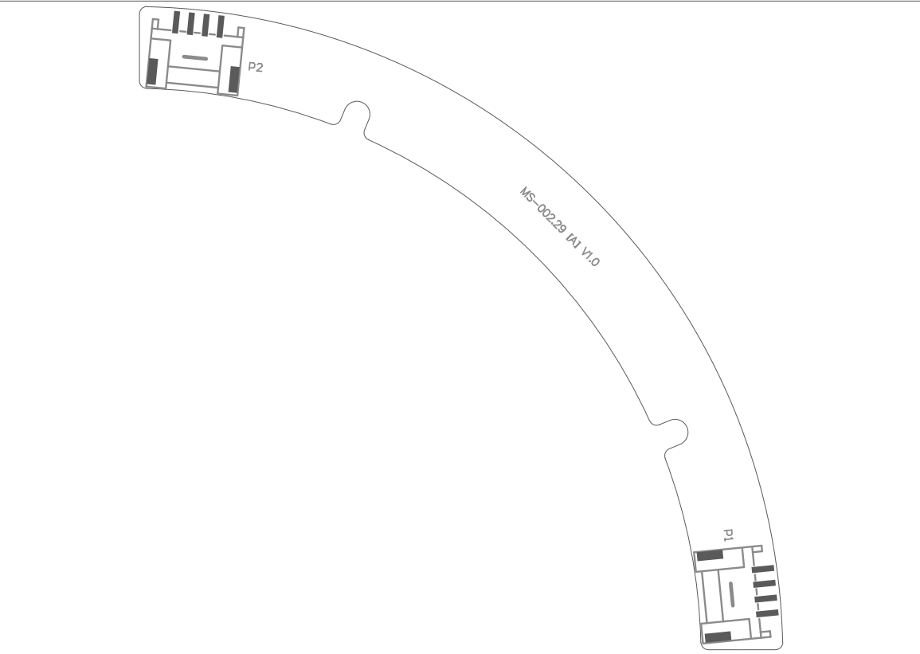
[picture p329: figure]

执行台车LED灯环

MS-002.29W007 V1.0

底层
