santan444/MS-002P/03-设计开发输出阶段/02电子/MS-002.21T001-台车控制板/06_装配图/MS-002.21W007 台车控制板装配图 V1.0.pdf

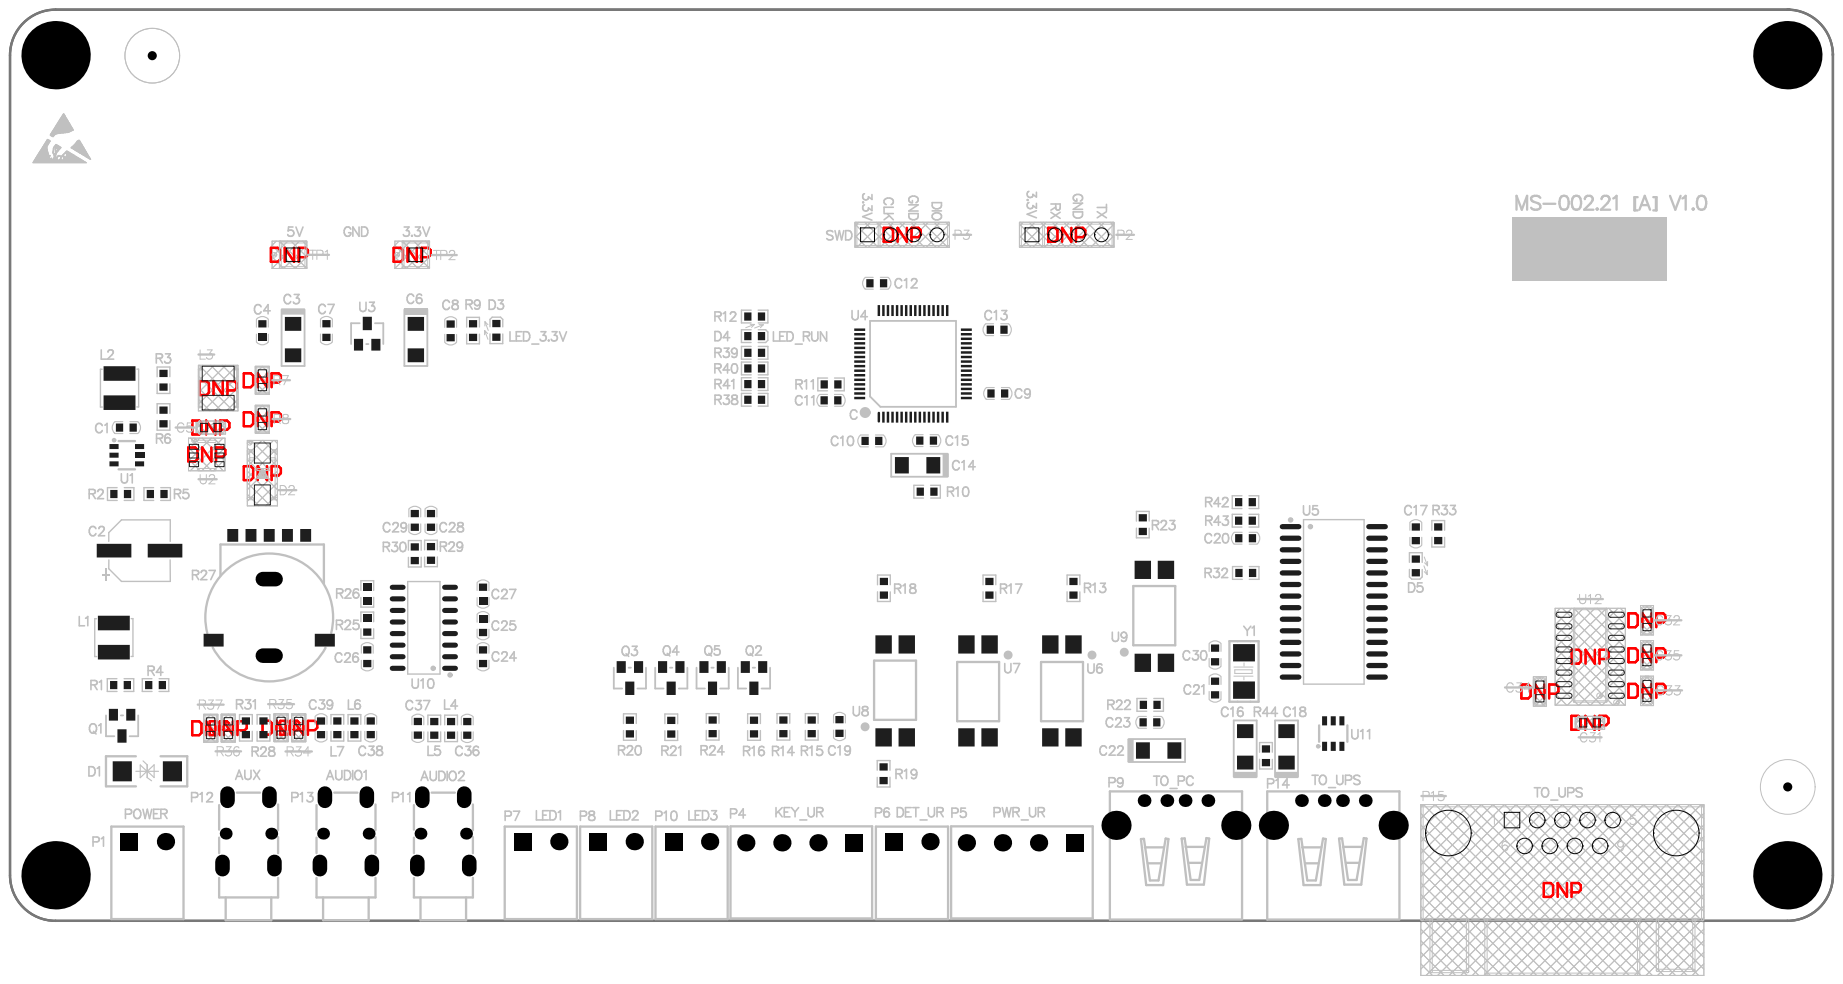
[picture p330: page 1]
