santan444/MS-002P/03-设计开发输出阶段/02电子/MS-002.22T001-末端控制板/06_装配图/MS-002.22W007末端控制板装配图 V1.0.pdf

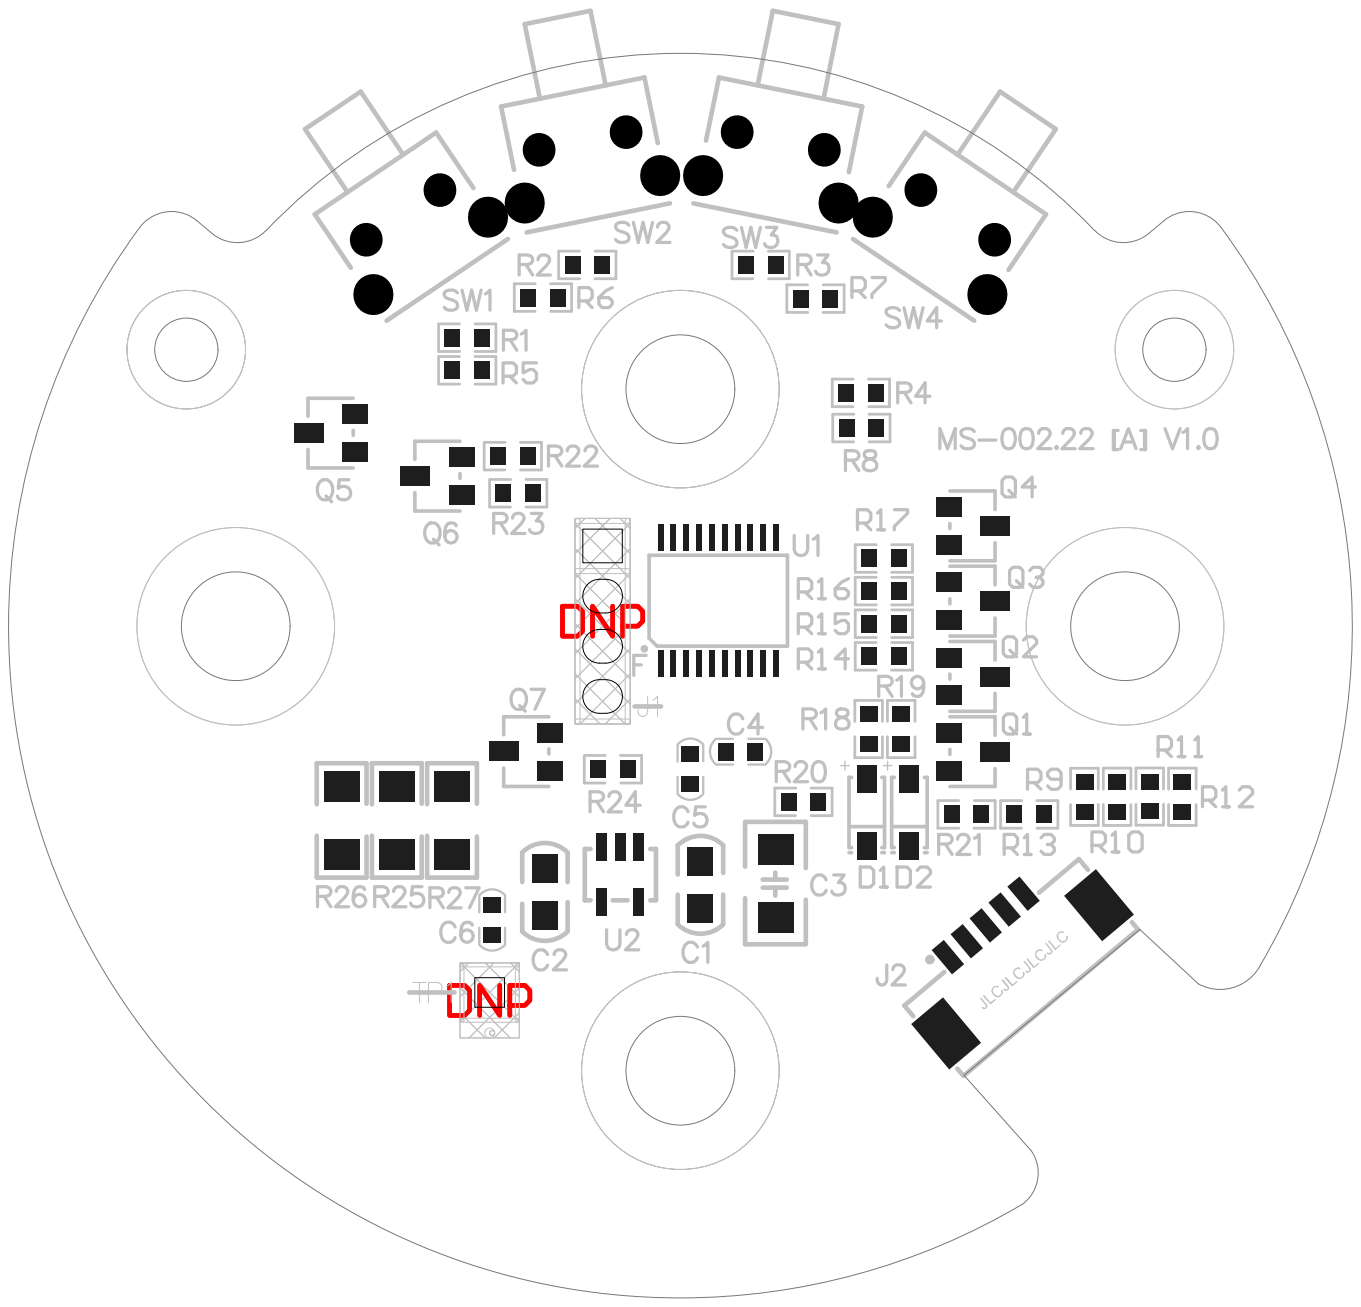
[picture p331: page 1]

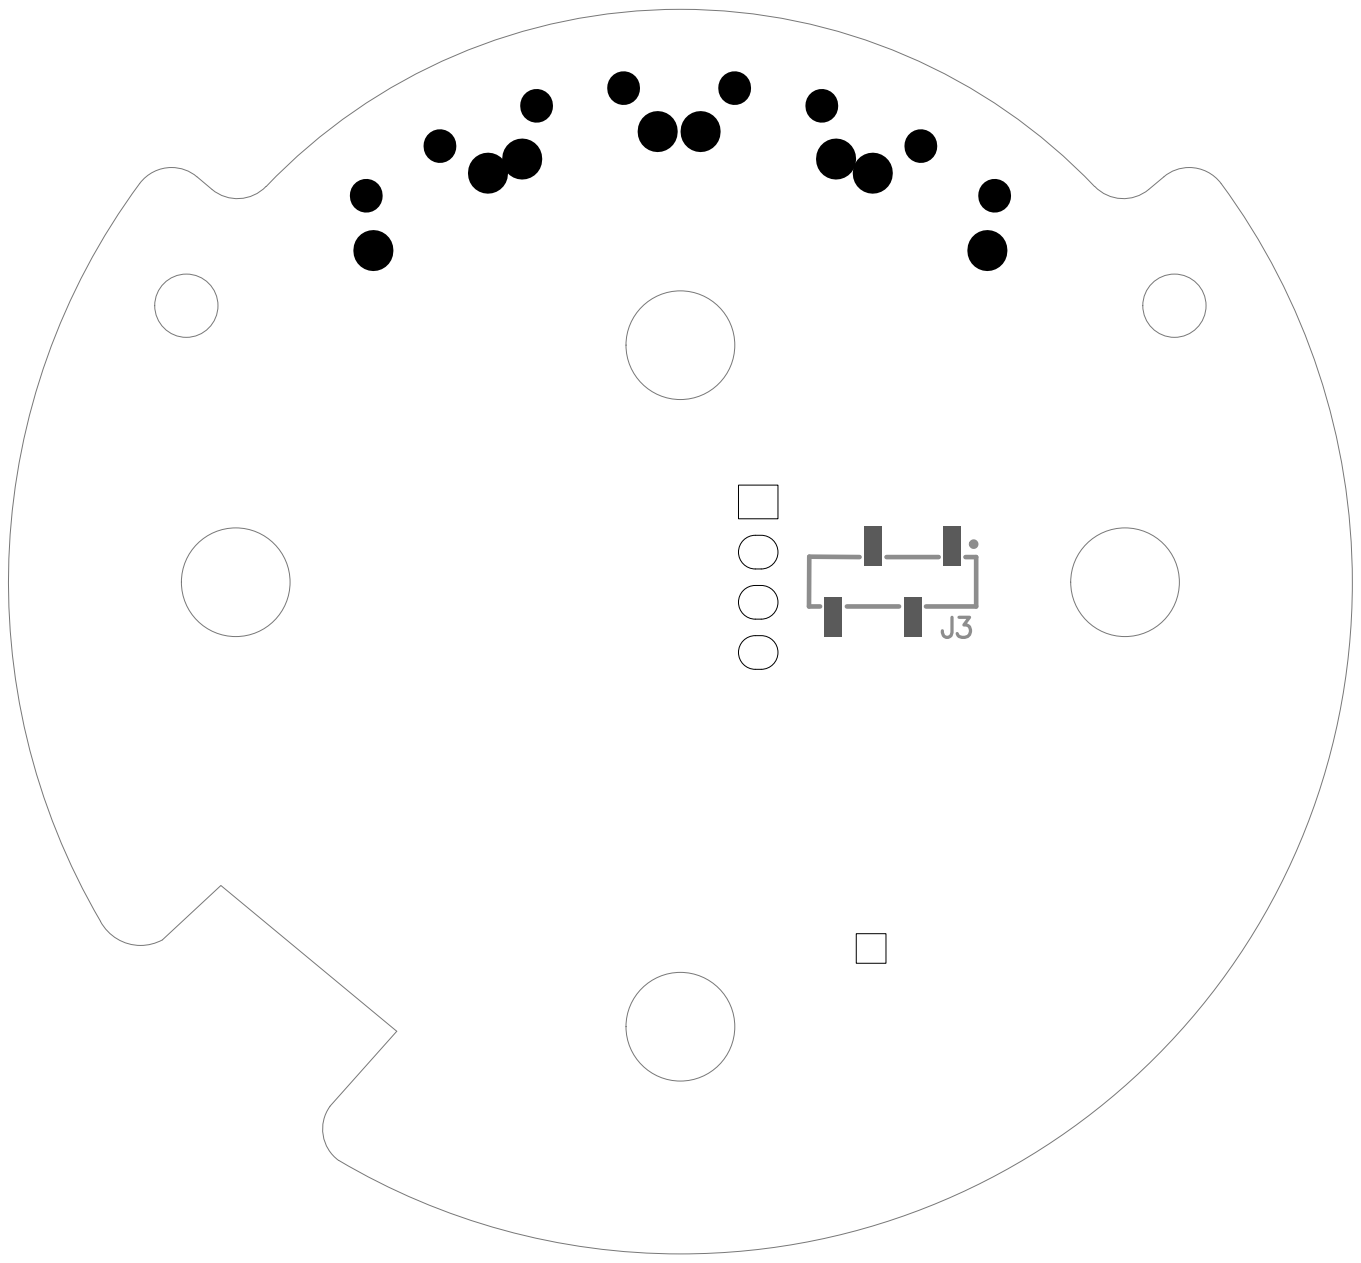
[picture p332: page 2]
