santan444/MS-002P/(list of files, drawings)

Other design files:
03-设计开发输出阶段/02电子/MS-002.24T001-末端灯板/02_PCB/MS-002.24T003末端灯板PCB图 V1.0.PcbDoc
03-设计开发输出阶段/02电子/MS-002.25T001-末端连接板/02_PCB/MS-002.25T003末端连接板PCB图 V1.0.PcbDoc
03-设计开发输出阶段/02电子/MS-002.28T001-条形灯板/02_PCB/MS-002.28T003.PcbDoc
